Szymek200/Smart-ball/Documents/Smart-piłka_prez.pptx

## Smart-piłka

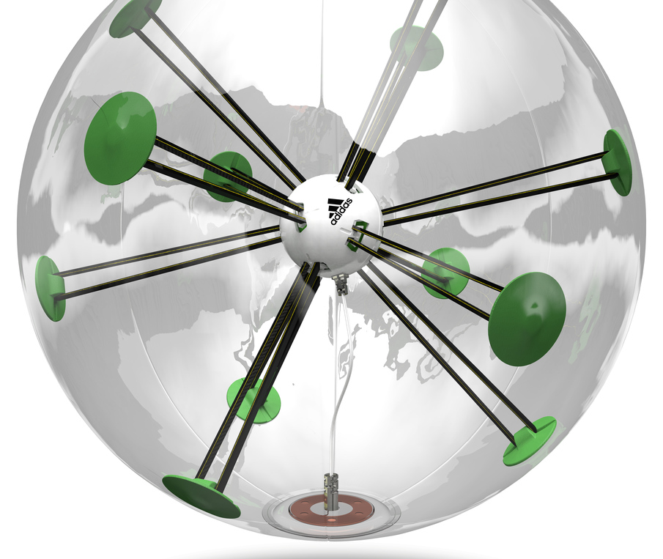
[picture p12: figure]
adidas smart ball Cheap Sale - OFF 55%

## Wymagania

- Wykrywanie:
  - Przyśpieszenia liniowego
  - przyśpieszenia kątowego
- Łączność bezprzewodowa do wymiany informacji z telefonem
  - Bluetooth

## Schemat blokowy systemu

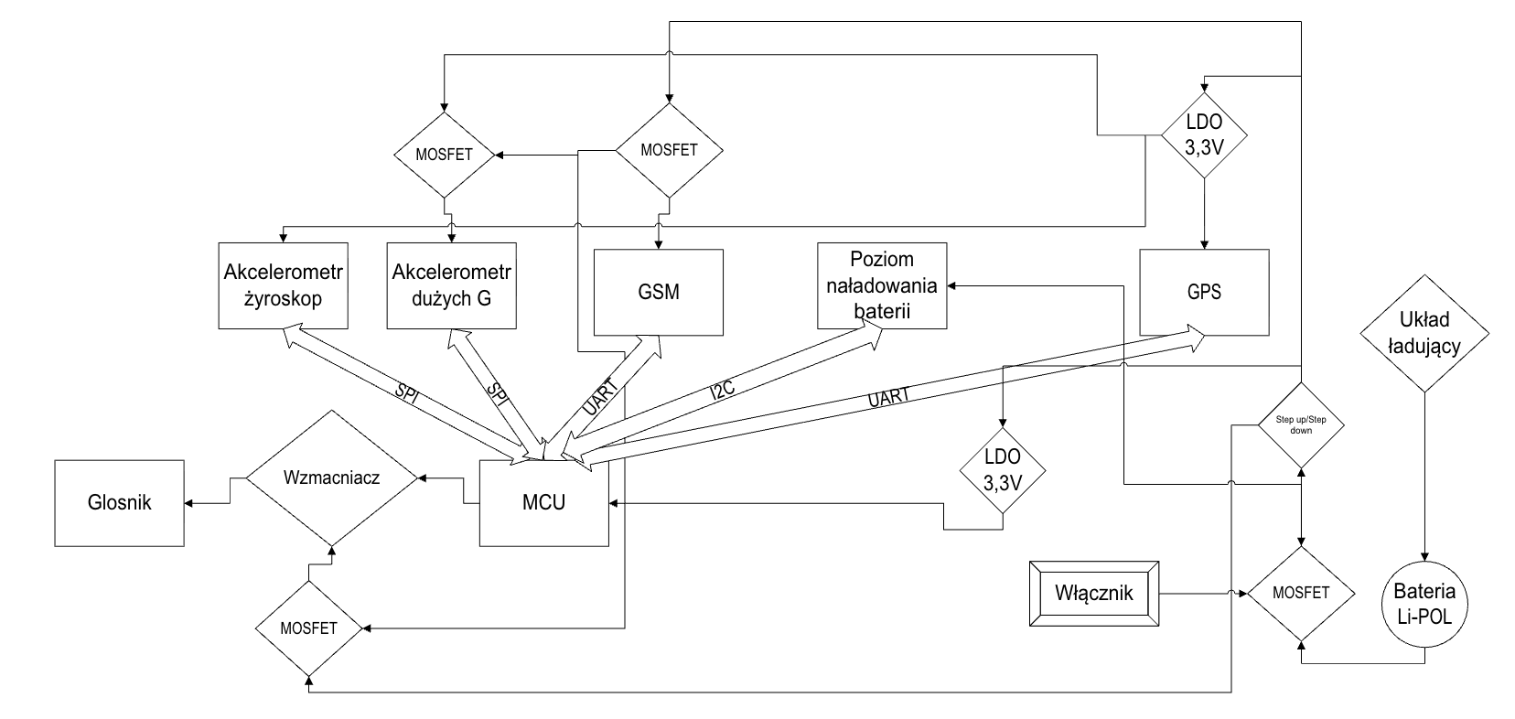
[picture p13: figure]

## Zasada działania

- Pomiary
- Gromadzenie i wyświetlanie informacji w aplikacji mobilnej
- Poszukiwanie zgubionej piłki za pomoca telefonu (GPS, głośnik, łączność z tel. poprzez GSM)

## Pomiary

- bezpośrednie
  - przyśpieszenie liniowe
  - prędkość kątowa
- pośrednie
  - podkręcenie piłki
  - efekt Magnusa – jak mocno piłka skręci
  - lokalizacja uderzenia piłki

## Funkcjonalności

- Wirtualny Asystent Techniki
- Generowanie trójwymiarowego modelu lotu piłki
- Heatmapa Boiska
- Ranking gracza – zestawienie online
- Dziennik postępów
- Analiza gry zespołowej – za pomocą tagów Bluetooth

## Statystyki

- prędkość wylotowa
- rotacja
- typ rotacji
- czas kontaktu
- dystans strzału
- czas lotu
- kąt wzniosu
- całkowity dystans ( czasie rozgrywki)
- liczba kontaktów
- intensywność gry
- liczba podbić - żonglerka

## Środowisko programistyczne

VS Code + ESP-IDF

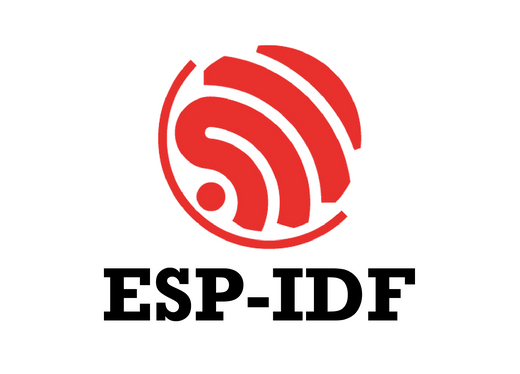
[picture p14: figure]
Getting Started With ESP-IDF | Set Up Espressif IDE – RoboticWorx
