Szymek200/Smart-ball/PCB/components_shopping.xlsx

Type | Product | Sposob montarzu | ilosc | price | Link
ladowarka indukcyjna | BQ51013BRHLR | smd |  | 13.00 PLN | https://www.mouser.pl/ProductDetail/Texas-Instruments/BQ51013BRHLR?qs=y1vSg4rOnUJlN8ZPg6D5Pw%3D%3D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
zabezpieczenie usb | USBLC6-2SC6Y |  |  | 1.66 PLN | https://www.mouser.pl/ProductDetail/STMicroelectronics/USBLC6-2SC6Y?qs=gNDSiZmRJS%2FOgDexvXkdow%3D%3D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
zlacze usb | UJ20-C-H-G-MSMT-P16-TR | Mid-Mount SMT |  | 2.30 PLN | https://www.mouser.pl/ProductDetail/Same-Sky/UJ20-C-H-G-MSMT-P16-TR?qs=IKkN%2F947nfDXyScpVo9Ppg%3D%3D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
battery charger | MCP73871-2CCI/ML | smd |  | 8.70 PLN | https://www.mouser.pl/ProductDetail/Microchip-Technology/MCP73871-2CCI-ML?qs=qXsUupcbpXyQfJ2clznZxw%3D%3D
battery measure | MAX17048G+T10 | smd |  | 15.00 PLN | https://www.mouser.pl/ProductDetail/Analog-Devices-Maxim-Integrated/MAX17048G%2BT10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
przelacznik bistabilny | SLW-1276864-4A-D |  |  | 2.70 PLN | https://www.mouser.pl/ProductDetail/Same-Sky/SLW-1276864-4A-D?qs=1Kr7Jg1SGW90vOt02EYiag%3D%3D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
zlacze ata | DS1013-40SSIB1-B-0 CONNFLY - Złącze IDC |  |  | 1.70 PLN | https://www.tme.eu/pl/details/zl231-40pg/zlacza-idc/connfly/ds1013-40ssib1-b-0/
akcelerometr | H3LIS331DLTR | smd |  | 42.50 PLN | https://www.mouser.pl/ProductDetail/STMicroelectronics/H3LIS331DLTR?qs=TAo1I7FhABsAZFqkqNUSRA%3D%3D
imu | LSM6DSV16BXTR | smd |  | 24.00 PLN | https://www.mouser.pl/ProductDetail/STMicroelectronics/LSM6DSV16BXTR?qs=vvQtp7zwQdMXKB4RqH7GHQ%3D%3D
5v | TPS61032PWPR | smd na zewnatrz |  | 16.00 PLN | https://www.mouser.pl/ProductDetail/Texas-Instruments/TPS61032PWPR?qs=Gse6rAGbi799IFpSGIkCOQ%3D%3D
3,3v | TPS63000IDRCRQ1 | smd |  | 11.00 PLN | https://www.mouser.pl/ProductDetail/Texas-Instruments/TPS63000IDRCRQ1?qs=i6VRxKQL%2FYw6zzUuY%2FiBvw%3D%3D
mcu | ESP32-S3-WROOM-1-N4R8 | smd |  | 22.00 PLN | https://www.mouser.pl/ProductDetail/Espressif-Systems/ESP32-S3-WROOM-1-N4R8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
push button | 1825910-6 |  | 2 | 0.50 PLN | https://www.mouser.pl/ProductDetail/TE-Connectivity/1825910-6?qs=A6cQTCBcXncisYDS1KbpGA%3D%3D
gps | NEO-F10N-00B | smd |  | 48.00 PLN | https://www.mouser.pl/ProductDetail/u-blox/NEO-F10N-00B?qs=Imq1NPwxi76uVH%2FItRhLgw%3D%3D
laczenie anten | 4259-63 | smd na zewnatrz |  | 2.80 PLN | https://www.mouser.pl/ProductDetail/pSemi/4259-63?qs=iw0hurA%2FaD37qvQcKdATTw%3D%3D
wzmacanicz glosnik | MAX98357AETE+T | smd |  | 13.06 PLN | https://www.mouser.pl/ProductDetail/Analog-Devices-Maxim-Integrated/MAX98357AETE%2BT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
gsm | SIM7000G | smd |  | 91.00 PLN | https://www.digikey.pl/pl/products/detail/simcom-wireless-solutions-limited/SIM7000G/15841469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
poziomy logiczne | TXB0104PWR | smd na zewnatrz |  | 3.70 PLN | https://www.mouser.pl/ProductDetail/Texas-Instruments/TXB0104PWR?qs=oFXvjAmG9EjSF69GpMWq5w%3D%3D
adapter sim | SIM8055-6-1-14-00-A |  |  | 4.75 PLN | https://www.mouser.pl/ProductDetail/GCT/SIM8055-6-1-14-00-A?qs=KUoIvG%2F9IlZoT561KmDa%252BQ%3D%3D
przelacznik 3 pozycje | SS14MDP2 |  |  | 10.30 PLN | https://www.mouser.pl/ProductDetail/NKK-Switches/SS14MDP2?qs=tJRqkAIQG4xAbyvlpPIZ4A%3D%3D
zasialnie 3.8v |  |  |  | 334.67 PLN
 | TPS62130RGTR |  |  | 12.00 PLN | https://www.mouser.pl/ProductDetail/Texas-Instruments/TPS62130RGTR?qs=gXEV9p%2FxLgcmDj5piyJ3pQ%3D%3D
alternatywy GSM
sim7080G
quectel BG95-M3
tranzystory |  |  | ilosc
 | SI2323DDS-T1-GE3 | smd na zewnatrz |  | 3.3 | https://www.mouser.pl/ProductDetail/Vishay-Semiconductors/SI2323DDS-T1-GE3?qs=vgn07B5hXavjZXK0uPQNiA%3D%3D
dioda prostownicza |  | smd | 2 |  | https://www.mouser.pl/ProductDetail/Vishay-Semiconductors/SS14-E3-61T?qs=x2jpVgRnAtMLNL7KZbtr8g%3D%3D
 | BSS138 | smd na zewnatrz |  | 1.5 | https://www.mouser.pl/ProductDetail/onsemi/BSS138?qs=HK%252BeIG1iaahCeqBvjB4arg%3D%3D
zlacze antenowe | U.FL-R-SMT(01) HIROSE - Złącze U.FL (IPX/AMC) |  |  | 5.2 | https://www.tme.eu/pl/details/u.fl-r-smt-01-/zlacza-mikro/hirose/u-fl-r-smt-01/?brutto=1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
zlacze glosnik na plytce | Connector_PinHeader_2.54mm:PinHeader_1x02_P2.54mm_Vertical
cewki do indukcji |  |  |  |  | https://botland.com.pl/moduly-zasilajace/5495-modul-bezprzewodowego-zasilania-5v-1a-6959420902941.html
przewod | JST-XH (2.54 mm):
dioda prostownicza | https://www.tme.eu/pl/details/ss14-dc/diody-schottky-smd/dc-components/ss14/
 | zwykle rezystory
 | Resistor_THT:R_Axial_DIN0207_L6.3mm_D2.5mm_P7.62mm_Horizontal
 | wartosc | ilosc
 | zwykle kondensatory - z drucikami
 | wartosc | ilosc
