Szymek200/Smart-ball/PCB/final_jlc_components/mcu_ai_bom.csv

Designator | Footprint | Quantity | Value | LCSC Part #
IC3 | ESP32S3WROOM1N4R8 | 1 | ESP32-S3-WROOM-1-N4R8
IC8 | QFN50P300X300X80-17N | 1 | MAX98357AETE+T
J6 | GCT_SIM8055-6-1-14-00-A | 1 | SIM8055-6-1-14-00-A
