Szymek200/Smart-ball/PCB/buying_componets.xlsx

Sheet: wszystkie
Designator | Footprint | Quantity | Value
C1, C26 | C_Disc_D5.0mm_W2.5mm_P2.50mm | 2 | 1μF
C12, C13 | C_Disc_D5.0mm_W2.5mm_P2.50mm | 2 | 0F
C2, C3 | C_Disc_D5.0mm_W2.5mm_P2.50mm | 2 | 100nF
C22 | C_Disc_D5.0mm_W2.5mm_P2.50mm | 1 | 1000nF
C23 | CP_Radial_Tantal_D5.0mm_P2.50mm | 1 | 1000µF
C24, C25 | CP_Radial_Tantal_D5.0mm_P2.50mm | 2 | 100µF
C4 | CP_Radial_Tantal_D5.0mm_P2.50mm | 1 | 1μF
C8 | C_Disc_D5.0mm_W2.5mm_P2.50mm | 1 | 100 nF
D1 | PMEG3005AESFYL | 1 | PESD5V0C1BSFYL
D4 | D_DO-41_SOD81_P7.62mm_Horizontal | 1 | LED
FB1 | 805 | 1 | 280Ω
IC1 | NEOF10N00B | 1 | NEO-F10N-00B
IC2 | SOP65P640X120-14N | 1 | TXB0104PWR
IC3 | ESP32S3WROOM1N4R8 | 1 | ESP32-S3-WROOM-1-N4R8
IC6 | SOT65P210X110-6N | 1 | 4259-63
IC8 | QFN50P300X300X80-17N | 1 | MAX98357AETE+T
J1 | DS101340SSIB1B0 | 1 | DS1013-40SSIB1-B-0
J4 | U.FL_Molex_MCRF_73412-0110_Vertical | 1 | FXP612 (u.FL) 2
J5, J7 | U.FL_Molex_MCRF_73412-0110_Vertical | 2 | FXP612 (u.FL) 1
J6 | GCT_SIM8055-6-1-14-00-A | 1 | SIM8055-6-1-14-00-A
Q3 | SOT95P237X112-3N | 1 | Si2323DDS-T1-GE3
Q5 | SOT95P240X120-3N | 1 | BSS138
R16, R26 | R_Axial_DIN0207_L6.3mm_D2.5mm_P7.62mm_Horizontal | 2 | 100kΩ
R17, R19, R28, R29, R30 | R_Axial_DIN0207_L6.3mm_D2.5mm_P7.62mm_Horizontal | 5 | 10kΩ
R18 | R_Axial_DIN0207_L6.3mm_D2.5mm_P7.62mm_Horizontal | 1 | 330Ω
R20, R21 | R_Axial_DIN0207_L6.3mm_D2.5mm_P7.62mm_Horizontal | 2 | 0Ω
S1, S4 | 18259106 | 2 | 1825910-6
TP1 | TestPoint_THTPad_D2.0mm_Drill1.0mm | 1 | USB_DP
TP2 | TestPoint_THTPad_D2.0mm_Drill1.0mm | 1 | BOOT_CFG
TP3 | TestPoint_THTPad_D2.0mm_Drill1.0mm | 1 | USB_DM
TP4 | TestPoint_THTPad_D2.0mm_Drill1.0mm | 1 | USB_VBUS
TP5 | TestPoint_THTPad_D2.0mm_Drill1.0mm | 1 | MDM_LOG_TX
TP6 | TestPoint_THTPad_D2.0mm_Drill1.0mm | 1 | TestPoint
U2 | SIM7000G | 1 | SIM7000G
power board
Designator | Footprint | Quantity | Value
AC1 | LIS3DHTR | 1 | H3LIS331DLTR
BT2 | SolderWire-0.75sqmm_1x02_P4.8mm_D1.25mm_OD2.3mm | 1 | Battery
C1, C3, C34, C37, C5, C6 | C_Disc_D5.0mm_W2.5mm_P2.50mm | 6 | 10μF
C19, C23, C25, C30, C31 | CP_Radial_Tantal_D5.0mm_P2.50mm | 5 | 10µF
C2 | C_Disc_D5.0mm_W2.5mm_P2.50mm | 1 | 0.1μF
C20 | CP_Radial_Tantal_D5.0mm_P2.50mm | 1 | C1
C21, C29 | CP_Radial_Tantal_D5.0mm_P2.50mm | 2 | 22µF
C22 | CP_Radial_Tantal_D5.0mm_P2.50mm | 1 | 1µF
C24, C27 | CP_Radial_Tantal_D5.0mm_P2.50mm | 2 | 0.47µF
C26 | CP_Radial_Tantal_D5.0mm_P2.50mm | 1 | C2
C28 | CP_Radial_Tantal_D5.0mm_P2.50mm | 1 | 20µF
C32 | CP_Radial_Tantal_D5.0mm_P2.50mm | 1 | 4.7µF
C33 | CP_Radial_Tantal_D5.0mm_P2.50mm | 1 | 0.1µF
C35 | C_Disc_D5.0mm_W2.5mm_P2.50mm | 1 | 2.2µF
C4 | C_Disc_D5.0mm_W2.5mm_P2.50mm | 1 | 220µF
D1, D6 | D_DO-41_SOD81_P7.62mm_Horizontal | 2 | LED
D5, D7 | DIOM5227X270N | 2 | SS14
D8 | SOT95P280X145-6N | 1 | USBLC6-2SC6Y
IC1 | QFN50P300X300X100-17N-D | 1 | TPS6213013AQRGTTQ1
IC10 | LSM6DSV16BXTR | 1 | LSM6DSV16BXTR
IC11 | SOP65P640X120-17N | 1 | TPS61032PWP
IC7 | BQ51050BRHLR | 1 | BQ51013BRHLR
IC8 | TPS63000IDRCRQ1 | 1 | TPS63000IDRCRQ1
IC9 | SON50P200X200X80-9N-D | 1 | MAX17048G+T10
J1 | PinHeader_1x02_P2.54mm_Vertical | 1 | Speaker_con
J2 | DS101340SSIB1B0 | 1 | DS1013-40SSIB1-B-0
J3 | GCT_USB4110GFA | 1 | USB4110GFA
L1, L3 | L_Axial_L7.0mm_D3.3mm_P10.16mm_Horizontal_Fastron_MICC | 2 | 2.2µH
L4 | L_Axial_L7.0mm_D3.3mm_P10.16mm_Horizontal_Fastron_MICC | 1 | 6.8µH
Q2 | SOT95P237X112-3N | 1 | Si2323DDS-T1-GE3
Q3 | SOT95P240X120-3N | 1 | BSS138
R17, R34 | R_Axial_DIN0207_L6.3mm_D2.5mm_P7.62mm_Horizontal | 2 | 1kΩ
R18 | R_Axial_DIN0207_L6.3mm_D2.5mm_P7.62mm_Horizontal | 1 | 1.5kΩ
R19, R31, R38, R42 | R_Axial_DIN0207_L6.3mm_D2.5mm_P7.62mm_Horizontal | 4 | 100kΩ
R20 | R_Axial_DIN0207_L6.3mm_D2.5mm_P7.62mm_Horizontal | 1 | 66Ω
R21, R22, R23 | R_Axial_DIN0207_L6.3mm_D2.5mm_P7.62mm_Horizontal | 3 | 10Ω
R24 | R_Axial_DIN0207_L6.3mm_D2.5mm_P7.62mm_Horizontal | 1 | 200Ω
R25 | R_Axial_DIN0207_L6.3mm_D2.5mm_P7.62mm_Horizontal | 1 | 20kΩ
R26 | R_Axial_DIN0207_L6.3mm_D2.5mm_P7.62mm_Horizontal | 1 | 1MΩ
R27, R32 | R_Axial_DIN0207_L6.3mm_D2.5mm_P7.62mm_Horizontal | 2 | 5.1kΩ
R28 | R_Axial_DIN0207_L6.3mm_D2.5mm_P7.62mm_Horizontal | 1 | 180kΩ
R29, R30 | R_Axial_DIN0207_L6.3mm_D2.5mm_P7.62mm_Horizontal | 2 | 4.7kΩ
R33, R37, R41, TH4 | R_Axial_DIN0207_L6.3mm_D2.5mm_P7.62mm_Horizontal | 4 | 10kΩ
R35 | R_Axial_DIN0207_L6.3mm_D2.5mm_P7.62mm_Horizontal | 1 | 330kΩ
R36 | R_Axial_DIN0207_L6.3mm_D2.5mm_P7.62mm_Horizontal | 1 | 110kΩ
R39 | R_Axial_DIN0207_L6.3mm_D2.5mm_P7.62mm_Horizontal | 1 | 200kΩ
R40 | R_Axial_DIN0207_L6.3mm_D2.5mm_P7.62mm_Horizontal | 1 | 750kΩ
S2 | SLW12768644AD | 1 | SLW-1276864-4A-D
U2 | QFN-20-1EP_4x4mm_P0.5mm_EP2.5x2.5mm | 1 | MCP73871-2CA

Sheet: R and C
Designator | Footprint | Quantity | Value
C1, C26 | C_Disc_D5.0mm_W2.5mm_P2.50mm | 2 | 1μF
C12, C13 | C_Disc_D5.0mm_W2.5mm_P2.50mm | 2 | 0F
C2, C3 | C_Disc_D5.0mm_W2.5mm_P2.50mm | 2 | 100nF
C22 | C_Disc_D5.0mm_W2.5mm_P2.50mm | 1 | 1000nF
C23 | CP_Radial_Tantal_D5.0mm_P2.50mm | 1 | 1000µF
C24, C25 | CP_Radial_Tantal_D5.0mm_P2.50mm | 2 | 100µF
C4 | CP_Radial_Tantal_D5.0mm_P2.50mm | 1 | 1μF
C8 | C_Disc_D5.0mm_W2.5mm_P2.50mm | 1 | 100 nF
C1, C3, C34, C37, C5, C6 | C_Disc_D5.0mm_W2.5mm_P2.50mm | 6 | 10μF
C19, C23, C25, C30, C31 | CP_Radial_Tantal_D5.0mm_P2.50mm | 5 | 10µF
C2 | C_Disc_D5.0mm_W2.5mm_P2.50mm | 1 | 0.1μF
C20 | CP_Radial_Tantal_D5.0mm_P2.50mm | 1 | C1
C21, C29 | CP_Radial_Tantal_D5.0mm_P2.50mm | 2 | 22µF
C22 | CP_Radial_Tantal_D5.0mm_P2.50mm | 1 | 1µF
C24, C27 | CP_Radial_Tantal_D5.0mm_P2.50mm | 2 | 0.47µF
C26 | CP_Radial_Tantal_D5.0mm_P2.50mm | 1 | C2
C28 | CP_Radial_Tantal_D5.0mm_P2.50mm | 1 | 20µF
C32 | CP_Radial_Tantal_D5.0mm_P2.50mm | 1 | 4.7µF
C33 | CP_Radial_Tantal_D5.0mm_P2.50mm | 1 | 0.1µF
C35 | C_Disc_D5.0mm_W2.5mm_P2.50mm | 1 | 2.2µF
C4 | C_Disc_D5.0mm_W2.5mm_P2.50mm | 1 | 220µF
R17, R34 | R_Axial_DIN0207_L6.3mm_D2.5mm_P7.62mm_Horizontal | 2 | 1kΩ
R18 | R_Axial_DIN0207_L6.3mm_D2.5mm_P7.62mm_Horizontal | 1 | 1.5kΩ
R19, R31, R38, R42 | R_Axial_DIN0207_L6.3mm_D2.5mm_P7.62mm_Horizontal | 4 | 100kΩ
R20 | R_Axial_DIN0207_L6.3mm_D2.5mm_P7.62mm_Horizontal | 1 | 66Ω
R21, R22, R23 | R_Axial_DIN0207_L6.3mm_D2.5mm_P7.62mm_Horizontal | 3 | 10Ω
R24 | R_Axial_DIN0207_L6.3mm_D2.5mm_P7.62mm_Horizontal | 1 | 200Ω
R25 | R_Axial_DIN0207_L6.3mm_D2.5mm_P7.62mm_Horizontal | 1 | 20kΩ
R26 | R_Axial_DIN0207_L6.3mm_D2.5mm_P7.62mm_Horizontal | 1 | 1MΩ
R27, R32 | R_Axial_DIN0207_L6.3mm_D2.5mm_P7.62mm_Horizontal | 2 | 5.1kΩ
R28 | R_Axial_DIN0207_L6.3mm_D2.5mm_P7.62mm_Horizontal | 1 | 180kΩ
R29, R30 | R_Axial_DIN0207_L6.3mm_D2.5mm_P7.62mm_Horizontal | 2 | 4.7kΩ
R33, R37, R41, TH4 | R_Axial_DIN0207_L6.3mm_D2.5mm_P7.62mm_Horizontal | 4 | 10kΩ
R35 | R_Axial_DIN0207_L6.3mm_D2.5mm_P7.62mm_Horizontal | 1 | 330kΩ
R36 | R_Axial_DIN0207_L6.3mm_D2.5mm_P7.62mm_Horizontal | 1 | 110kΩ
R39 | R_Axial_DIN0207_L6.3mm_D2.5mm_P7.62mm_Horizontal | 1 | 200kΩ
R40 | R_Axial_DIN0207_L6.3mm_D2.5mm_P7.62mm_Horizontal | 1 | 750kΩ

Sheet: Sheet3
Row Labels | Sum of Quantity
C_Disc_D5.0mm_W2.5mm_P2.50mm | 17
0.1μF | 1
0F | 2
100 nF | 1
1000nF | 1
100nF | 2
10μF | 6
1μF | 2
2.2µF | 1
220µF | 1
CP_Radial_Tantal_D5.0mm_P2.50mm | 19
0.1µF | 1
0.47µF | 2
1000µF | 1
100µF | 2
10µF | 5
1μF | 1
1µF | 1
20µF | 1
22µF | 2
4.7µF | 1
C1 | 1
C2 | 1
R_Axial_DIN0207_L6.3mm_D2.5mm_P7.62mm_Horizontal | 27
1.5kΩ | 1
100kΩ | 4
10kΩ | 4
10Ω | 3
110kΩ | 1
180kΩ | 1
1kΩ | 2
1MΩ | 1
200kΩ | 1
200Ω | 1
20kΩ | 1
330kΩ | 1
4.7kΩ | 2
5.1kΩ | 2
66Ω | 1
750kΩ | 1
Grand Total | 63

Sheet: R_C_grouped
Footprint | Quantity | Value
C_Disc_D5.0mm_W2.5mm_P2.50mm | 2 | 1μF
C_Disc_D5.0mm_W2.5mm_P2.50mm | 2 | 0F
C_Disc_D5.0mm_W2.5mm_P2.50mm | 2 | 100nF
C_Disc_D5.0mm_W2.5mm_P2.50mm | 1 | 1000nF
CP_Radial_Tantal_D5.0mm_P2.50mm | 1 | 1000µF
CP_Radial_Tantal_D5.0mm_P2.50mm | 2 | 100µF
CP_Radial_Tantal_D5.0mm_P2.50mm | 1 | 1μF
C_Disc_D5.0mm_W2.5mm_P2.50mm | 1 | 100 nF
C_Disc_D5.0mm_W2.5mm_P2.50mm | 6 | 10μF
CP_Radial_Tantal_D5.0mm_P2.50mm | 5 | 10µF
C_Disc_D5.0mm_W2.5mm_P2.50mm | 1 | 0.1μF
CP_Radial_Tantal_D5.0mm_P2.50mm | 1 | C1
CP_Radial_Tantal_D5.0mm_P2.50mm | 2 | 22µF
CP_Radial_Tantal_D5.0mm_P2.50mm | 1 | 1µF
CP_Radial_Tantal_D5.0mm_P2.50mm | 2 | 0.47µF
CP_Radial_Tantal_D5.0mm_P2.50mm | 1 | C2
CP_Radial_Tantal_D5.0mm_P2.50mm | 1 | 20µF
CP_Radial_Tantal_D5.0mm_P2.50mm | 1 | 4.7µF
CP_Radial_Tantal_D5.0mm_P2.50mm | 1 | 0.1µF
C_Disc_D5.0mm_W2.5mm_P2.50mm | 1 | 2.2µF
C_Disc_D5.0mm_W2.5mm_P2.50mm | 1 | 220µF
R_Axial_DIN0207_L6.3mm_D2.5mm_P7.62mm_Horizontal | 2 | 1kΩ
R_Axial_DIN0207_L6.3mm_D2.5mm_P7.62mm_Horizontal | 1 | 1.5kΩ
R_Axial_DIN0207_L6.3mm_D2.5mm_P7.62mm_Horizontal | 4 | 100kΩ
R_Axial_DIN0207_L6.3mm_D2.5mm_P7.62mm_Horizontal | 1 | 66Ω
R_Axial_DIN0207_L6.3mm_D2.5mm_P7.62mm_Horizontal | 3 | 10Ω
R_Axial_DIN0207_L6.3mm_D2.5mm_P7.62mm_Horizontal | 1 | 200Ω
R_Axial_DIN0207_L6.3mm_D2.5mm_P7.62mm_Horizontal | 1 | 20kΩ
R_Axial_DIN0207_L6.3mm_D2.5mm_P7.62mm_Horizontal | 1 | 1MΩ
R_Axial_DIN0207_L6.3mm_D2.5mm_P7.62mm_Horizontal | 2 | 5.1kΩ
R_Axial_DIN0207_L6.3mm_D2.5mm_P7.62mm_Horizontal | 1 | 180kΩ
R_Axial_DIN0207_L6.3mm_D2.5mm_P7.62mm_Horizontal | 2 | 4.7kΩ
R_Axial_DIN0207_L6.3mm_D2.5mm_P7.62mm_Horizontal | 4 | 10kΩ
R_Axial_DIN0207_L6.3mm_D2.5mm_P7.62mm_Horizontal | 1 | 330kΩ
R_Axial_DIN0207_L6.3mm_D2.5mm_P7.62mm_Horizontal | 1 | 110kΩ
R_Axial_DIN0207_L6.3mm_D2.5mm_P7.62mm_Horizontal | 1 | 200kΩ
R_Axial_DIN0207_L6.3mm_D2.5mm_P7.62mm_Horizontal | 1 | 750kΩ

Sheet: bez R
Designator | Footprint | Quantity | Value | LCSC Part #
D1 | PMEG3005AESFYL | 1 | PESD5V0C1BSFYL
FB1 | 805 | 1 | 280Ω
IC1 | NEOF10N00B | 1 | NEO-F10N-00B
IC2 | SOP65P640X120-14N | 1 | TXB0104PWR
IC3 | ESP32S3WROOM1N4R8 | 1 | ESP32-S3-WROOM-1-N4R8
IC6 | SOT65P210X110-6N | 1 | 4259-63
IC8 | QFN50P300X300X80-17N | 1 | MAX98357AETE+T
J1 | DS101340SSIB1B0 | 1 | DS1013-40SSIB1-B-0
J4 | U.FL_Molex_MCRF_73412-0110_Vertical | 1 | FXP612 (u.FL) 2
J5, J7 | U.FL_Molex_MCRF_73412-0110_Vertical | 2 | FXP612 (u.FL) 1
J6 | GCT_SIM8055-6-1-14-00-A | 1 | SIM8055-6-1-14-00-A
Q3 | SOT95P237X112-3N | 1 | Si2323DDS-T1-GE3
Q5 | SOT95P240X120-3N | 1 | BSS138
S1, S4 | 18259106 | 2 | 1825910-6
TP1 | TestPoint_THTPad_D2.0mm_Drill1.0mm | 1 | USB_DP
TP2 | TestPoint_THTPad_D2.0mm_Drill1.0mm | 1 | BOOT_CFG
TP3 | TestPoint_THTPad_D2.0mm_Drill1.0mm | 1 | USB_DM
TP4 | TestPoint_THTPad_D2.0mm_Drill1.0mm | 1 | USB_VBUS
TP5 | TestPoint_THTPad_D2.0mm_Drill1.0mm | 1 | MDM_LOG_TX
TP6 | TestPoint_THTPad_D2.0mm_Drill1.0mm | 1 | TestPoint
U2 | SIM7000G | 1 | SIM7000G
power board
Designator | Footprint | Quantity | Value | LCSC Part #
AC1 | LIS3DHTR | 1 | H3LIS331DLTR
BT2 | SolderWire-0.75sqmm_1x02_P4.8mm_D1.25mm_OD2.3mm | 1 | Battery
D5, D7 | DIOM5227X270N | 2 | SS14
D8 | SOT95P280X145-6N | 1 | USBLC6-2SC6Y
IC1 | QFN50P300X300X100-17N-D | 1 | TPS6213013AQRGTTQ1
IC10 | LSM6DSV16BXTR | 1 | LSM6DSV16BXTR
IC11 | SOP65P640X120-17N | 1 | TPS61032PWP
IC7 | BQ51050BRHLR | 1 | BQ51013BRHLR
IC8 | TPS63000IDRCRQ1 | 1 | TPS63000IDRCRQ1
IC9 | SON50P200X200X80-9N-D | 1 | MAX17048G+T10
J1 | PinHeader_1x02_P2.54mm_Vertical | 1 | Speaker_con
J2 | DS101340SSIB1B0 | 1 | DS1013-40SSIB1-B-0
J3 | GCT_USB4110GFA | 1 | USB4110GFA
L1, L3 | L_Axial_L7.0mm_D3.3mm_P10.16mm_Horizontal_Fastron_MICC | 2 | 2.2µH
L4 | L_Axial_L7.0mm_D3.3mm_P10.16mm_Horizontal_Fastron_MICC | 1 | 6.8µH
Q2 | SOT95P237X112-3N | 1 | Si2323DDS-T1-GE3
Q3 | SOT95P240X120-3N | 1 | BSS138
S2 | SLW12768644AD | 1 | SLW-1276864-4A-D
U2 | QFN-20-1EP_4x4mm_P0.5mm_EP2.5x2.5mm | 1 | MCP73871-2CA

Sheet: zakupy_final
Designator | Footprint | Quantity | Value | LCSC Part #
D1 | PMEG3005AESFYL | 1 | PESD5V0C1BSFYL
FB1 | 805 | 1 | 280Ω |  | ferrat bead
IC1 | NEOF10N00B | 1 | NEO-F10N-00B
IC2 | SOP65P640X120-14N | 1 | TXB0104PWR
IC3 | ESP32S3WROOM1N4R8 | 1 | ESP32-S3-WROOM-1-N4R8
IC6 | SOT65P210X110-6N | 1 | 4259-63
IC8 | QFN50P300X300X80-17N | 1 | MAX98357AETE+T
J1 | DS101340SSIB1B0 | 1 | DS1013-40SSIB1-B-0
J4 | U.FL_Molex_MCRF_73412-0110_Vertical | 3 | FXP612 (u.FL) 2
J6 | GCT_SIM8055-6-1-14-00-A | 1 | SIM8055-6-1-14-00-A
Q3 | SOT95P237X112-3N | 2 | Si2323DDS-T1-GE3
Q5 | SOT95P240X120-3N | 2 | BSS138
S1, S4 | 18259106 | 2 | 1825910-6
U2 | SIM7000G | 1 | SIM7000G
power board
Designator | Footprint | Quantity | Value | LCSC Part #
AC1 | LIS3DHTR | 1 | H3LIS331DLTR
BT2 | SolderWire-0.75sqmm_1x02_P4.8mm_D1.25mm_OD2.3mm | 1 | Battery
D5, D7 | DIOM5227X270N | 2 | SS14
D8 | SOT95P280X145-6N | 1 | USBLC6-2SC6Y
IC1 | QFN50P300X300X100-17N-D | 1 | TPS6213013AQRGTTQ1
IC10 | LSM6DSV16BXTR | 1 | LSM6DSV16BXTR
IC11 | SOP65P640X120-17N | 1 | TPS61032PWP
IC7 | BQ51050BRHLR | 1 | BQ51013BRHLR
IC8 | TPS63000IDRCRQ1 | 1 | TPS63000IDRCRQ1
IC9 | SON50P200X200X80-9N-D | 1 | MAX17048G+T10
J1 | PinHeader_1x02_P2.54mm_Vertical | 1 | Speaker_con
J2 | DS101340SSIB1B0 | 1 | DS1013-40SSIB1-B-0
J3 | GCT_USB4110GFA | 1 | USB4110GFA
U2 | QFN-20-1EP_4x4mm_P0.5mm_EP2.5x2.5mm | 1 | MCP73871-2CA
 | ladowarka bezprzewodowa |  | https://www.tme.eu/pl/details/u.fl-r-smt-01-/zlacza-mikro/hirose/u-fl-r-smt-01/?brutto=1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
 | glosnik 3W
 | antena gsm
 | anteny gps

Sheet: do zakupu
Designator | Footprint | Quantity | Value | LCSC Part # | tme | aliekspres
D1 | PMEG3005AESFYL | 1 | PESD5V0C1BSFYL
FB1 | 805 | 1 | 280Ω
IC1 | NEOF10N00B | 1 | NEO-F10N-00B
IC2 | SOP65P640X120-14N | 1 | TXB0104PWR
IC3 | ESP32S3WROOM1N4R8 | 1 | ESP32-S3-WROOM-1-N4R8
IC6 | SOT65P210X110-6N | 1 | 4259-63
J1 | DS101340SSIB1B0 | 2 | DS1013-40SSIB1-B-0
J5, J7 | U.FL_Molex_MCRF_73412-0110_Vertical | 3 | FXP612 (u.FL) 1
J6 | GCT_SIM8055-6-1-14-00-A | 1 | SIM8055-6-1-14-00-A
Q3 | SOT95P237X112-3N | 2 | Si2323DDS-T1-GE3
Q5 | SOT95P240X120-3N | 2 | BSS138
U2 | SIM7000G | 1 | SIM7000G |  |  | https://pl.aliexpress.com/item/1005008560522229.html?curPageLogUid=h21JYhJJcjez
S1, S4 | 18259106 | 2 | 1825910-6 | przyciski
BT2 | SolderWire-0.75sqmm_1x02_P4.8mm_D1.25mm_OD2.3mm | 1 | Battery
D5, D7 | DIOM5227X270N | 2 | SS14
D8 | SOT95P280X145-6N | 1 | USBLC6-2SC6Y
IC1 | QFN50P300X300X100-17N-D | 1 | TPS6213013AQRGTTQ1
IC11 | SOP65P640X120-17N | 1 | TPS61032PWP
J1 | PinHeader_1x02_P2.54mm_Vertical | 1 | Speaker_con
J2
J3 | GCT_USB4110GFA | 1 | USB4110GFA | powinno byc w jlc
S2 | SLW12768644AD | 1 | SLW-1276864-4A-D
U2
antena gps
antena gsm
