Szymek200/Smart-ball/PCB/COMPONENTS/invoice.pdf

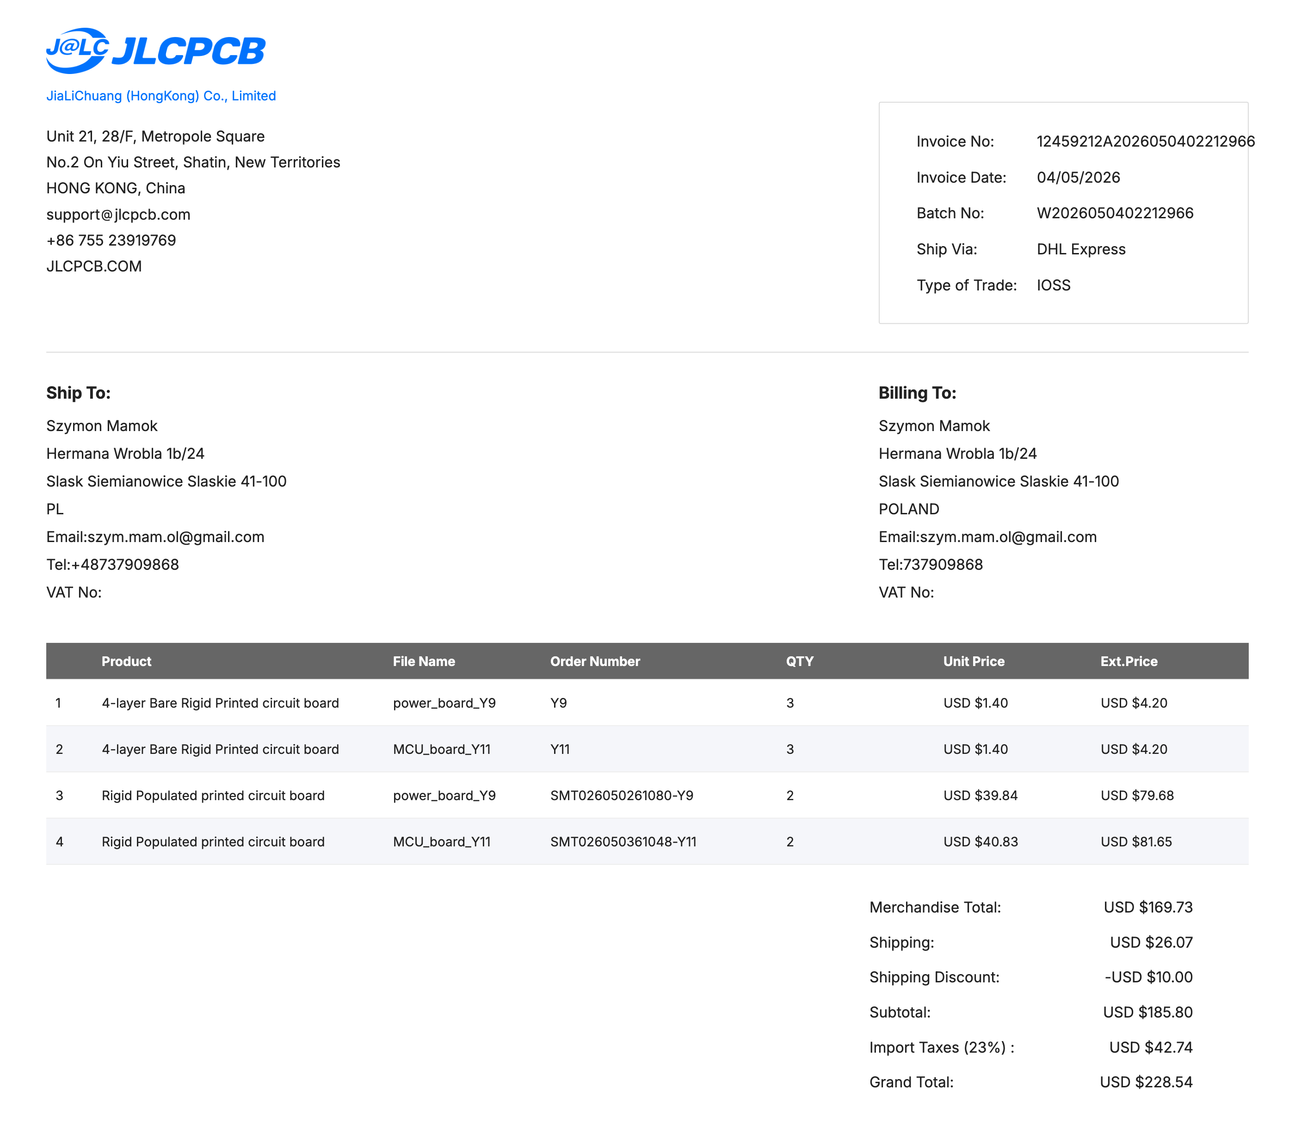
[picture p15: page 1]
