Szymek200/Smart-ball/PCB/COMPONENTS/salesContract.pdf

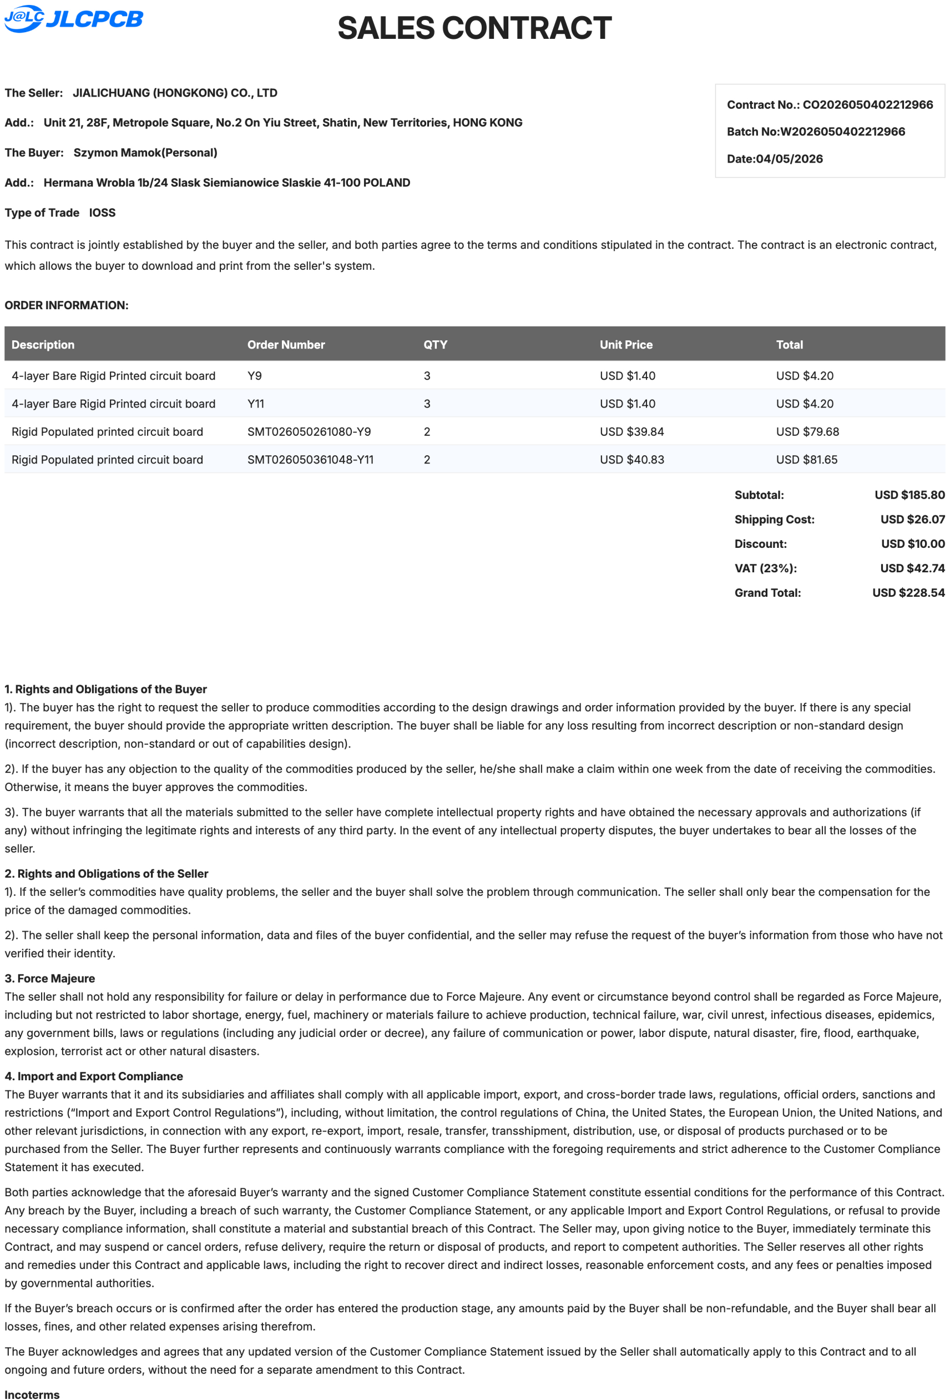
[picture p16: page 1]

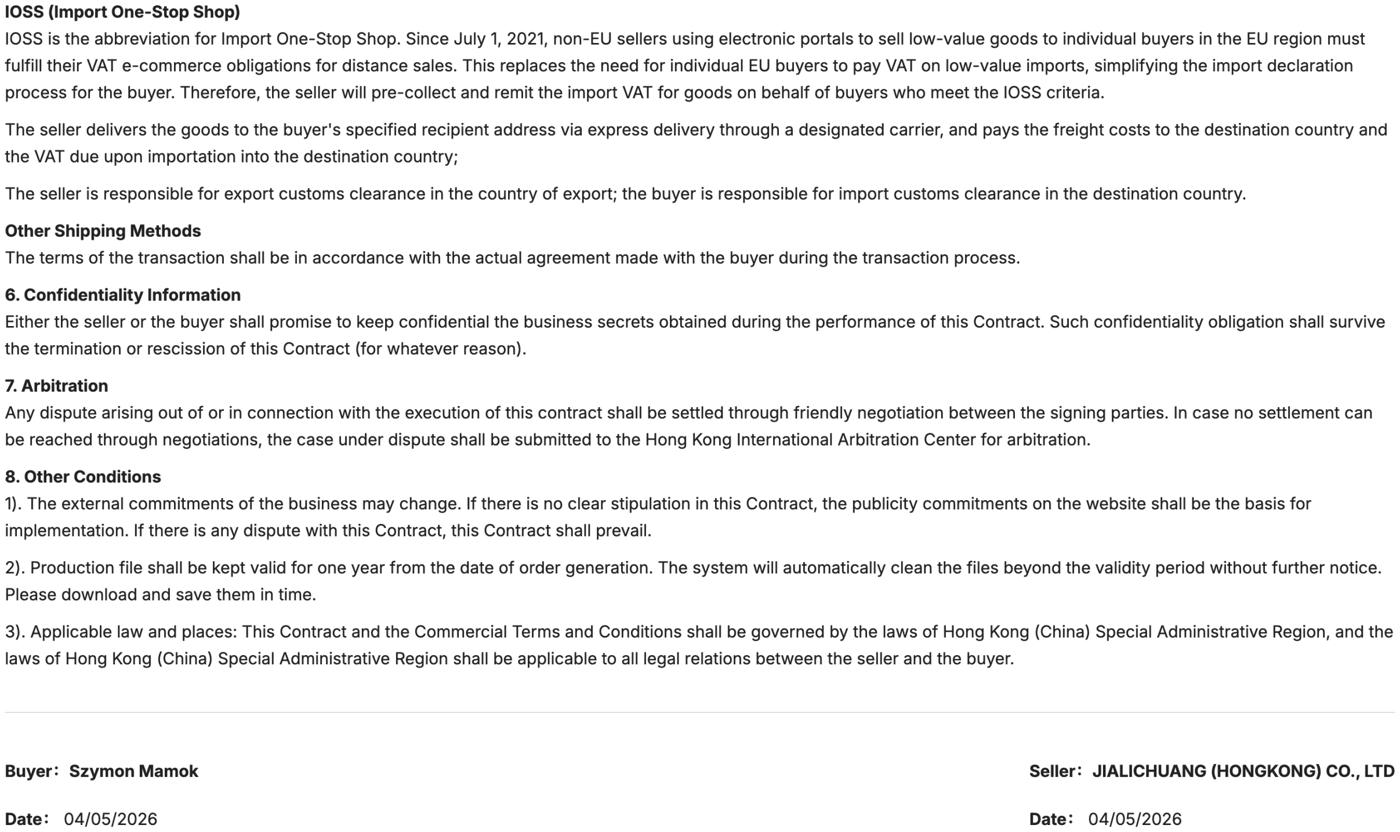
[picture p17: figure]
