Szymek200/Smart-ball/DataSheets/KicadElements/LIB_2N7002/2N7002/3D/2N7002.stp

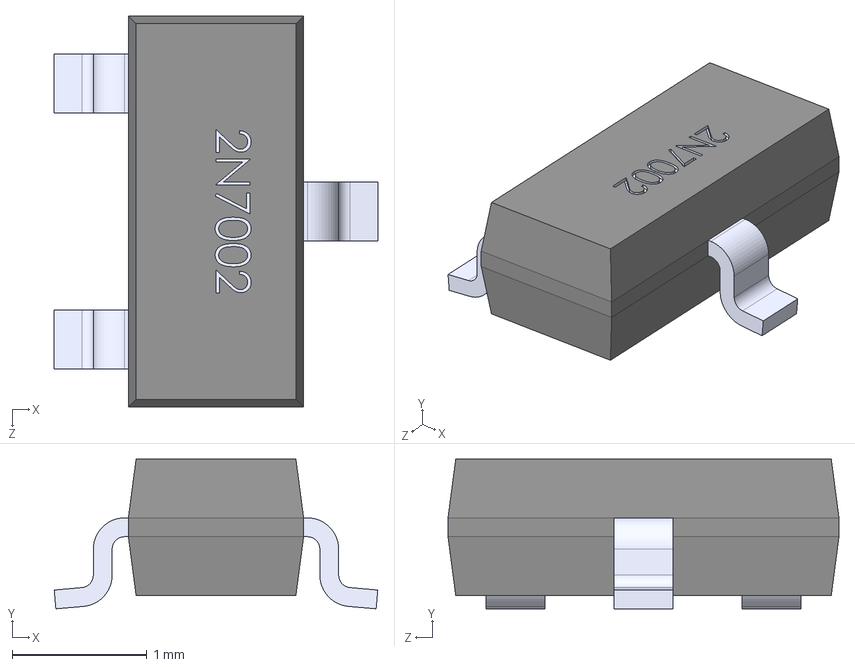
[picture p18: CAD file, 2026-04-19]
DataSheets/KicadElements/LIB_2N7002/2N7002/3D/2N7002.stp
2.40 x 1.11 x 2.90 mm
2N7002_2
2N7002_3
2N7002_4
2N7002
