Szymek200/Smart-ball/DataSheets/KicadElements/LIB_DS1013-20SSIB1-B-0/DS1013-20SSIB1-B-0/3D/DS1013-20SSIB1-B-0.stp

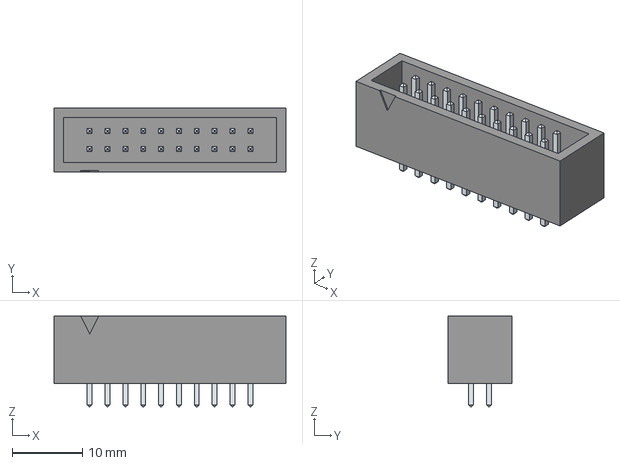
[picture p19: CAD file, 2026-04-16]
DataSheets/KicadElements/LIB_DS1013-20SSIB1-B-0/DS1013-20SSIB1-B-0/3D/DS1013-20SSIB1-B-0.stp
33.0 x 9.10 x 12.9 mm
LeadsArray
