Szymek200/Smart-ball/DataSheets/KicadElements/LIB_DS1013-40SSIB1-B-0/DS1013-40SSIB1-B-0/3D/DS1013-40SSIB1-B-0.stp

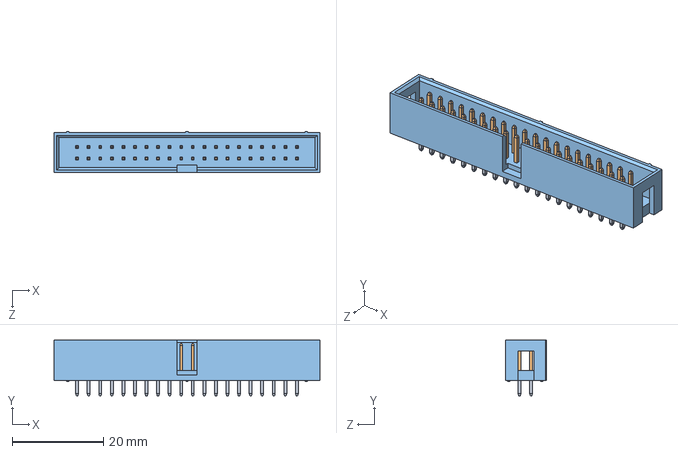
[picture p20: CAD file, 2026-04-16]
DataSheets/KicadElements/LIB_DS1013-40SSIB1-B-0/DS1013-40SSIB1-B-0/3D/DS1013-40SSIB1-B-0.stp
58.4 x 12.2 x 9.10 mm
