Szymek200/Smart-ball/DataSheets/KicadElements/LIB_PESD3V3L1BSLZ/PESD3V3L1BSLZ/3D/PESD3V3L1BSLZ.stp

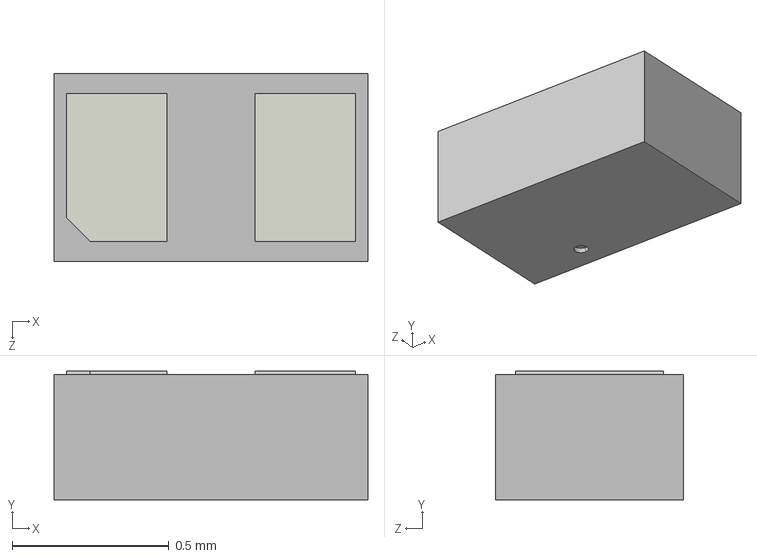
[picture p21: CAD file, 2026-04-08]
DataSheets/KicadElements/LIB_PESD3V3L1BSLZ/PESD3V3L1BSLZ/3D/PESD3V3L1BSLZ.stp
1.00 x 0.41 x 0.6 mm
