Szymek200/Smart-ball/DataSheets/KicadElements/LIB_PESD5V0C1BSFYL/PESD5V0C1BSFYL/3D/PESD5V0C1BSFYL.stp

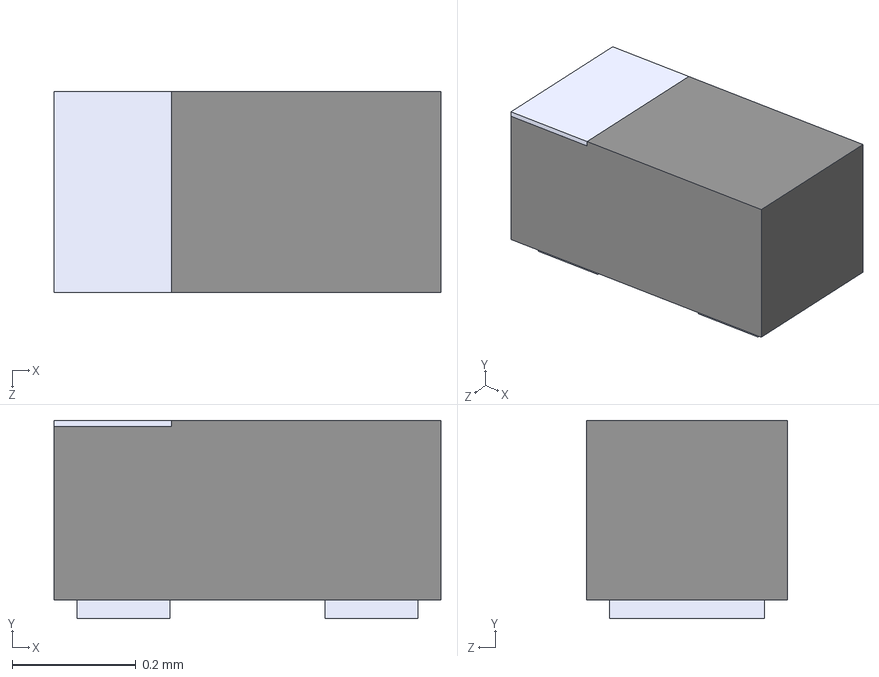
[picture p22: CAD file, 2026-04-19]
DataSheets/KicadElements/LIB_PESD5V0C1BSFYL/PESD5V0C1BSFYL/3D/PESD5V0C1BSFYL.stp
0.625 x 0.32 x 0.325 mm
