Szymek200/Smart-ball/DataSheets/KicadElements/LIB_SS14MDP2/SS14MDP2/3D/SS14MDP2.stp

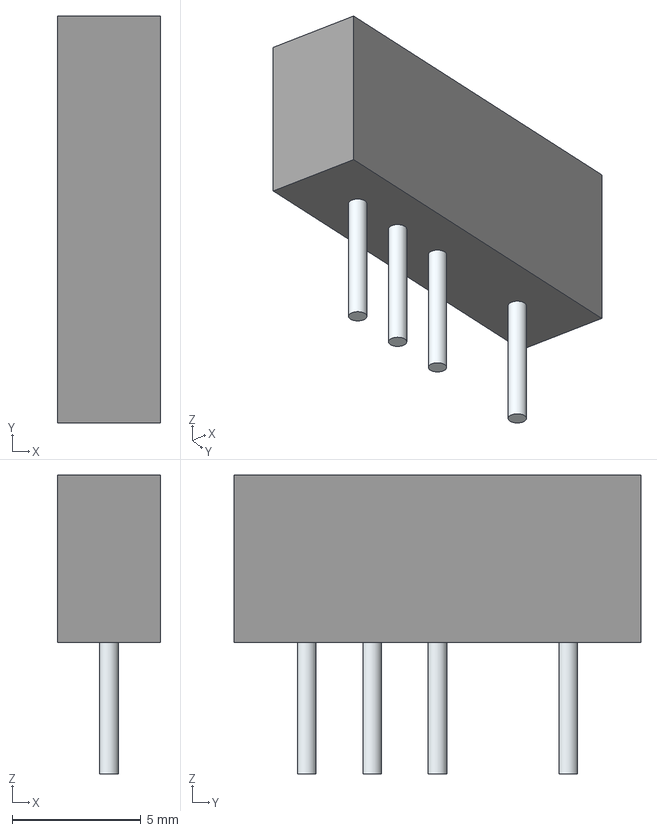
[picture p23: CAD file, 2026-04-16]
DataSheets/KicadElements/LIB_SS14MDP2/SS14MDP2/3D/SS14MDP2.stp
4.00 x 15.8 x 11.6 mm
Leads x 4
