Szymek200/Smart-ball/DataSheets/KicadElements/SIM8055-6-1-14-00-A/SIM8055-6-1-14-00-A.step

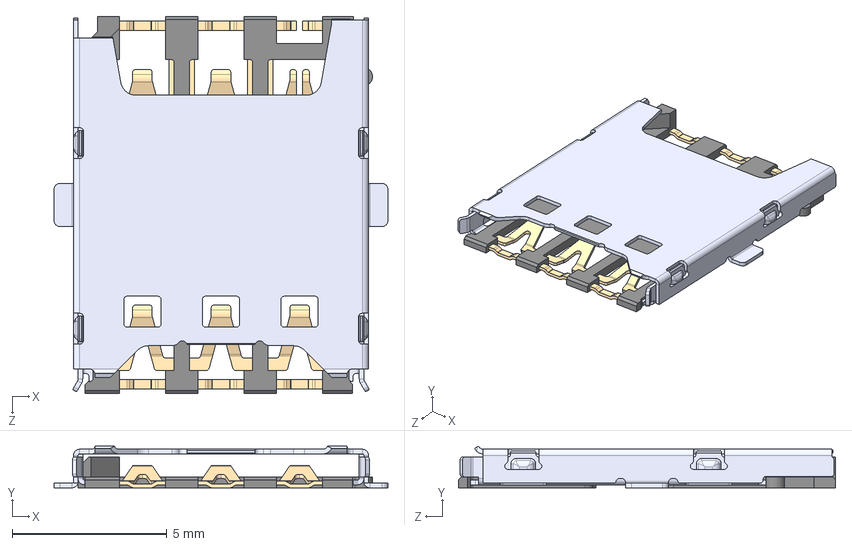
[picture p24: CAD file, 2026-04-05]
DataSheets/KicadElements/SIM8055-6-1-14-00-A/SIM8055-6-1-14-00-A.step
10.8 x 1.35 x 12.2 mm
