Szymek200/Smart-ball/DataSheets/KicadElements/USBLC6-2SC6Y/USBLC6-2SC6Y.step

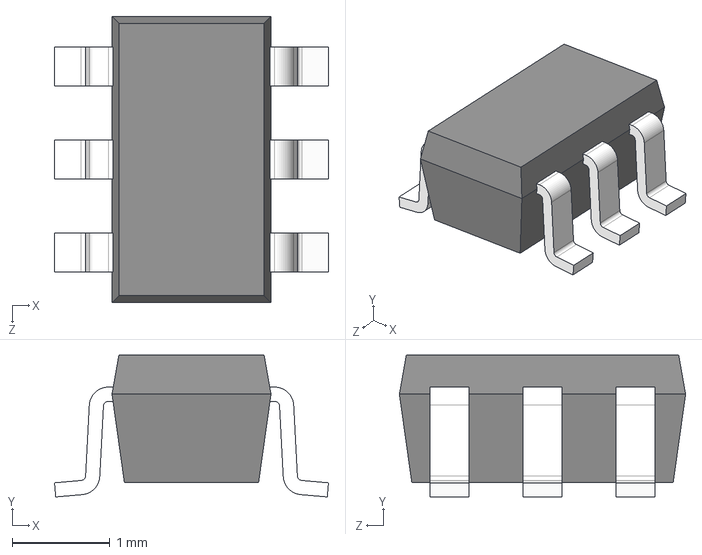
[picture p25: CAD file, 2026-04-05]
DataSheets/KicadElements/USBLC6-2SC6Y/USBLC6-2SC6Y.step
2.80 x 1.45 x 2.92 mm
