Szymek200/Smart-ball/DataSheets/LIB_NEO-F10N-00B/NEO-F10N-00B/3D/NEO-F10N-00B.stp

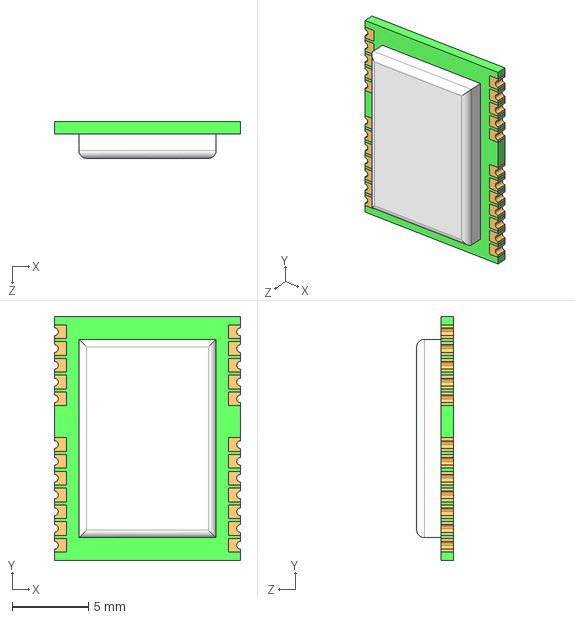
[picture p26: CAD file, 2026-04-05]
DataSheets/LIB_NEO-F10N-00B/NEO-F10N-00B/3D/NEO-F10N-00B.stp
12.2 x 16.0 x 2.40 mm
