Szymek200/Smart-ball/Housing/PokrywkaASCII.stl

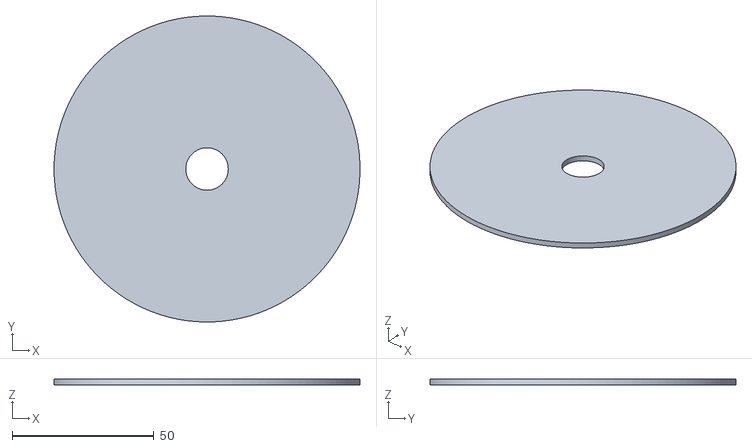
[picture p27: CAD file, 2026-08-22]
Housing/PokrywkaASCII.stl
108.0 x 108.0 x 2.00
