Szymek200/Smart-ball/Housing/BoxGoraBin.stl

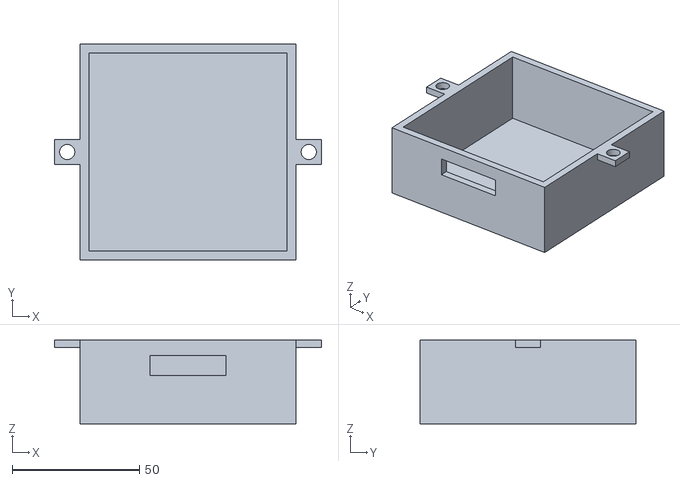
[picture p28: CAD file, 2026-08-22]
Housing/BoxGoraBin.stl
105.0 x 85.0 x 33.0
