Szymek200/Smart-ball/Housing/PodstawaASCII.stl

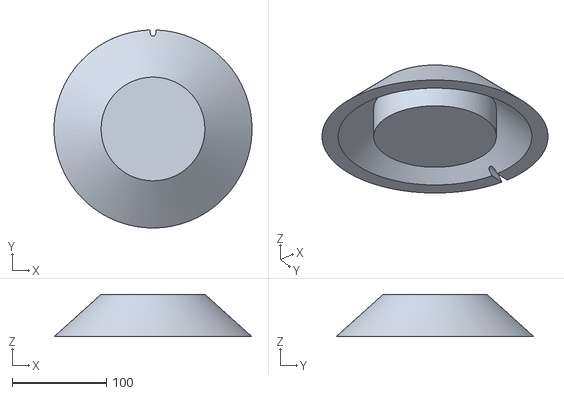
[picture p29: CAD file, 2026-08-22]
Housing/PodstawaASCII.stl
210.0 x 210.0 x 45.0
