Szymek200/Smart-ball/Housing/BoxDolASCII.stl

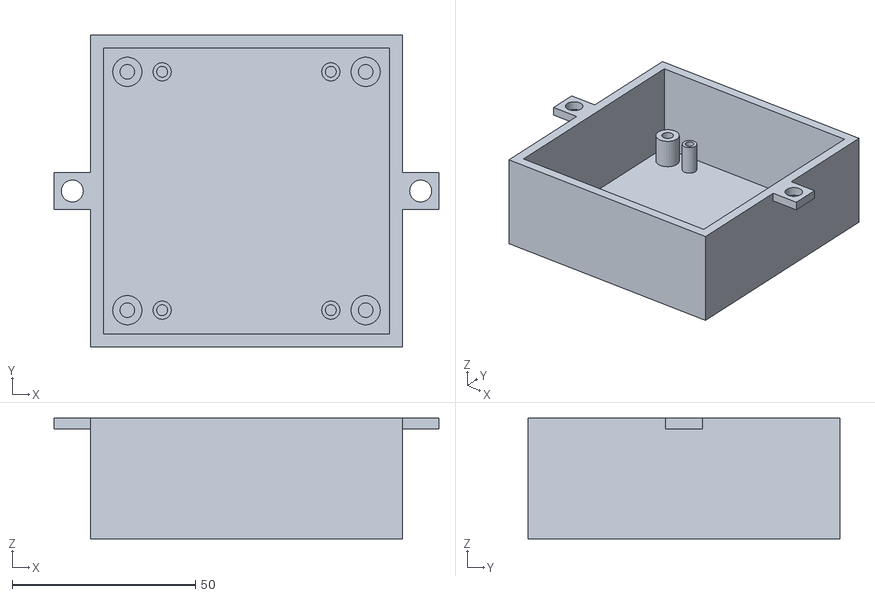
[picture p30: CAD file, 2026-08-22]
Housing/BoxDolASCII.stl
105.0 x 85.0 x 33.0
