Szymek200/Smart-ball/Housing/SferaBin.stl

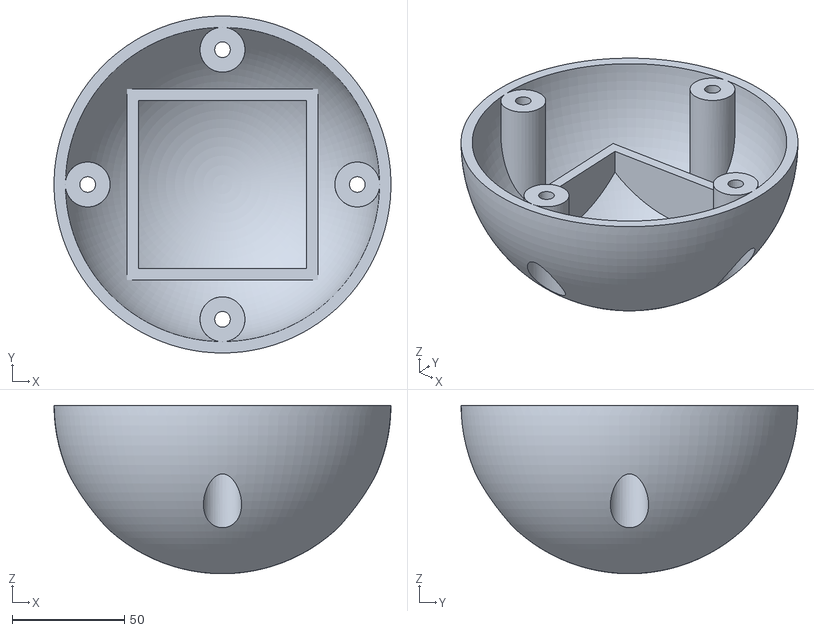
[picture p31: CAD file, 2026-08-22]
Housing/SferaBin.stl
149.9 x 150.0 x 75.0
