Szymek200/Smart-ball/(list of files, cad)

Other CAD files:
Housing/BoxGoraASCII.stl
Housing/PodstawaBin.stl
Housing/SferaASCII.stl
Housing/BoxDolBin.stl
Housing/PokrywkaBin.stl
DataSheets/KicadElements/LIB_1825910-6/1825910-6/3D/1825910-6.stp
DataSheets/KicadElements/LIB_MIC29302WU/MIC29302WU/3D/MIC29302WU.stp
DataSheets/KicadElements/LIB_TPS6213013AQRGTTQ1/TPS6213013AQRGTTQ1/3D/TPS6213013AQRGTTQ1.stp
DataSheets/LDO33/LIB_MIC29302WU/MIC29302WU/3D/MIC29302WU.stp
DataSheets/LDO33/LIB_TPS6213013AQRGTTQ1/TPS6213013AQRGTTQ1/3D/TPS6213013AQRGTTQ1.stp
DataSheets/tranzystory/LIB_1825910-6/1825910-6/3D/1825910-6.stp
