Szymek200/Smart-ball/PCB/MCU_board/MCU_schematic_pdf.pdf

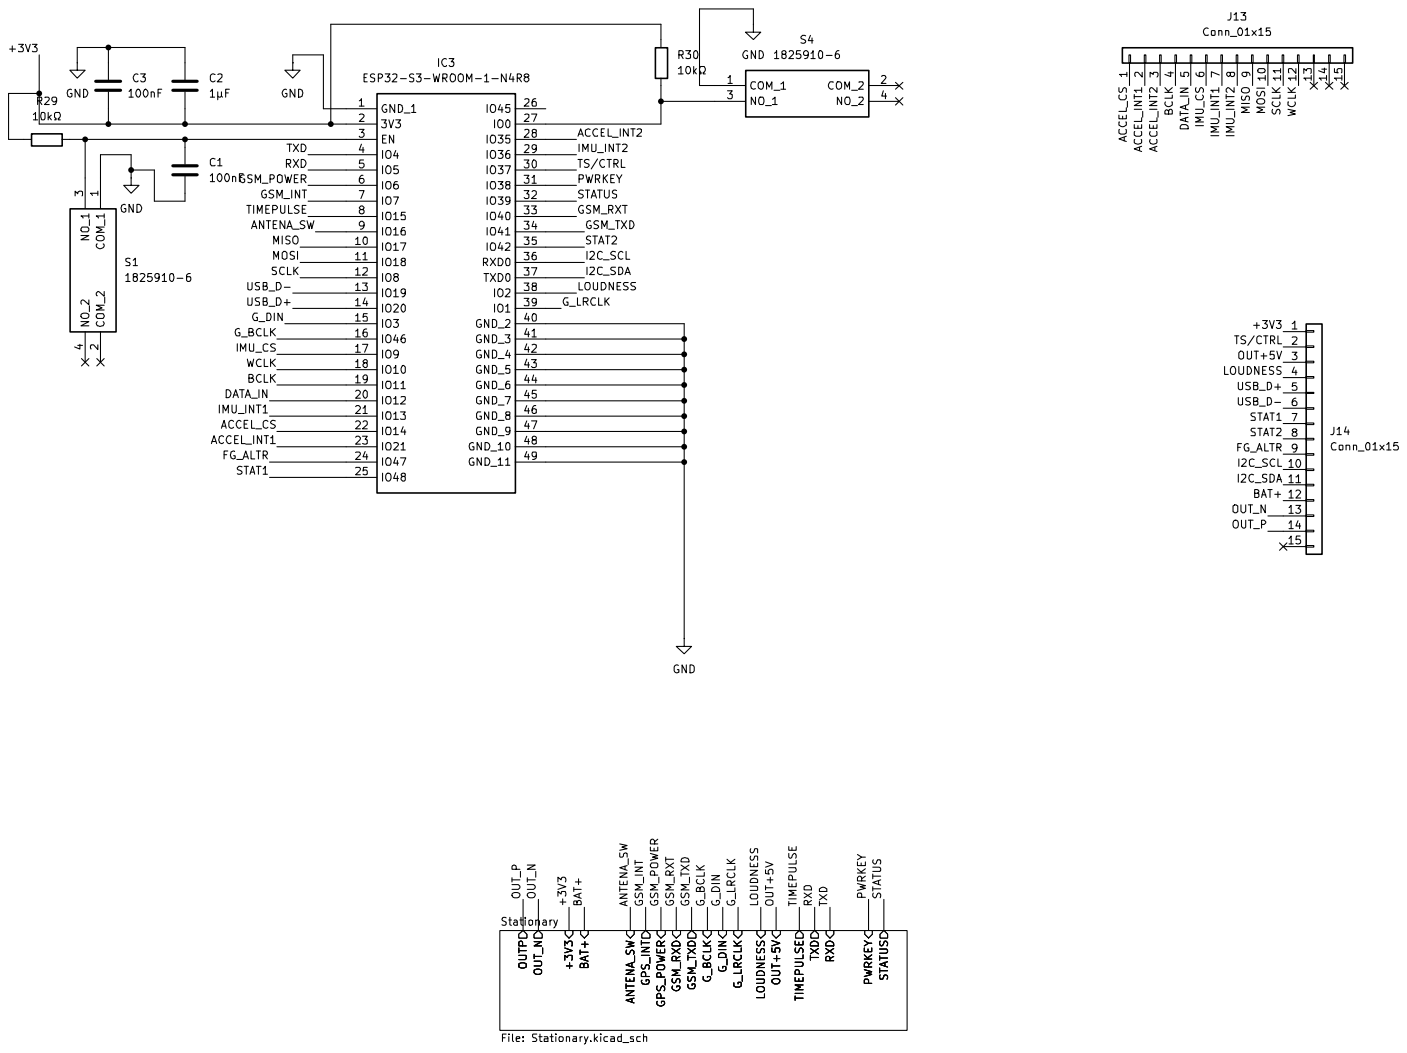
[picture p32: page 1]

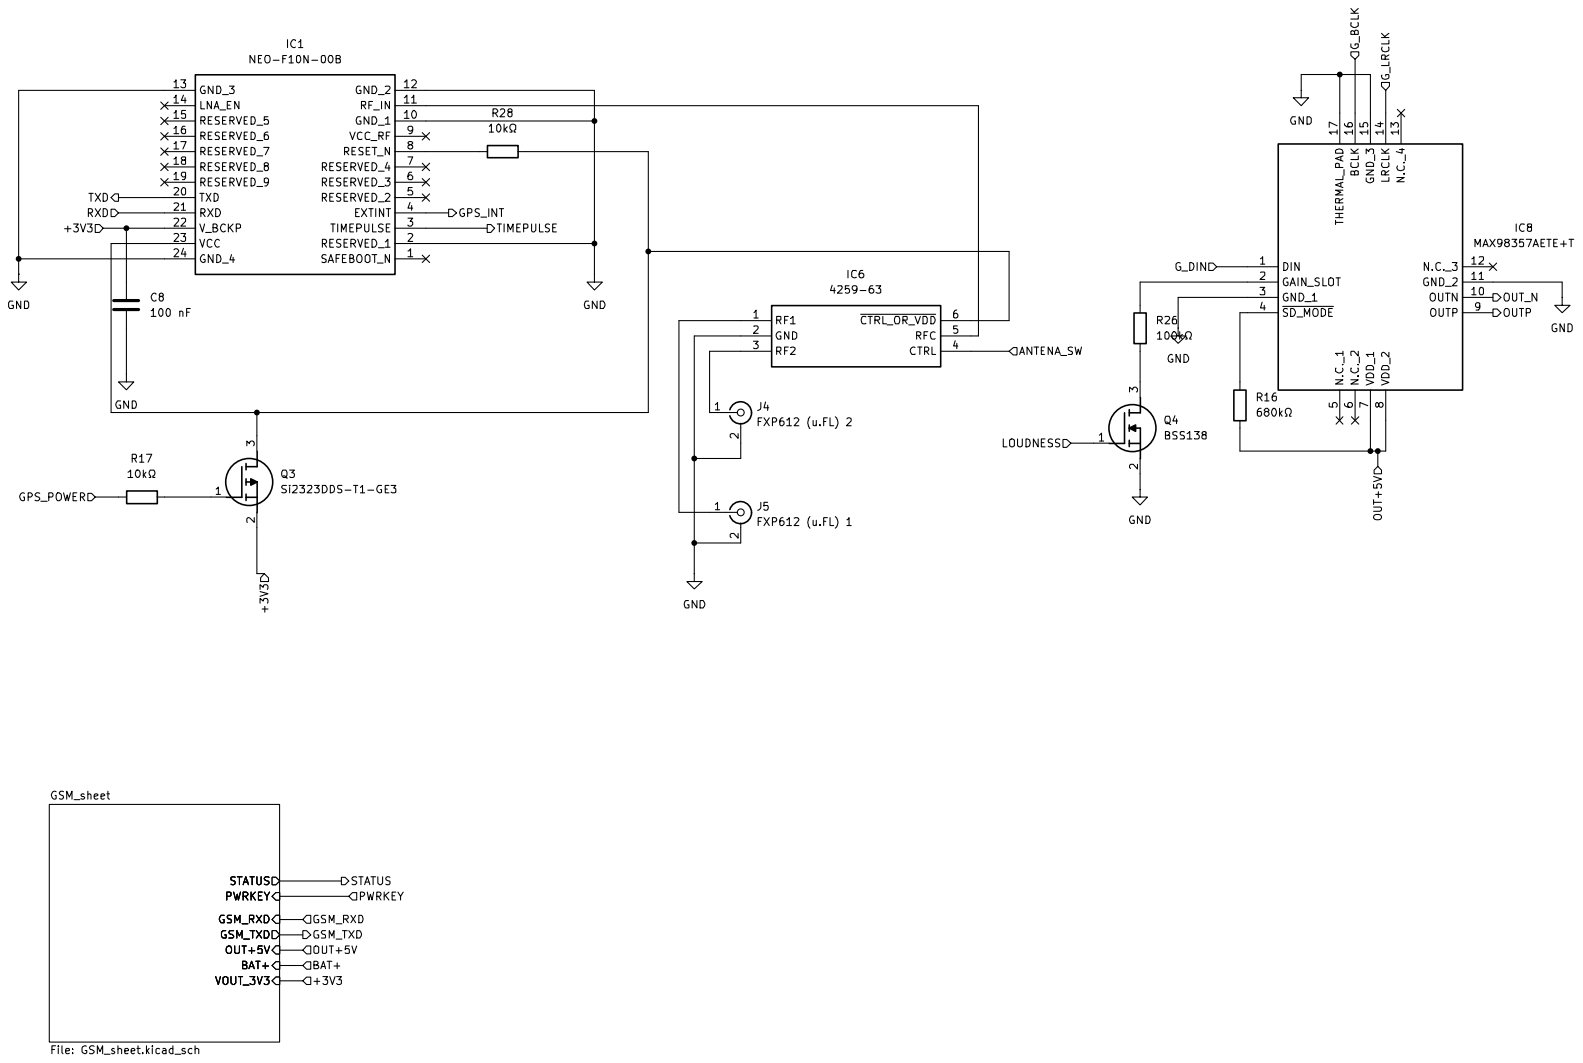
[picture p33: page 2]

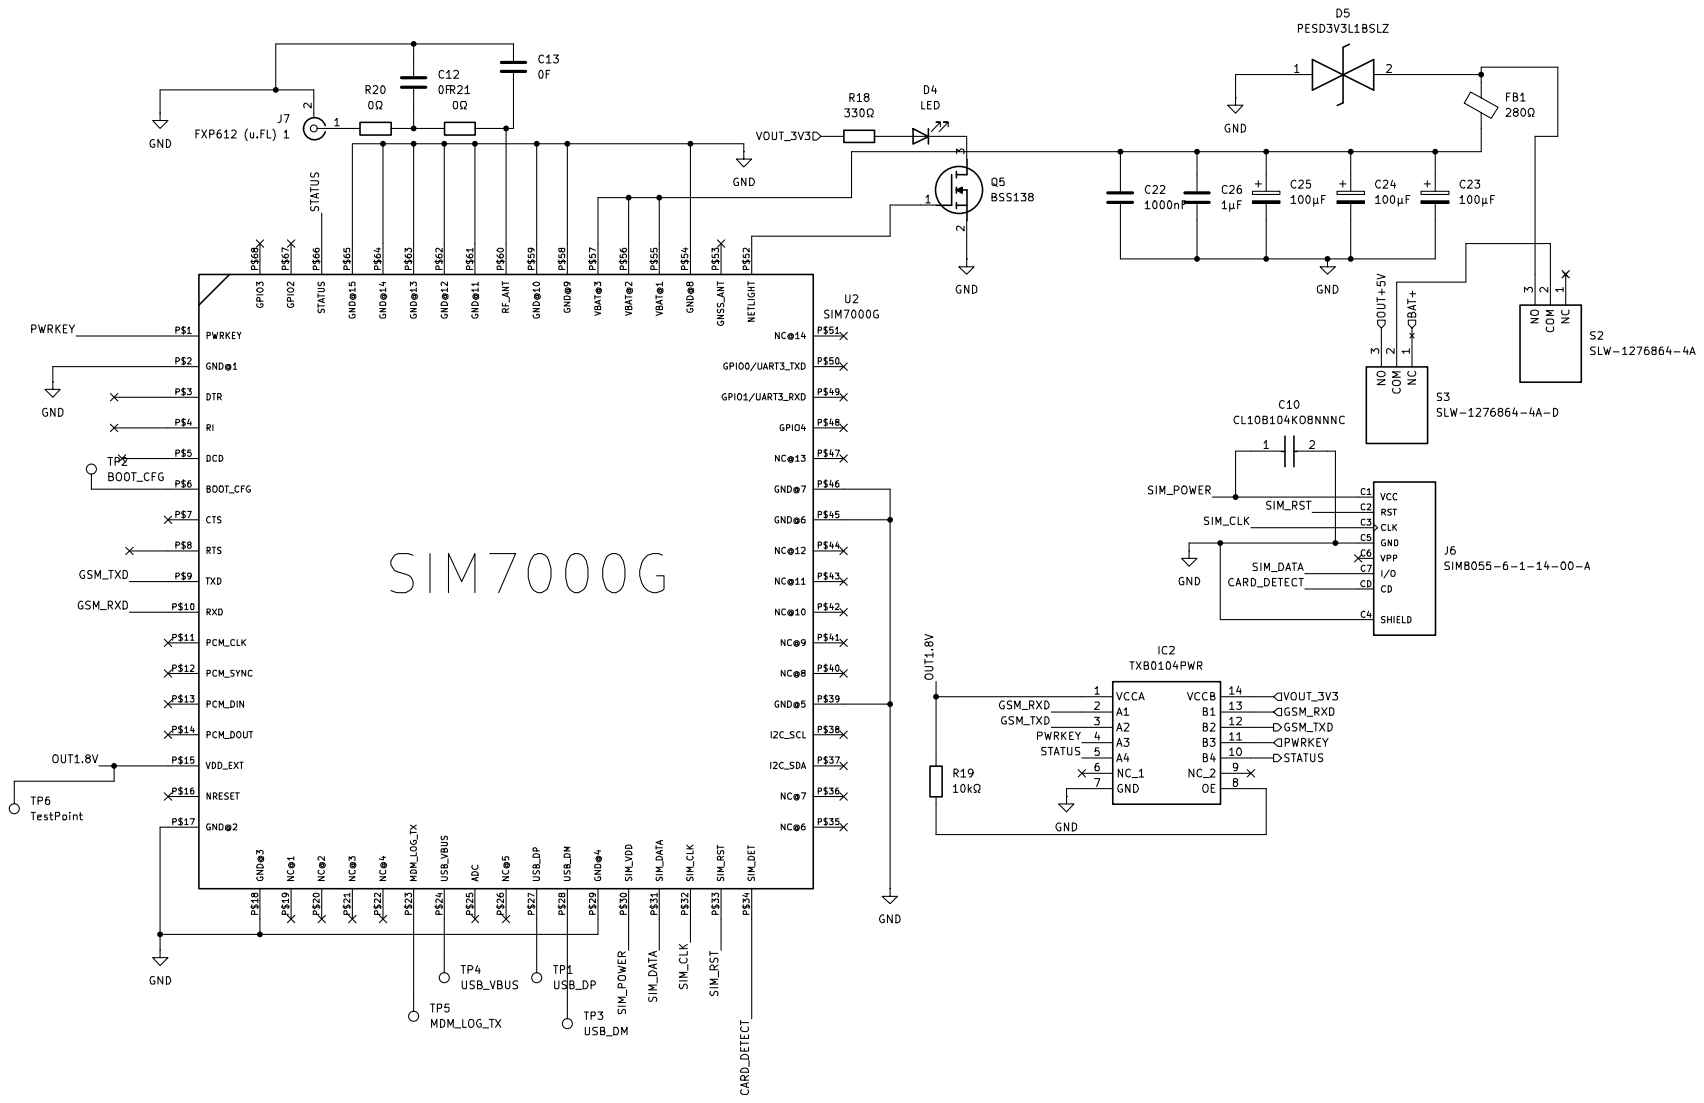
[picture p34: page 3]
