Szymek200/Smart-ball/PCB/MCU_board/smd_samemmu wzmacniacz.pdf

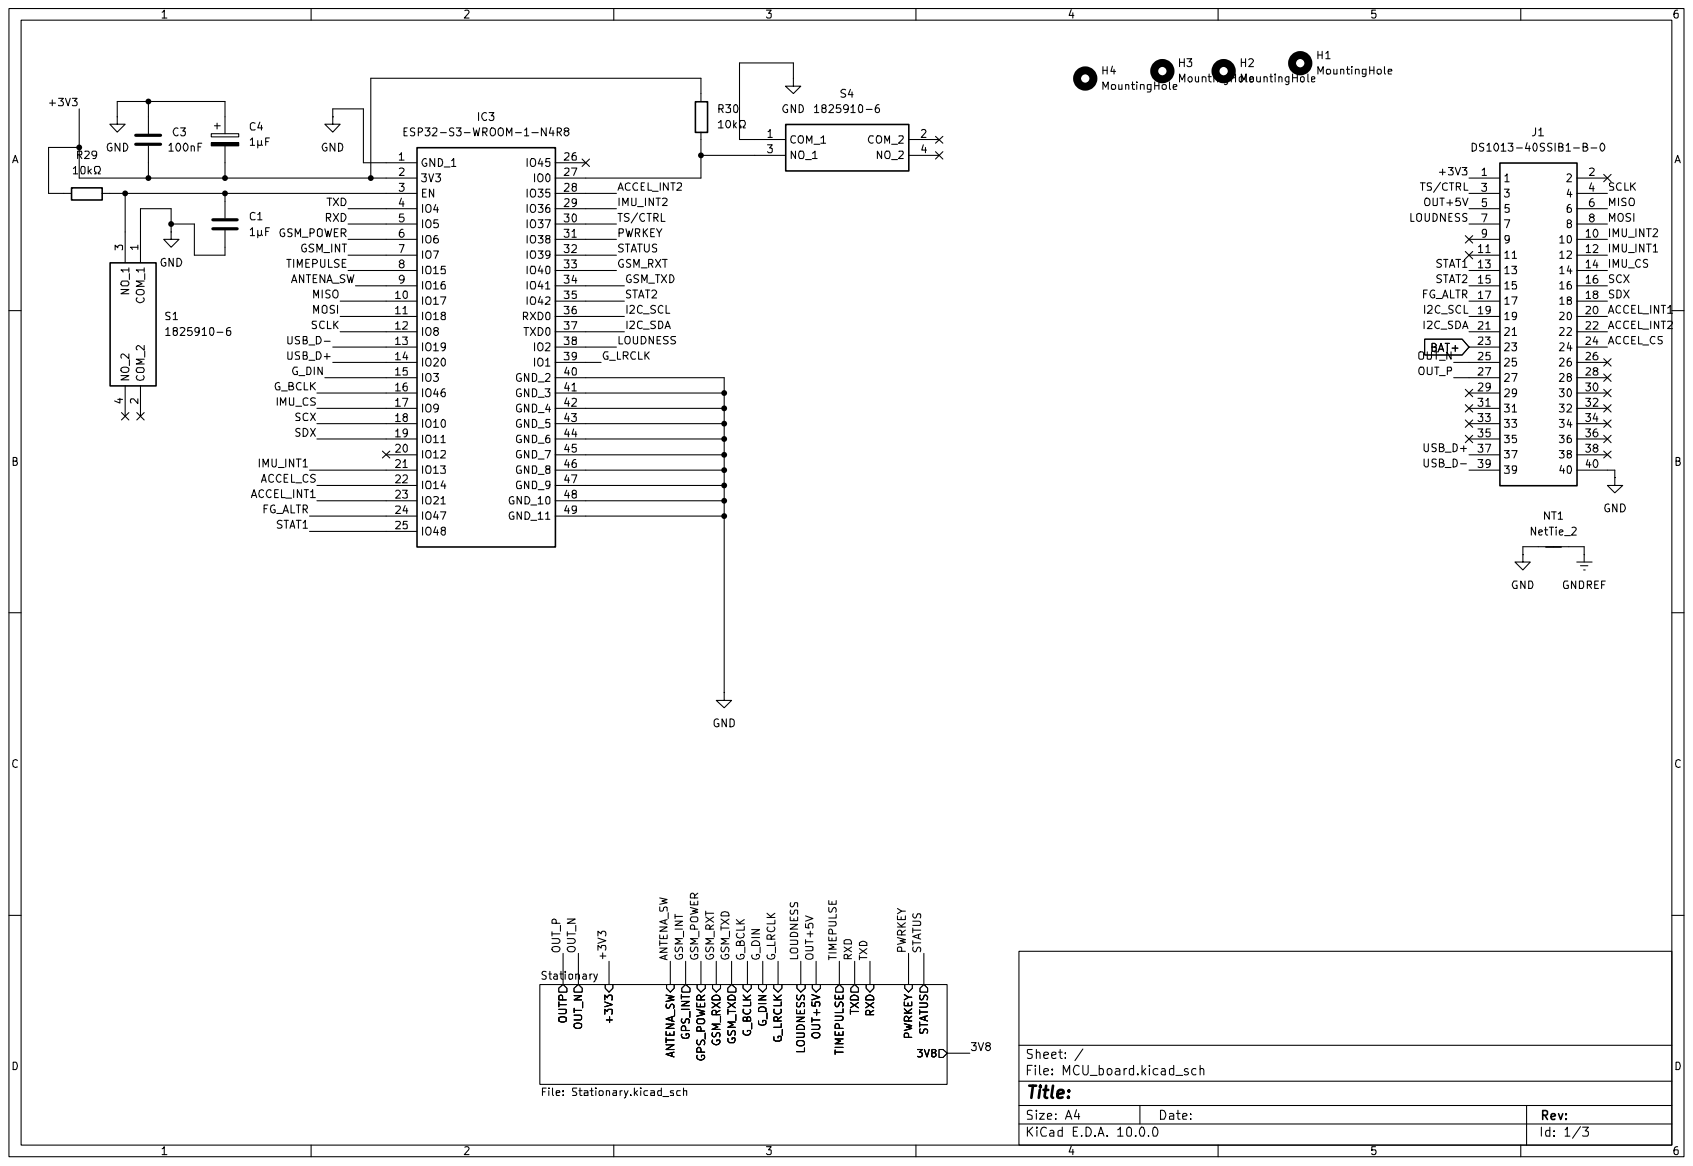
[picture p35: page 1]

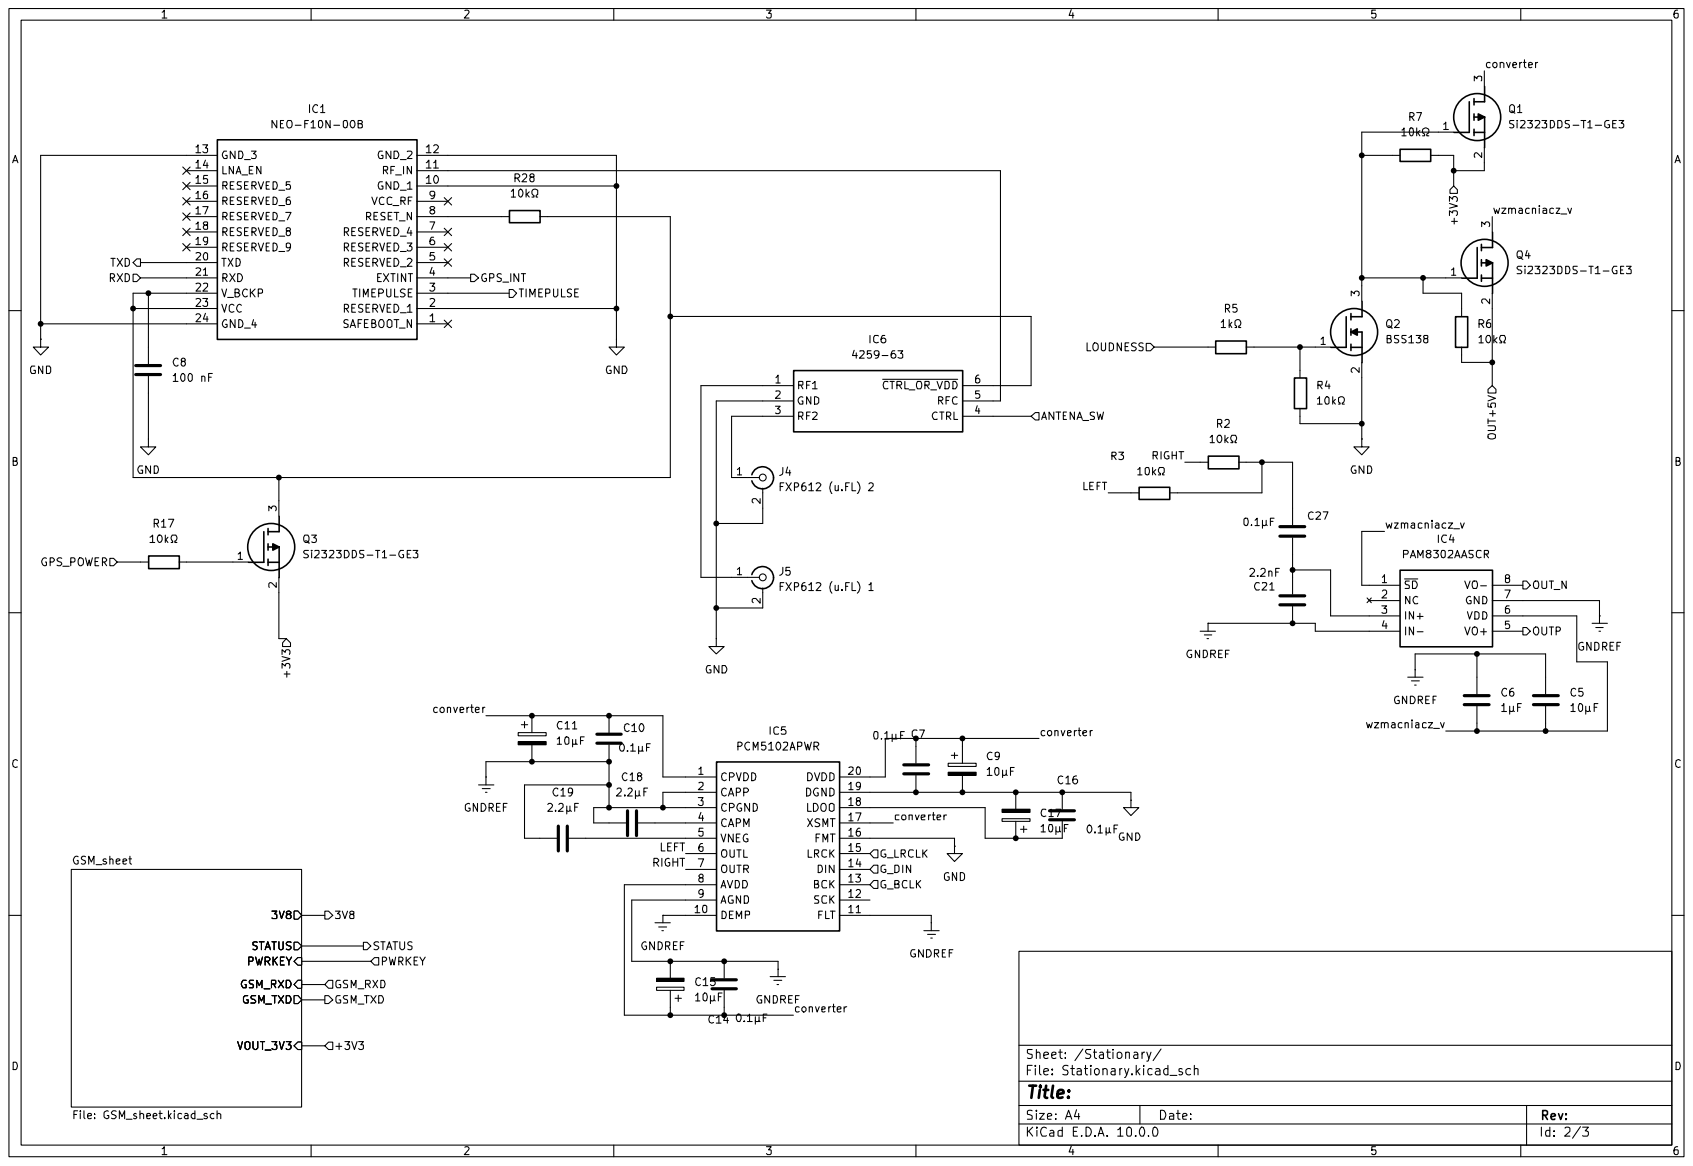
[picture p36: page 2]

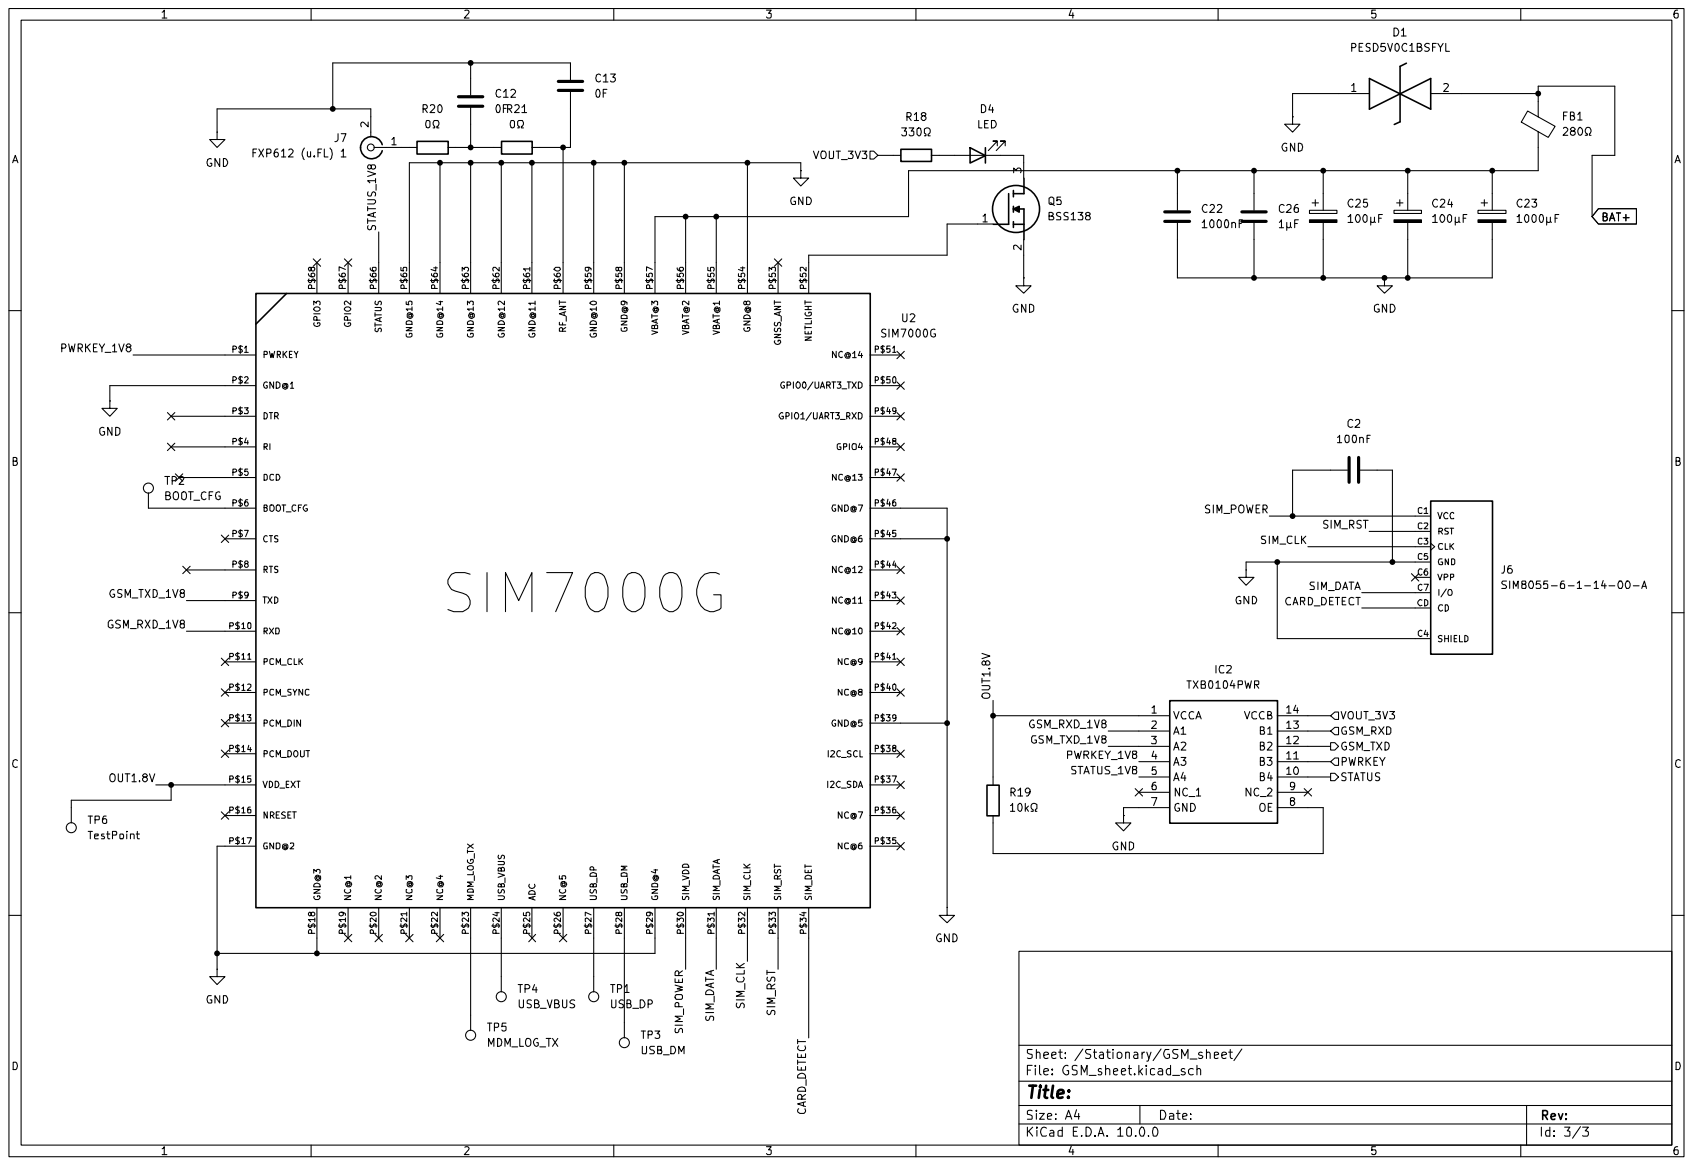
[picture p37: page 3]
