Szymek200/Smart-ball/PCB/power_board/power_board-2026-05-07_124658/power_board.kicad_pcb

## KiCad design PCB/power_board/power_board-2026-05-07_124658/power_board.kicad_pcb (2026-05-24)

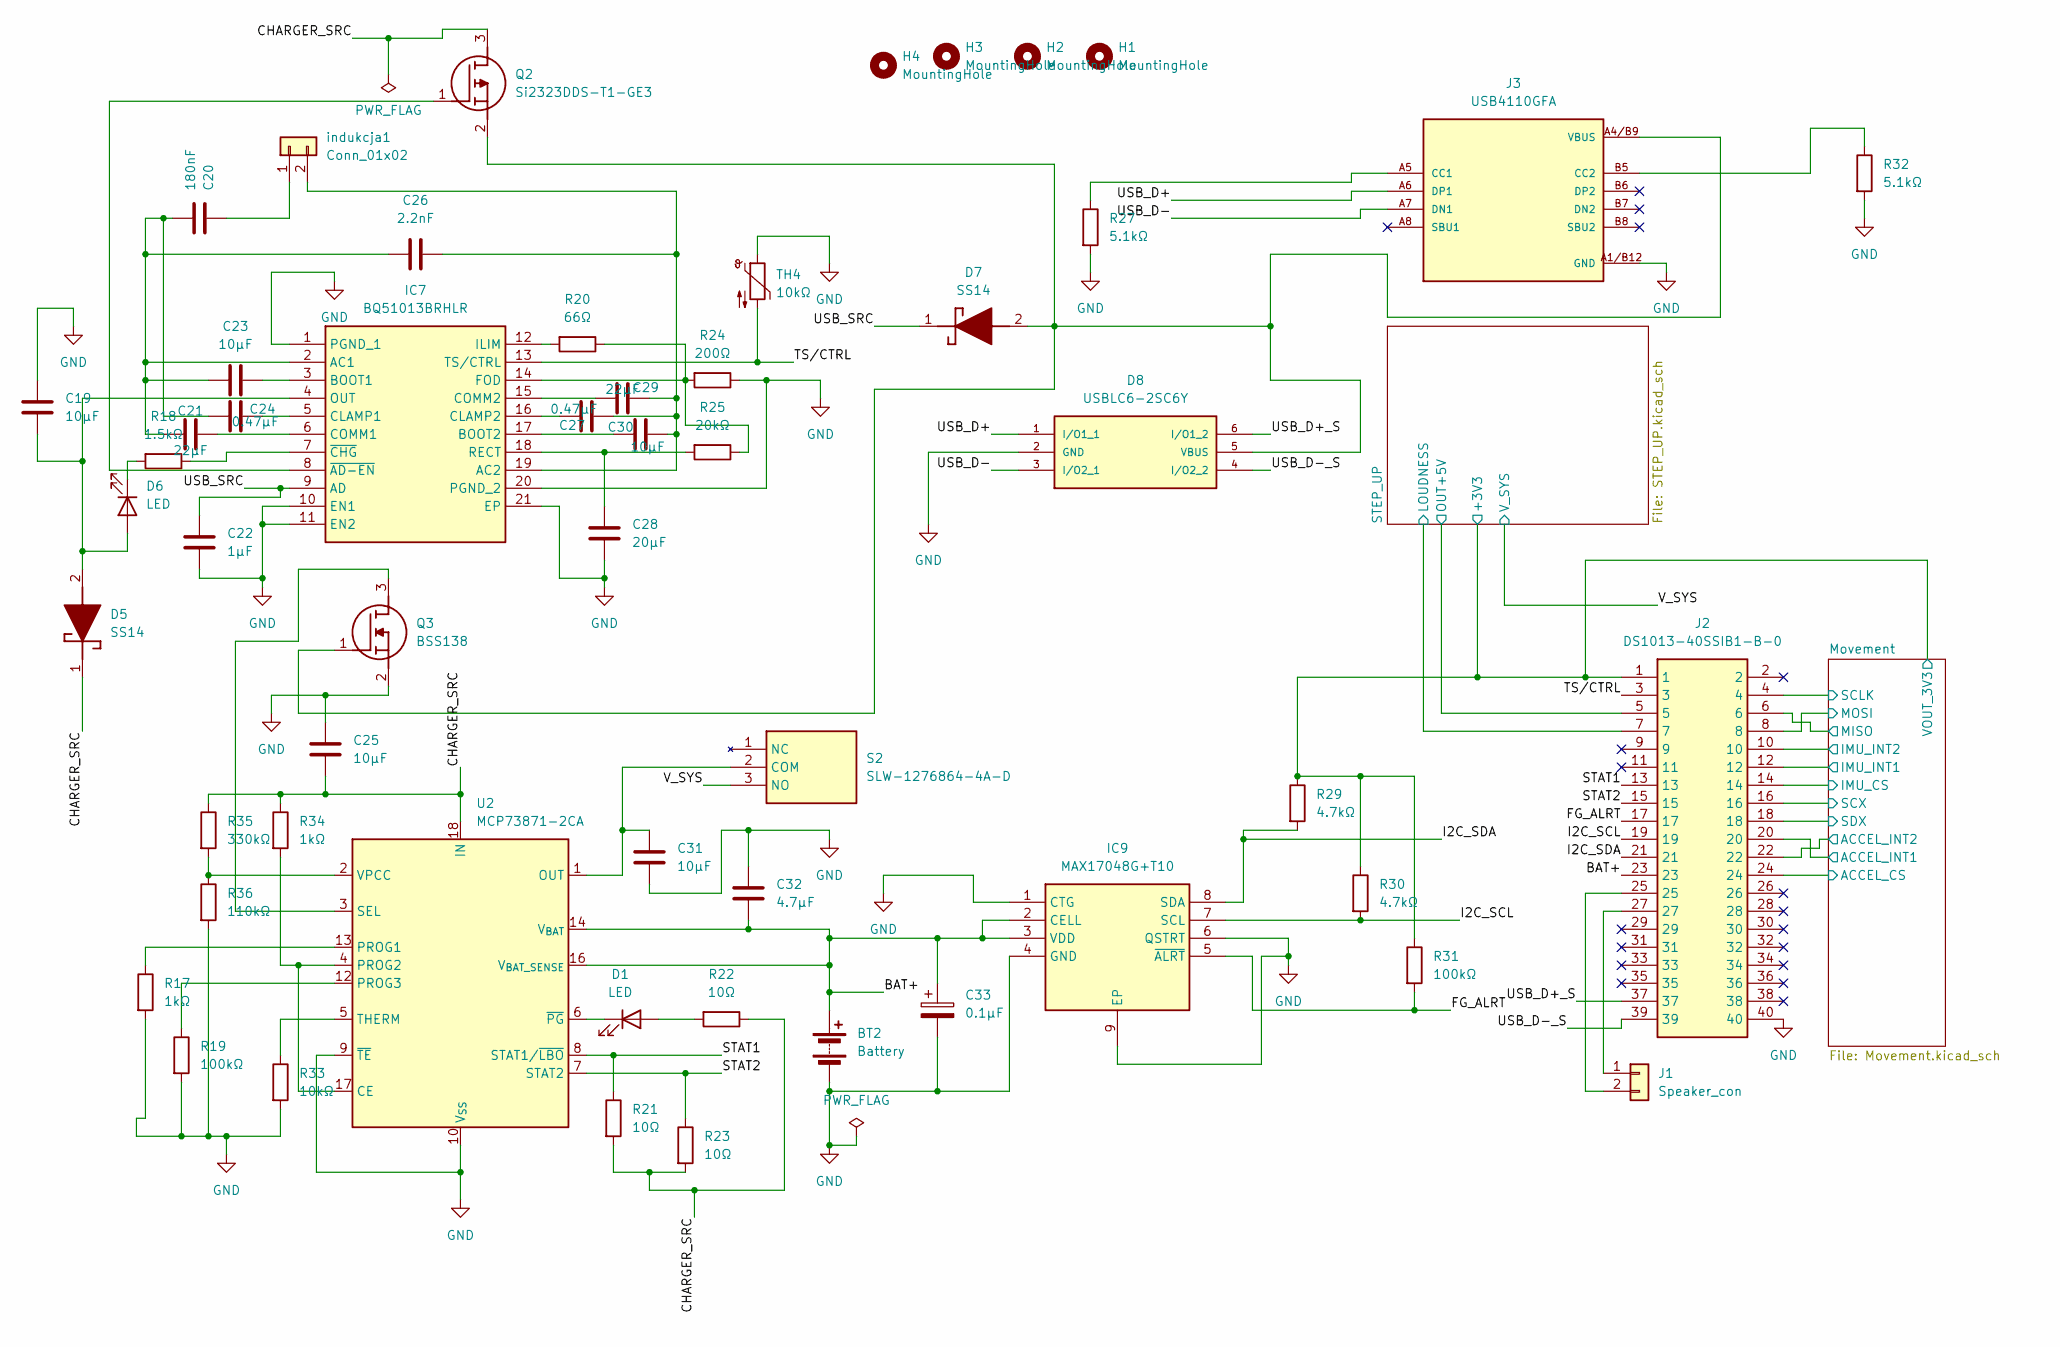
[picture p38: schematic power_board.kicad_sch]

Parts:
BT2: Battery; SolderWire-0.75sqmm_1x02_P4.8mm_D1.25mm_OD2.3mm
C19, C23, C25, C30, C31: 10µF; CP_EIA-3216-18_Kemet-A
C20: 180nF; CP_EIA-3216-18_Kemet-A
C21, C29: 22µF; CP_EIA-3216-18_Kemet-A
C22: 1µF; CP_EIA-3216-18_Kemet-A
C24, C27: 0.47µF; CP_EIA-3216-18_Kemet-A
C26: 2.2nF; CP_EIA-3216-18_Kemet-A
C28: 20µF; CP_EIA-3216-18_Kemet-A
C32: 4.7µF; CP_EIA-3216-18_Kemet-A
C33: 0.1µF; CP_EIA-3216-18_Kemet-A
D1, D6: LED; LED_0603_1608Metric
D5, D7: SS14; DIOM5227X270N; Mouser Part Number 512-SS14
D8: USBLC6-2SC6Y; SOT95P280X145-6N; MOUSER_PART_NUMBER 511-USBLC6-2SC6Y
H1, H2, H3, H4: MountingHole; MountingHole_3.2mm_M3_Pad_Via
IC7: BQ51013BRHLR; BQ51050BRHLR; Mouser Part Number 595-BQ51013BRHLR
IC9: MAX17048G+T10; SON50P200X200X80-9N-D; Mouser Part Number 700-MAX17048G+T10
J1: Speaker_con; PinHeader_1x02_P2.54mm_Vertical
J2: DS1013-40SSIB1-B-0; DS101340SSIB1B0; Manufacturer_Part_Number DS1013-40SSIB1-B-0
J3: USB4110GFA; GCT_USB4110GFA
Q2: Si2323DDS-T1-GE3; SOT95P237X112-3N; Mouser Part Number 78-SI2323DDS-T1-GE3
Q3: BSS138; SOT95P240X120-3N; Mouser Part Number 512-BSS138
R17, R34: 1kΩ; R_0603_1608Metric
R18: 1.5kΩ; R_0603_1608Metric
R19, R31: 100kΩ; R_0603_1608Metric
R20: 66Ω; R_0603_1608Metric
R21, R22, R23: 10Ω; R_0603_1608Metric
R24: 200Ω; R_0603_1608Metric
R25: 20kΩ; R_0603_1608Metric
R27, R32: 5.1kΩ; R_0603_1608Metric
R29, R30: 4.7kΩ; R_0603_1608Metric
R33: 10kΩ; R_0603_1608Metric
R35: 330kΩ; R_0603_1608Metric
R36: 110kΩ; R_0603_1608Metric
S2: SLW-1276864-4A-D; SLW12768644AD; Mouser Part Number 179-SLW-1276864-4A-D
TH4: 10kΩ; R_0603_1608Metric
U2: MCP73871-2CA; QFN-20-1EP_4x4mm_P0.5mm_EP2.5x2.5mm
indukcja1: Conn_01x02; PinHeader_1x02_P2.54mm_Vertical

Connections:
/BAT+: BT2.1 (+), C32.2, C33.1, IC9.2 (CELL), IC9.3 (VDD), J2.23, U2.14 (V_{BAT}), U2.15 (V_{BAT}), U2.16 (V_{BAT_SENSE})
/CHARGER_SRC: C25.2, D5.1 (K), Q2.3 (D), R21.2, R22.1, R23.2, R34.1, R35.1, U2.18 (IN), U2.19 (IN)
/FG_ALRT: IC9.5 (~ALRT), J2.17, R31.2
/I2C_SCL: IC9.7 (SCL), J2.19, R30.2
/I2C_SDA: IC9.8 (SDA), J2.21, R29.2
/Movement/ACCEL_CS: J2.24; also elsewhere on the board
/Movement/ACCEL_INT1: J2.20; also elsewhere on the board
/Movement/ACCEL_INT2: J2.22; also elsewhere on the board
/Movement/IMU_CS: J2.14; also elsewhere on the board
/Movement/IMU_INT1: J2.12; also elsewhere on the board
/Movement/IMU_INT2: J2.10; also elsewhere on the board
/Movement/MISO: J2.6; also elsewhere on the board
/Movement/MOSI: J2.8; also elsewhere on the board
/Movement/SCLK: J2.4; also elsewhere on the board
/Movement/SCX: J2.16; also elsewhere on the board
/Movement/SDX: J2.18; also elsewhere on the board
/Movement/VOUT_3V3: J2.1, R29.1, R30.1, R31.1; also elsewhere on the board
/STAT1: J2.13, R21.1, U2.8 (STAT1/~LBO)
/STAT2: J2.15, R23.1, U2.7 (STAT2)
/STEP_UP/LOUDNESS: J2.7; also elsewhere on the board
/STEP_UP/OUT+5V: J2.5; also elsewhere on the board
/TS/CTRL: IC7.13 (TS/CTRL), J2.3, TH4.2
/USB_D+: D8.1 (I/O1_1), J3.A6 (DP1)
/USB_D+_S: D8.6 (I/O1_2), J2.37
/USB_D-: D8.3 (I/O2_1), J3.A7 (DN1)
/USB_D-_S: D8.4 (I/O2_2), J2.39
/USB_SRC: C22.1, D7.1 (K), IC7.9 (AD)
/V_SYS: S2.3 (NO); also elsewhere on the board
GND: BT2.2 (-), C19.2, C22.2, C25.1, C28.2, C31.2, C32.1, C33.2, D8.2 (GND), IC7.1 (PGND_1), IC7.10 (EN1), IC7.11 (EN2), IC7.20 (PGND_2), IC7.21 (EP), IC9.1 (CTG), IC9.4 (GND), IC9.6 (QSTRT), IC9.9 (EP), J2.40, J3.A1/B12 (GND), J3.B1/A12 (GND), J3.S1 (GND), J3.S2 (GND), J3.S3 (GND), J3.S4 (GND), Q3.2 (S), R17.2, R19.2, R24.1, R27.2, R32.2, R33.2, R36.2, TH4.1, U2.9 (~TE), U2.10 (V_{SS}), U2.11 (V_{SS}), U2.21 (V_{SS}); also elsewhere on the board
unnamed: D1.2 (A), R22.2
unnamed: D1.1 (K), U2.6 (~PG)
unnamed: C19.1, D5.2 (A), D6.2 (A), IC7.4 (OUT)
unnamed: D6.1 (K), R18.2
unnamed: C20.2, C21.2, C23.2, C24.2, C26.2, IC7.2 (AC1)
unnamed: C26.1, C27.1, C29.1, C30.1, IC7.19 (AC2), indukcja1.2
unnamed: C23.1, IC7.3 (BOOT1)
unnamed: C30.2, IC7.17 (BOOT2)
unnamed: C24.1, IC7.5 (CLAMP1)
unnamed: C27.2, IC7.16 (CLAMP2)
unnamed: C21.1, IC7.6 (COMM1)
unnamed: C29.2, IC7.15 (COMM2)
unnamed: IC7.14 (FOD), R20.1, R24.2, R25.1
unnamed: IC7.12 (ILIM), R20.2
unnamed: C28.1, IC7.18 (RECT), R25.2
unnamed: IC7.8 (~AD-EN), Q2.1 (G)
unnamed: IC7.7 (~CHG), R18.1
unnamed: J1.1, J2.27
unnamed: J1.2, J2.25
unnamed: J3.A5 (CC1), R27.1
unnamed: J3.B5 (CC2), R32.1
unnamed: Q3.3 (D), U2.3 (SEL)
unnamed: C31.1, S2.2 (COM), U2.1 (OUT), U2.20 (OUT)
unnamed: R34.2, U2.4 (PROG2), U2.17 (CE)
unnamed: R17.1, U2.13 (PROG1)
unnamed: R19.1, U2.12 (PROG3)
unnamed: R33.1, U2.5 (THERM)
unnamed: R35.2, R36.1, U2.2 (VPCC)
unnamed: C20.1, indukcja1.1
VBUS: D7.2 (A), D8.5 (VBUS), J3.A4/B9 (VBUS), J3.B4/A9 (VBUS), Q2.2 (S), Q3.1 (G)

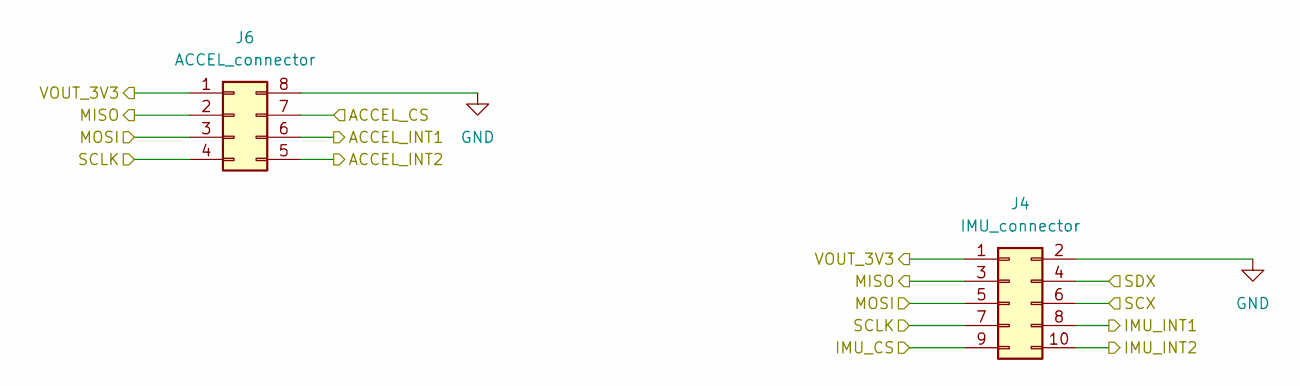
[picture p39: schematic Movement.kicad_sch]

Parts:
J4: IMU_connector; PinHeader_2x05_P2.54mm_Vertical
J6: ACCEL_connector; PinHeader_2x04_P2.54mm_Vertical

Connections:
/Movement/ACCEL_CS: J6.7; also elsewhere on the board
/Movement/ACCEL_INT1: J6.6; also elsewhere on the board
/Movement/ACCEL_INT2: J6.5; also elsewhere on the board
/Movement/IMU_CS: J4.9; also elsewhere on the board
/Movement/IMU_INT1: J4.8; also elsewhere on the board
/Movement/IMU_INT2: J4.10; also elsewhere on the board
/Movement/MISO: J4.3, J6.2; also elsewhere on the board
/Movement/MOSI: J4.5, J6.3; also elsewhere on the board
/Movement/SCLK: J4.7, J6.4; also elsewhere on the board
/Movement/SCX: J4.6; also elsewhere on the board
/Movement/SDX: J4.4; also elsewhere on the board
/Movement/VOUT_3V3: J4.1, J6.1; also elsewhere on the board
GND: J4.2, J6.8; also elsewhere on the board

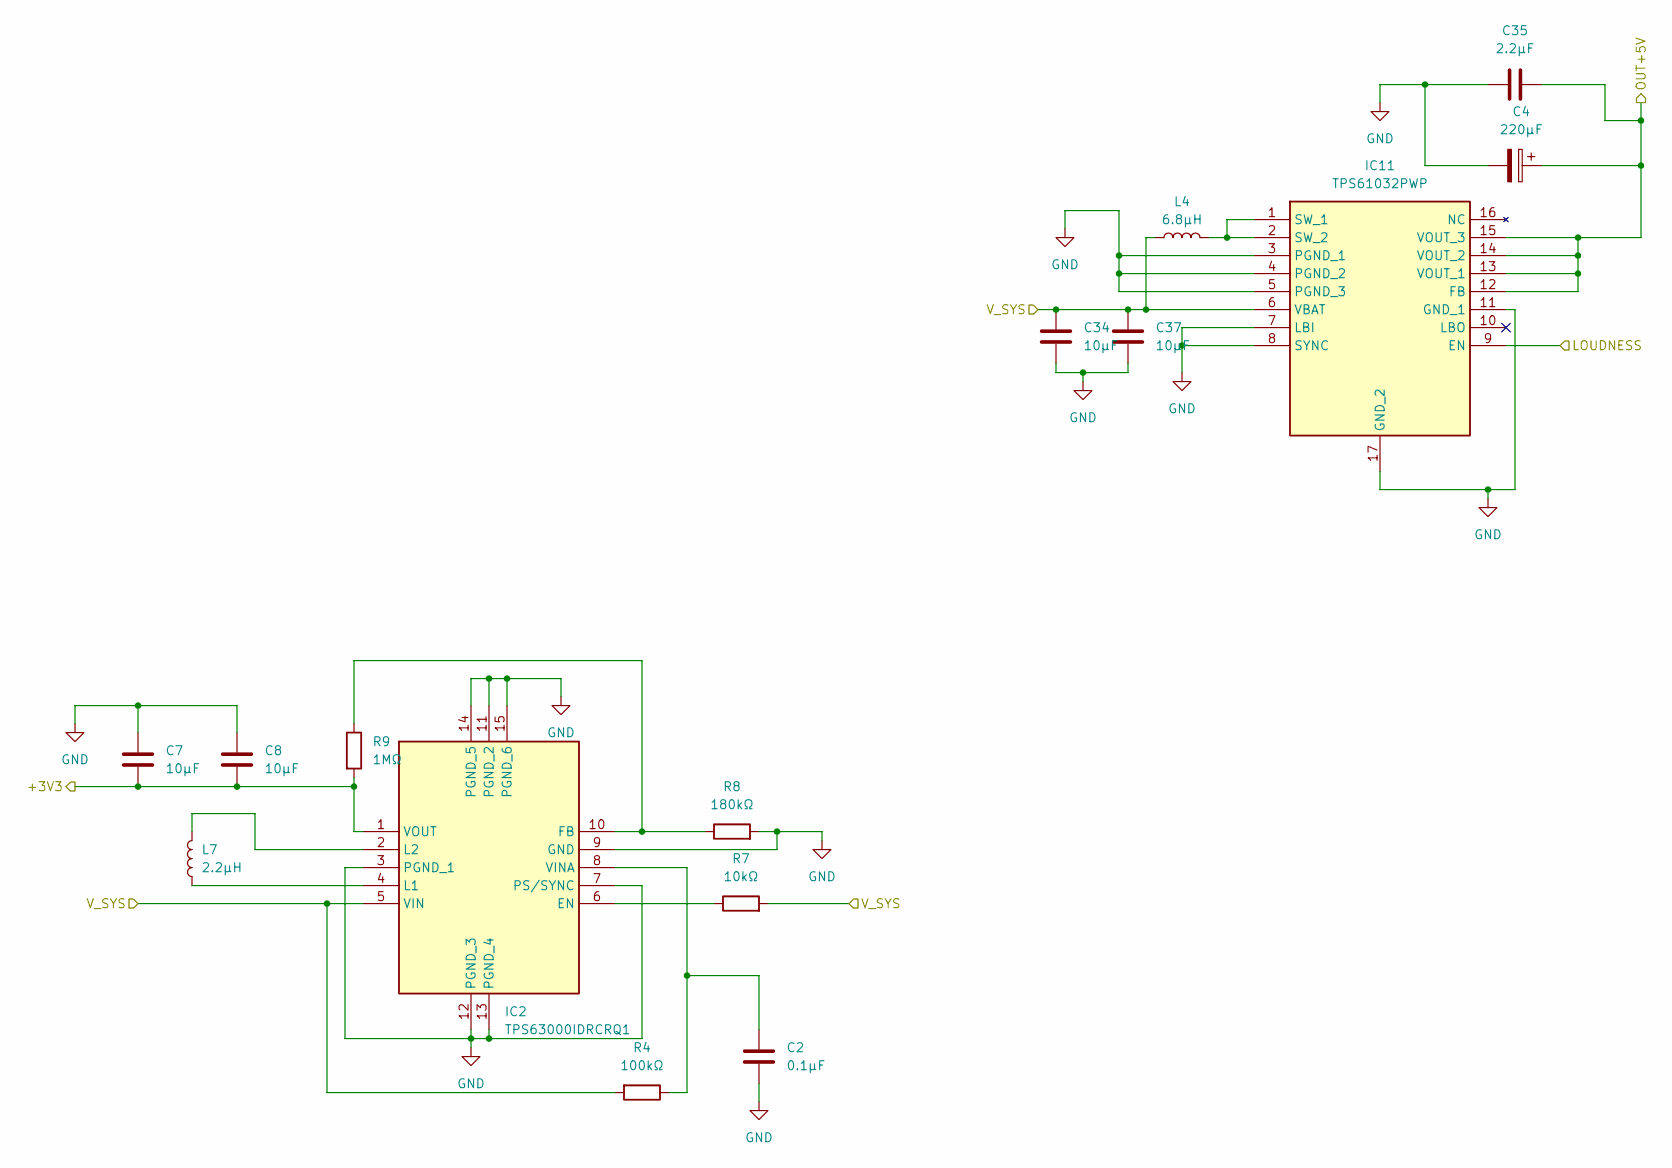
[picture p40: schematic STEP_UP.kicad_sch]

Parts:
C2: 0.1μF; CP_Elec_6.3x5.4
C4: 220µF; CP_Elec_6.3x5.4
C7, C8: 10μF; CP_Elec_6.3x5.4
C34, C37: 10µF; CP_Elec_6.3x5.4
C35: 2.2µF; CP_Elec_6.3x5.4
IC2: TPS63000IDRCRQ1; Mouser Part Number 595-TPS63000IDRCRQ1
IC11: TPS61032PWP; SOP65P640X120-17N; Mouser Part Number 595-TPS61032PWP
L4: 6.8µH; L_6.3x6.3_H3
L7: 2.2µH; L_6.3x6.3_H3
R4: 100kΩ; R_0603_1608Metric
R7: 10kΩ; R_0603_1608Metric
R8: 180kΩ; R_0603_1608Metric
R9: 1MΩ; R_0603_1608Metric

Connections:
/Movement/VOUT_3V3: C7.2, C8.2, IC2.1 (VOUT), R9.2; also elsewhere on the board
/STEP_UP/LOUDNESS: IC11.9 (EN); also elsewhere on the board
/STEP_UP/OUT+5V: C4.1, C35.2, IC11.12 (FB), IC11.13 (VOUT_1), IC11.14 (VOUT_2), IC11.15 (VOUT_3); also elsewhere on the board
/V_SYS: C34.1, C37.1, IC2.5 (VIN), IC11.6 (VBAT), L4.1, R4.2, R7.2; also elsewhere on the board
GND: C2.2, C4.2, C7.1, C8.1, C34.2, C35.1, C37.2, IC2.3 (PGND_1), IC2.7 (PS/SYNC), IC2.9 (GND), IC2.11 (PGND_2), IC2.12 (PGND_3), IC2.13 (PGND_4), IC2.14 (PGND_5), IC2.15 (PGND_6), IC11.3 (PGND_1), IC11.4 (PGND_2), IC11.5 (PGND_3), IC11.7 (LBI), IC11.8 (SYNC), IC11.11 (GND_1), IC11.17 (GND_2), R8.2; also elsewhere on the board
unnamed: IC2.6 (EN), R7.1
unnamed: IC2.10 (FB), R8.1, R9.1
unnamed: IC2.4 (L1), L7.1
unnamed: IC2.2 (L2), L7.2
unnamed: C2.1, IC2.8 (VINA), R4.1
unnamed: IC11.1 (SW_1), IC11.2 (SW_2), L4.2

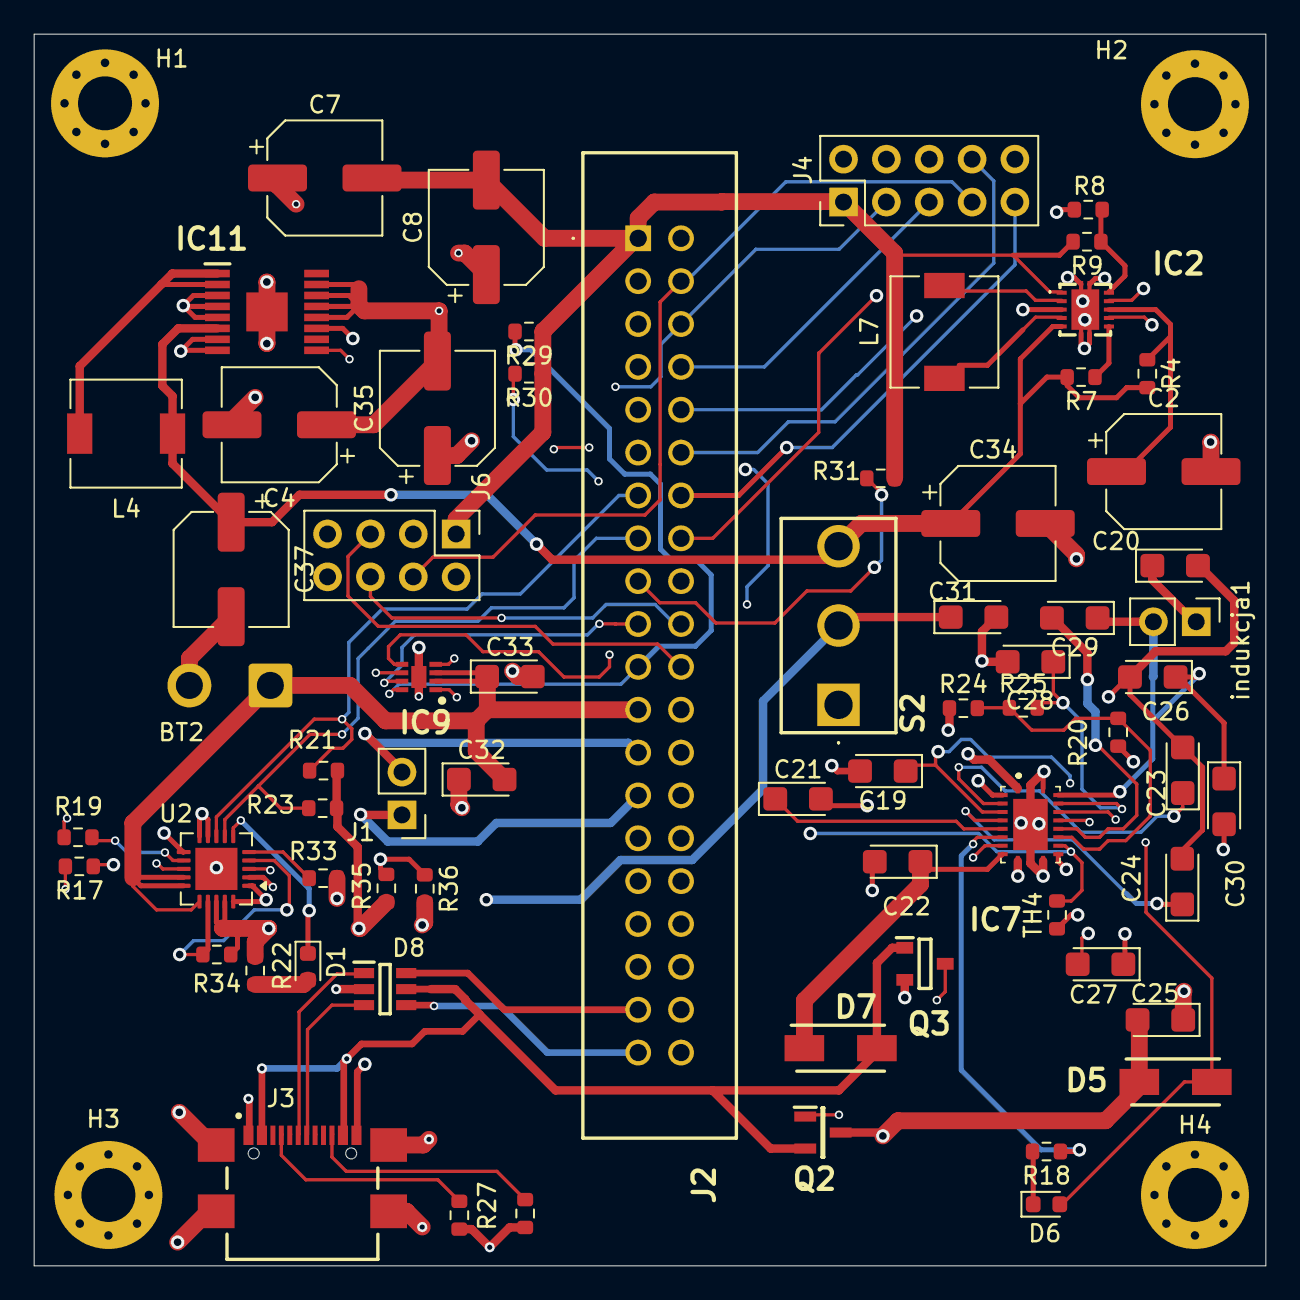
[picture p41: board power_board.kicad_pcb from above]

Board: 4 copper layers, 73.0 x 73.0 mm, 71 parts (0 on the bottom side), 65 nets.
