Szymek200/Smart-ball/PCB/MCU_board/MCU_board.kicad_pcb

## KiCad design PCB/MCU_board/MCU_board.kicad_pcb (2026-05-03)

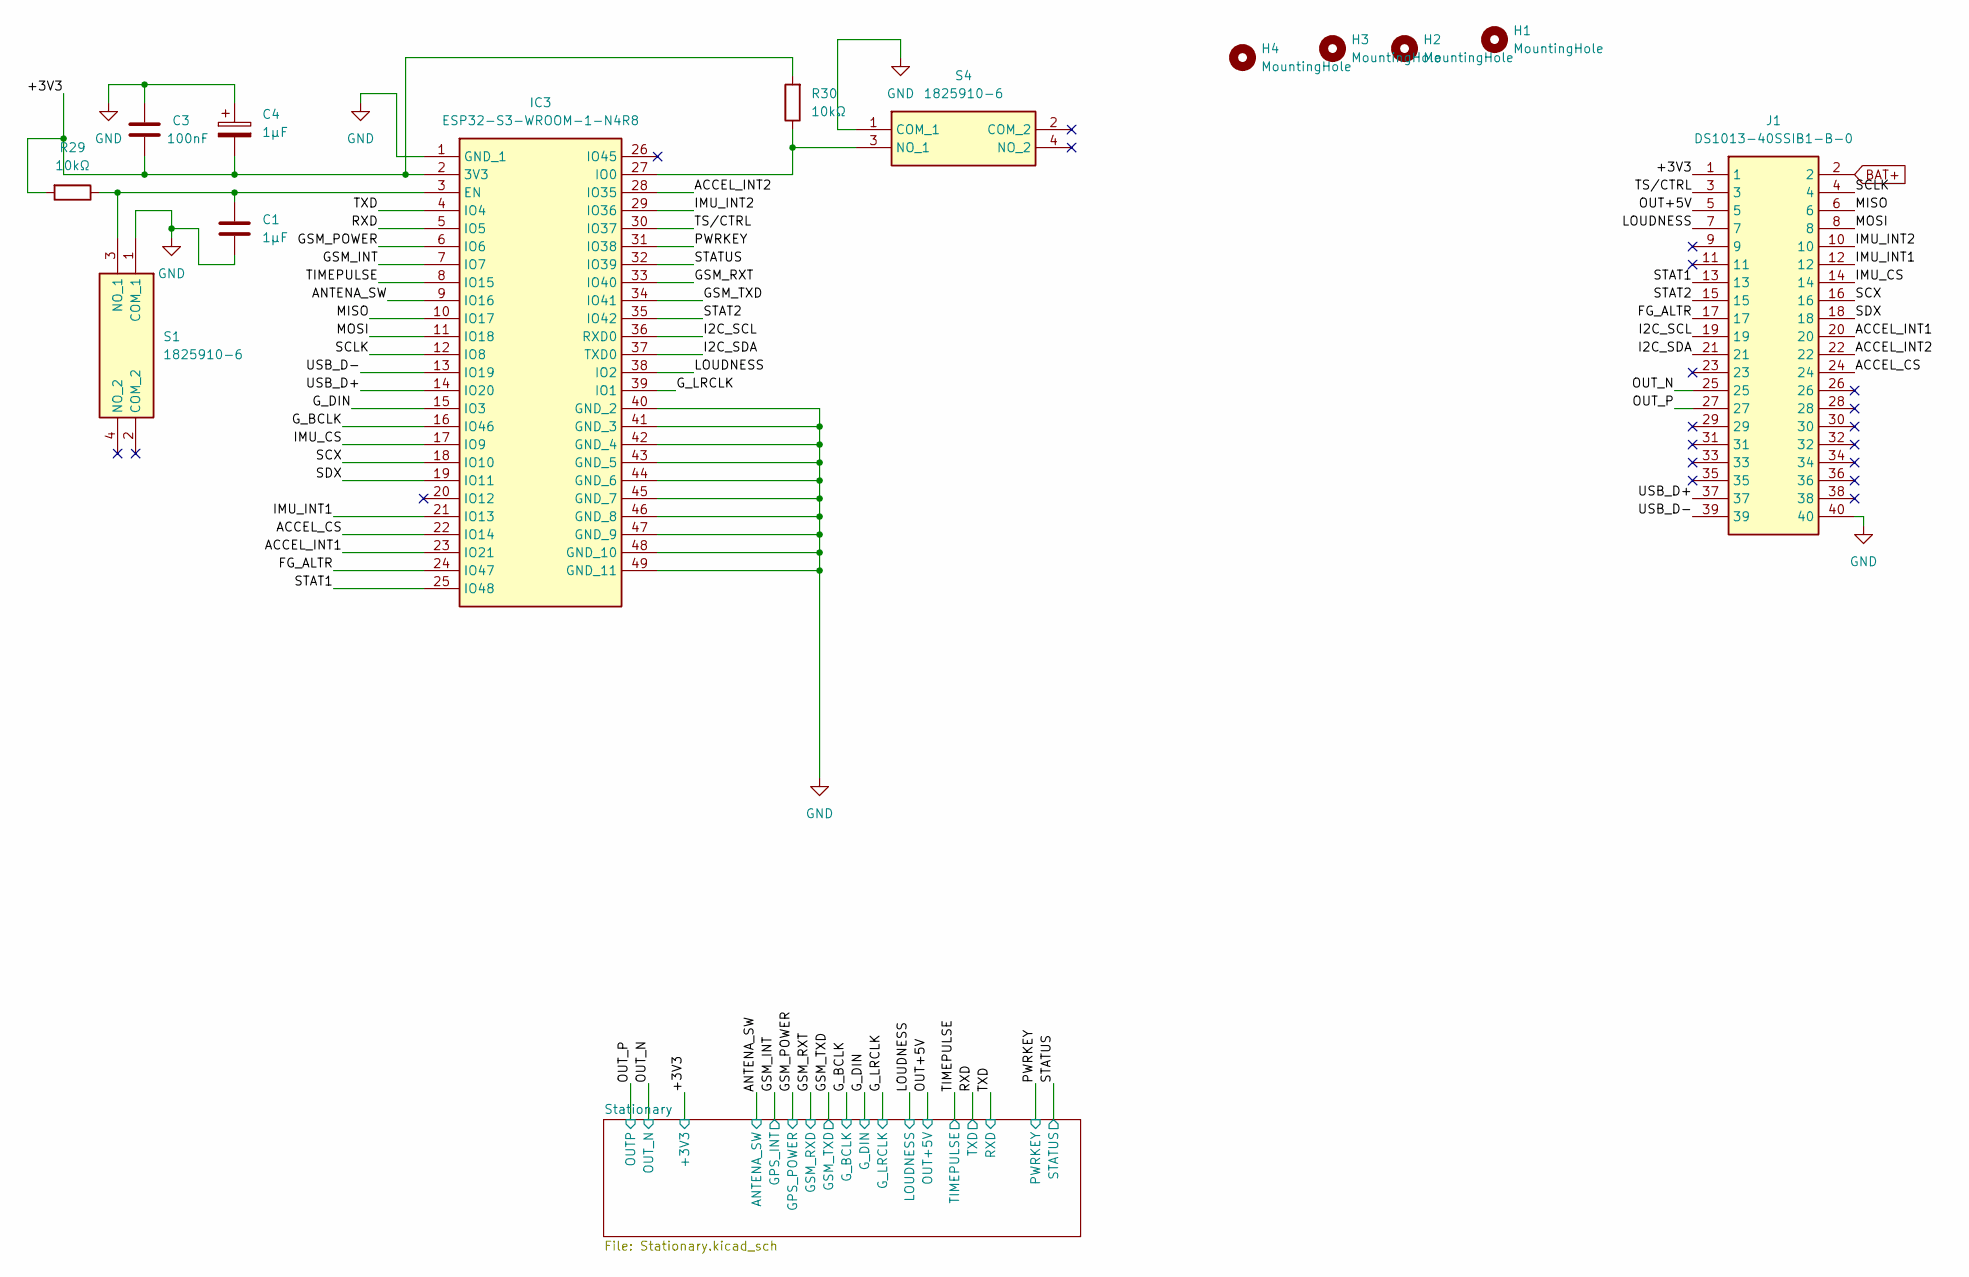
[picture p42: schematic MCU_board.kicad_sch]

Parts:
C1: 1μF; CP_Elec_6.3x5.4
C3: 100nF; CP_Elec_6.3x5.4
C4: 1μF; CP_EIA-3216-18_Kemet-A
H1, H2, H3, H4: MountingHole; MountingHole_3.2mm_M3_Pad_Via
IC3: ESP32-S3-WROOM-1-N4R8; ESP32S3WROOM1N4R8; Mouser Part Number 356-ESP32S3WROM1N4R8
J1: DS1013-40SSIB1-B-0; DS101340SSIB1B0; Manufacturer_Part_Number DS1013-40SSIB1-B-0
R29, R30: 10kΩ; R_0603_1608Metric
S1, S4: 1825910-6; 18259106; Manufacturer_Part_Number 1825910-6

Connections:
/+3V3: C3.2, C4.2, IC3.2 (3V3), J1.1, R29.2, R30.2; also elsewhere on the board
/ACCEL_CS: IC3.22 (IO14), J1.24
/ACCEL_INT1: IC3.23 (IO21), J1.20
/ACCEL_INT2: IC3.28 (IO35), J1.22
/ANTENA_SW: IC3.9 (IO16); also elsewhere on the board
/FG_ALTR: IC3.24 (IO47), J1.17
/GSM_INT: IC3.7 (IO7); also elsewhere on the board
/GSM_POWER: IC3.6 (IO6); also elsewhere on the board
/GSM_RXT: IC3.33 (IO40); also elsewhere on the board
/GSM_TXD: IC3.34 (IO41); also elsewhere on the board
/G_BCLK: IC3.16 (IO46); also elsewhere on the board
/G_DIN: IC3.15 (IO3); also elsewhere on the board
/G_LRCLK: IC3.39 (IO1); also elsewhere on the board
/I2C_SCL: IC3.36 (RXD0), J1.19
/I2C_SDA: IC3.37 (TXD0), J1.21
/IMU_CS: IC3.17 (IO9), J1.14
/IMU_INT1: IC3.21 (IO13), J1.12
/IMU_INT2: IC3.29 (IO36), J1.10
/LOUDNESS: IC3.38 (IO2), J1.7; also elsewhere on the board
/MISO: IC3.10 (IO17), J1.6
/MOSI: IC3.11 (IO18), J1.8
/OUT+5V: J1.5; also elsewhere on the board
/OUT_N: J1.25; also elsewhere on the board
/OUT_P: J1.27; also elsewhere on the board
/PWRKEY: IC3.31 (IO38); also elsewhere on the board
/RXD: IC3.5 (IO5); also elsewhere on the board
/SCLK: IC3.12 (IO8), J1.4
/SCX: IC3.18 (IO10), J1.16
/SDX: IC3.19 (IO11), J1.18
/STAT1: IC3.25 (IO48), J1.13
/STAT2: IC3.35 (IO42), J1.15
/STATUS: IC3.32 (IO39); also elsewhere on the board
/TIMEPULSE: IC3.8 (IO15); also elsewhere on the board
/TS/CTRL: IC3.30 (IO37), J1.3
/TXD: IC3.4 (IO4); also elsewhere on the board
/USB_D+: IC3.14 (IO20), J1.37
/USB_D-: IC3.13 (IO19), J1.39
BAT+: J1.2; also elsewhere on the board
GND: C1.2, C3.1, C4.1, IC3.1 (GND_1), IC3.40 (GND_2), IC3.41 (GND_3), IC3.42 (GND_4), IC3.43 (GND_5), IC3.44 (GND_6), IC3.45 (GND_7), IC3.46 (GND_8), IC3.47 (GND_9), IC3.48 (GND_10), IC3.49 (GND_11), J1.40, S1.1 (COM_1), S4.1 (COM_1); also elsewhere on the board
unnamed: C1.1, IC3.3 (EN), R29.1, S1.3 (NO_1)
unnamed: IC3.27 (IO0), R30.1, S4.3 (NO_1)

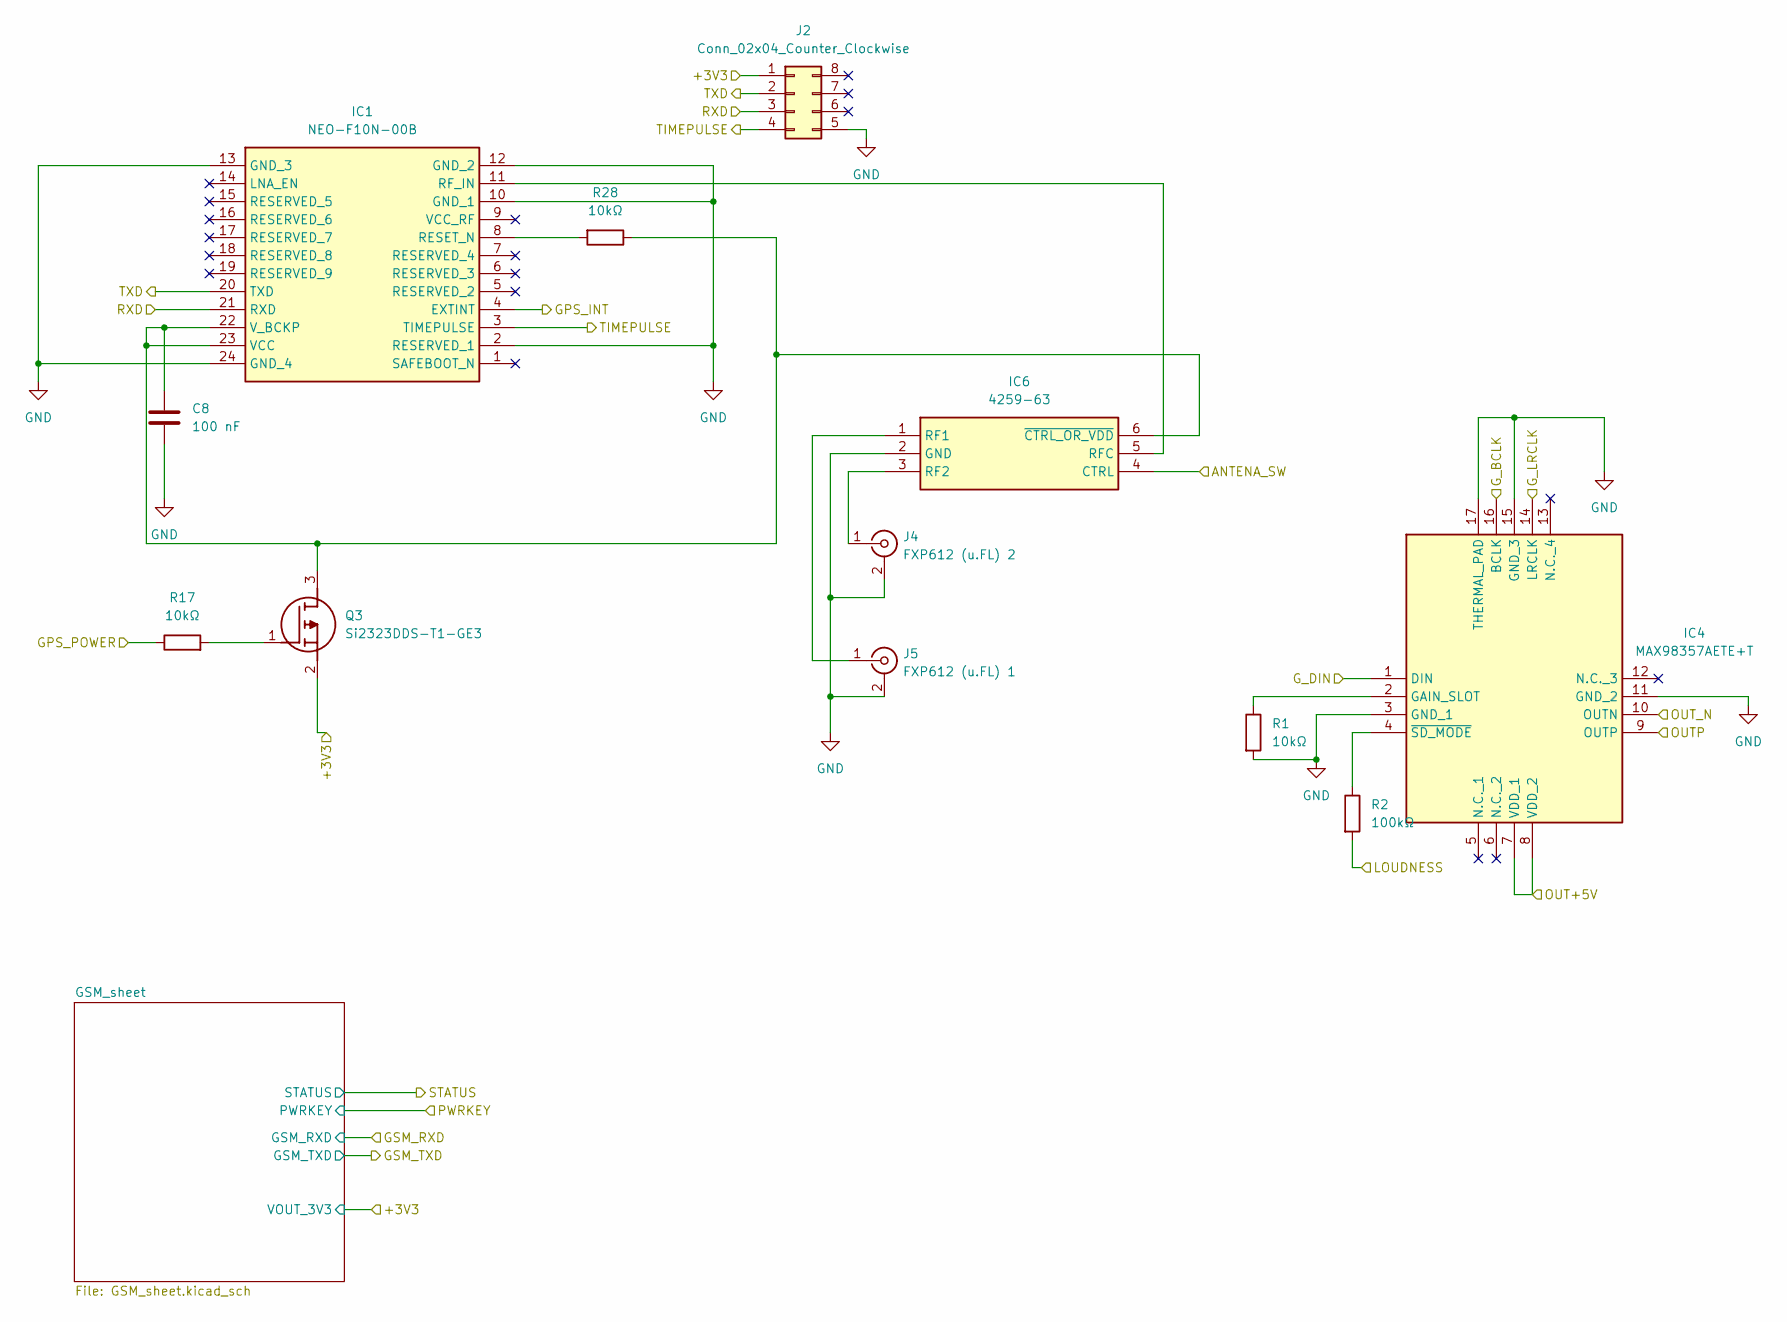
[picture p43: schematic Stationary.kicad_sch]

Parts:
C8: 100 nF; CP_Elec_6.3x5.4
IC1: NEO-F10N-00B; NEOF10N00B; Mouser Part Number 377-NEO-F10N-00B
IC4: MAX98357AETE+T; QFN50P300X300X80-17N; Mouser Part Number 700-MAX98357AETE+T
IC6: 4259-63; SOT65P210X110-6N; Mouser Part Number 81-4259-63
J2: Conn_02x04_Counter_Clockwise; PinHeader_2x04_P2.54mm_Vertical
J4: FXP612 (u.FL) 2; U.FL_Molex_MCRF_73412-0110_Vertical
J5: FXP612 (u.FL) 1; U.FL_Molex_MCRF_73412-0110_Vertical
Q3: Si2323DDS-T1-GE3; SOT-23; Mouser Part Number 78-SI2323DDS-T1-GE3
R1, R17, R28: 10kΩ; R_0603_1608Metric
R2: 100kΩ; R_0603_1608Metric

Connections:
/+3V3: J2.1, Q3.2 (S); also elsewhere on the board
/ANTENA_SW: IC6.4 (CTRL); also elsewhere on the board
/GSM_INT: IC1.4 (EXTINT); also elsewhere on the board
/GSM_POWER: R17.1; also elsewhere on the board
/G_BCLK: IC4.16 (BCLK); also elsewhere on the board
/G_DIN: IC4.1 (DIN); also elsewhere on the board
/G_LRCLK: IC4.14 (LRCLK); also elsewhere on the board
/LOUDNESS: R2.2; also elsewhere on the board
/OUT+5V: IC4.7 (VDD_1), IC4.8 (VDD_2); also elsewhere on the board
/OUT_N: IC4.10 (OUTN); also elsewhere on the board
/OUT_P: IC4.9 (OUTP); also elsewhere on the board
/RXD: IC1.20 (TXD), J2.2; also elsewhere on the board
/TIMEPULSE: IC1.3 (TIMEPULSE), J2.4; also elsewhere on the board
/TXD: IC1.21 (RXD), J2.3; also elsewhere on the board
GND: C8.2, IC1.2 (RESERVED_1), IC1.10 (GND_1), IC1.12 (GND_2), IC1.13 (GND_3), IC1.24 (GND_4), IC4.3 (GND_1), IC4.11 (GND_2), IC4.15 (GND_3), IC4.17 (THERMAL_PAD), IC6.2 (GND), J2.5, J4.2 (Ext), J5.2 (Ext), R1.2; also elsewhere on the board
unnamed: IC1.8 (RESET_N), R28.2
unnamed: IC1.11 (RF_IN), IC6.5 (RFC)
unnamed: C8.1, IC1.22 (V_BCKP), IC1.23 (VCC), IC6.6 (~CTRL_OR_VDD), Q3.3 (D), R28.1
unnamed: IC4.2 (GAIN_SLOT), R1.1
unnamed: IC4.4 (~SD_MODE), R2.1
unnamed: IC6.1 (RF1), J5.1 (In)
unnamed: IC6.3 (RF2), J4.1 (In)
unnamed: Q3.1 (G), R17.2

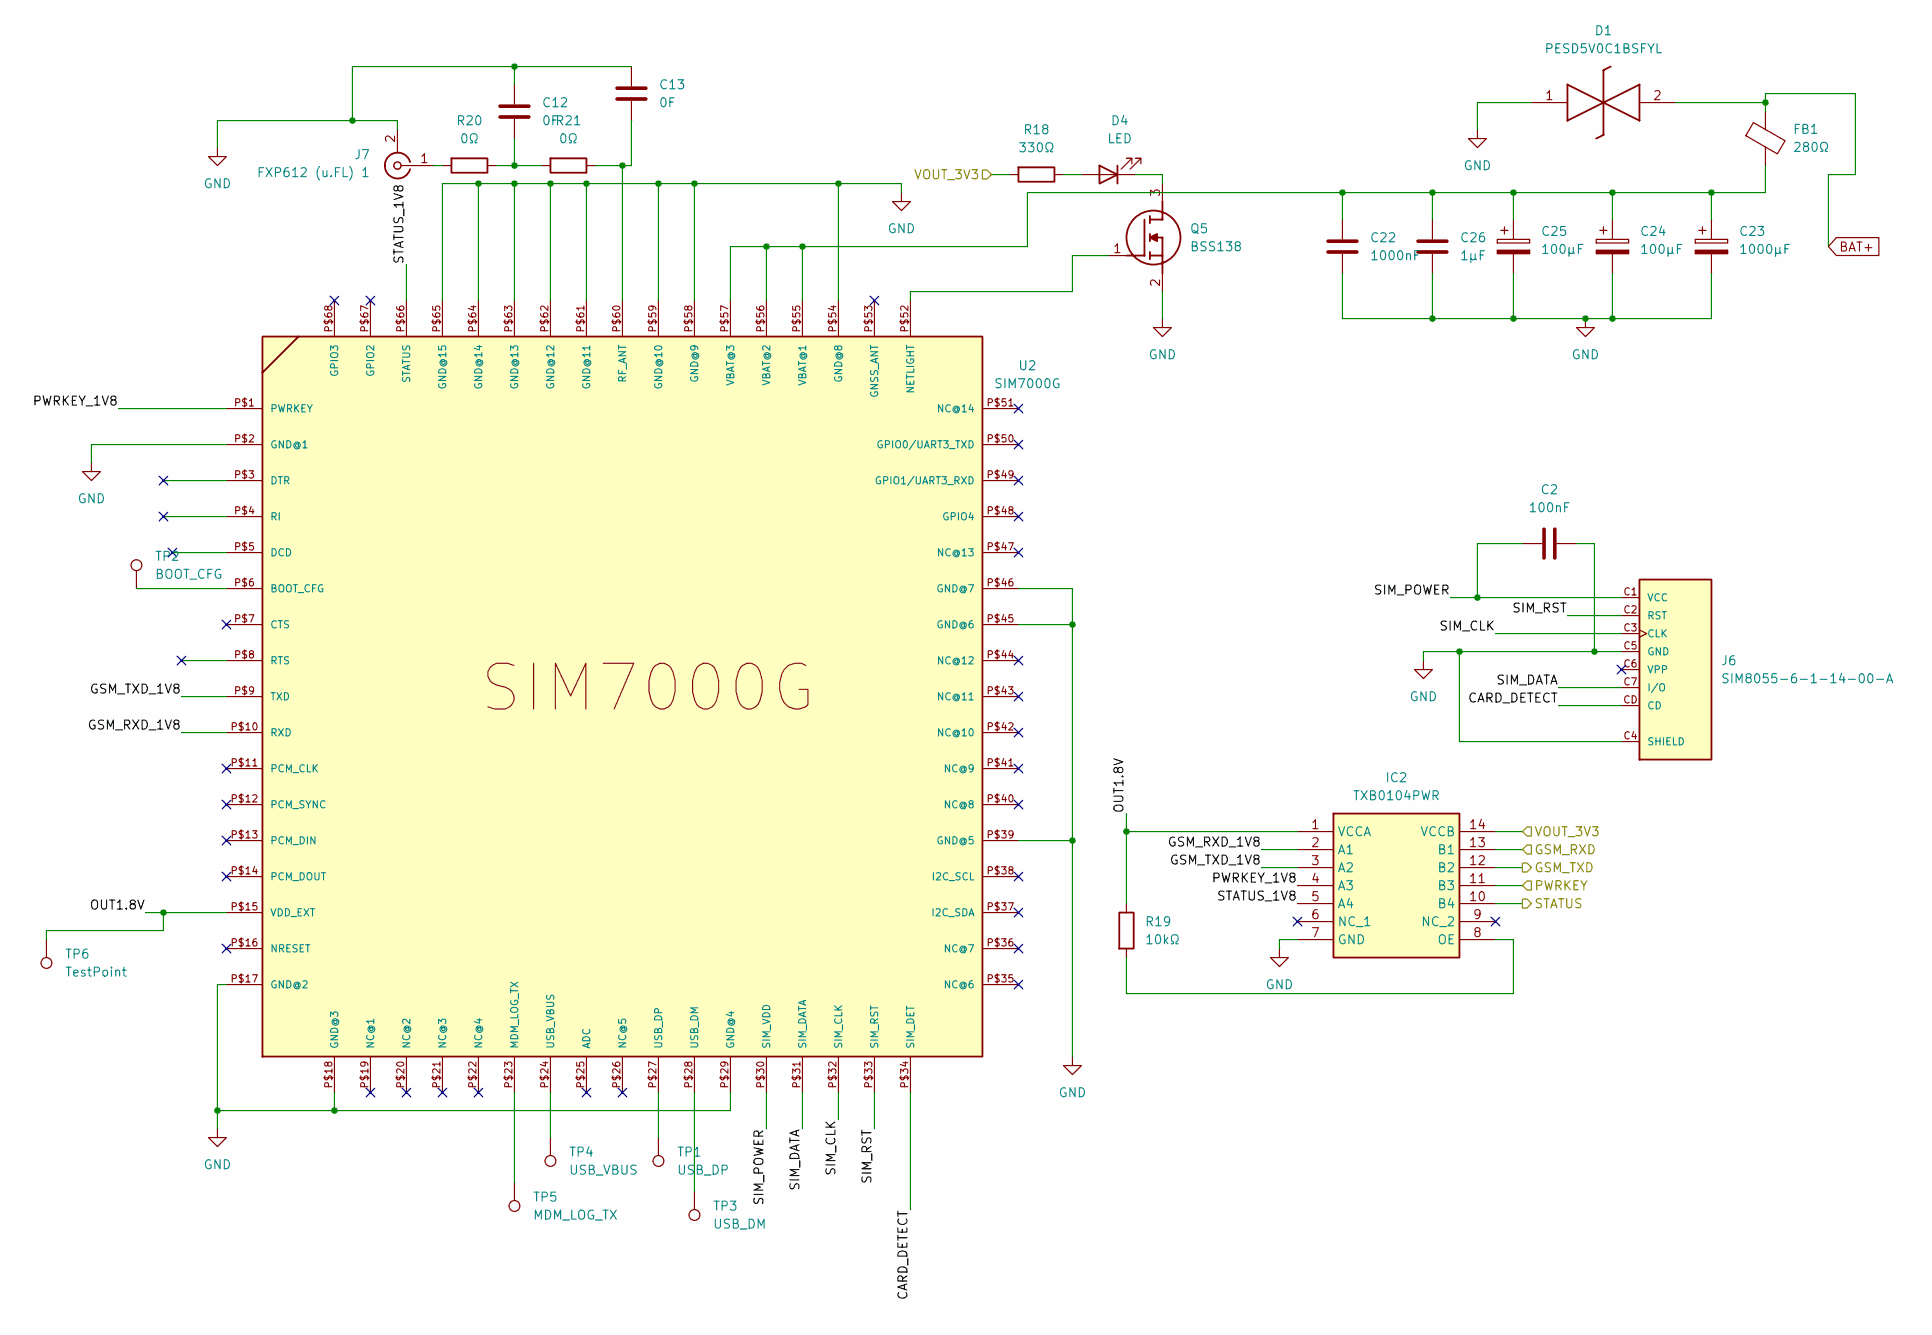
[picture p44: schematic GSM_sheet.kicad_sch]

Parts:
C2: 100nF; CP_Elec_6.3x5.4
C12, C13: 0F; CP_Elec_6.3x5.4
C22: 1000nF; CP_Elec_6.3x5.4
C23: 1000µF; CP_EIA-3216-18_Kemet-A
C24, C25: 100µF; CP_EIA-3216-18_Kemet-A
C26: 1µF; CP_Elec_6.3x5.4
D1: PESD5V0C1BSFYL; PMEG3005AESFYL; Mouser Part Number 771-PESD5V0C1BSFYL
D4: LED; LED_0603_1608Metric
FB1: 280Ω; L_0805_2012Metric_Pad1.05x1.20mm_HandSolder
IC2: TXB0104PWR; SOP65P640X120-14N; Mouser Part Number 595-TXB0104PWR
J6: SIM8055-6-1-14-00-A; GCT_SIM8055-6-1-14-00-A; PARTREV A1
J7: FXP612 (u.FL) 1; U.FL_Molex_MCRF_73412-0110_Vertical
Q5: BSS138; SOT95P240X120-3N; Mouser Part Number 512-BSS138
R18: 330Ω; R_0603_1608Metric
R19: 10kΩ; R_0603_1608Metric
R20, R21: 0Ω; R_0603_1608Metric
TP1: USB_DP; TestPoint_THTPad_D2.0mm_Drill1.0mm
TP2: BOOT_CFG; TestPoint_THTPad_D2.0mm_Drill1.0mm
TP3: USB_DM; TestPoint_THTPad_D2.0mm_Drill1.0mm
TP4: USB_VBUS; TestPoint_THTPad_D2.0mm_Drill1.0mm
TP5: MDM_LOG_TX; TestPoint_THTPad_D2.0mm_Drill1.0mm
TP6: TestPoint; TestPoint_THTPad_D2.0mm_Drill1.0mm
U2: SIM7000G

Connections:
/+3V3: IC2.14 (VCCB), R18.2; also elsewhere on the board
/GSM_RXT: IC2.13 (B1); also elsewhere on the board
/GSM_TXD: IC2.12 (B2); also elsewhere on the board
/PWRKEY: IC2.11 (B3); also elsewhere on the board
/STATUS: IC2.10 (B4); also elsewhere on the board
/Stationary/GSM_sheet/CARD_DETECT: J6.CD, U2.P$34 (SIM_DET)
/Stationary/GSM_sheet/GSM_RXD_1V8: IC2.2 (A1), U2.P$10 (RXD)
/Stationary/GSM_sheet/GSM_TXD_1V8: IC2.3 (A2), U2.P$9 (TXD)
/Stationary/GSM_sheet/OUT1.8V: IC2.1 (VCCA), R19.1, TP6.1 (1_1), U2.P$15 (VDD_EXT)
/Stationary/GSM_sheet/PWRKEY_1V8: IC2.4 (A3), U2.P$1 (PWRKEY)
/Stationary/GSM_sheet/SIM_CLK: J6.C3 (CLK), U2.P$32 (SIM_CLK)
/Stationary/GSM_sheet/SIM_DATA: J6.C7 (I/O), U2.P$31 (SIM_DATA)
/Stationary/GSM_sheet/SIM_POWER: C2.2, J6.C1 (VCC), U2.P$30 (SIM_VDD)
/Stationary/GSM_sheet/SIM_RST: J6.C2 (RST), U2.P$33 (SIM_RST)
/Stationary/GSM_sheet/STATUS_1V8: IC2.5 (A4), U2.P$66 (STATUS)
BAT+: D1.2 (K2), FB1.1; also elsewhere on the board
GND: C2.1, C12.1, C13.1, C22.2, C23.2, C24.2, C25.2, C26.2, D1.1 (K1), IC2.7 (GND), J6.C4 (SHIELD), J6.C5 (GND), J6.C8 (SHIELD), J7.2 (Ext), Q5.2 (S), U2.P$2 (GND@1), U2.P$17 (GND@2), U2.P$18 (GND@3), U2.P$29 (GND@4), U2.P$39 (GND@5), U2.P$45 (GND@6), U2.P$46 (GND@7), U2.P$54 (GND@8), U2.P$58 (GND@9), U2.P$59 (GND@10), U2.P$61 (GND@11), U2.P$62 (GND@12), U2.P$63 (GND@13), U2.P$64 (GND@14), U2.P$65 (GND@15); also elsewhere on the board
unnamed: C12.2, R20.1, R21.2
unnamed: D4.2 (A), R18.1
unnamed: D4.1 (K), Q5.3 (D)
unnamed: IC2.8 (OE), R19.2
unnamed: J7.1 (In), R20.2
unnamed: Q5.1 (G), U2.P$52 (NETLIGHT)
unnamed: TP2.1 (1_1), U2.P$6 (BOOT_CFG)
unnamed: TP5.1 (1_1), U2.P$23 (MDM_LOG_TX)
unnamed: C13.2, R21.1, U2.P$60 (RF_ANT)
unnamed: TP3.1 (1_1), U2.P$28 (USB_DM)
unnamed: TP1.1 (1_1), U2.P$27 (USB_DP)
unnamed: TP4.1 (1_1), U2.P$24 (USB_VBUS)
unnamed: C22.1, C23.1, C24.1, C25.1, C26.1, FB1.2, U2.P$55 (VBAT@1), U2.P$56 (VBAT@2), U2.P$57 (VBAT@3)
