Szymek200/Smart-ball/PCB/MCU_board/MCU_board.kicad_pcb

## KiCad design PCB/MCU_board/MCU_board.kicad_pcb (continued)

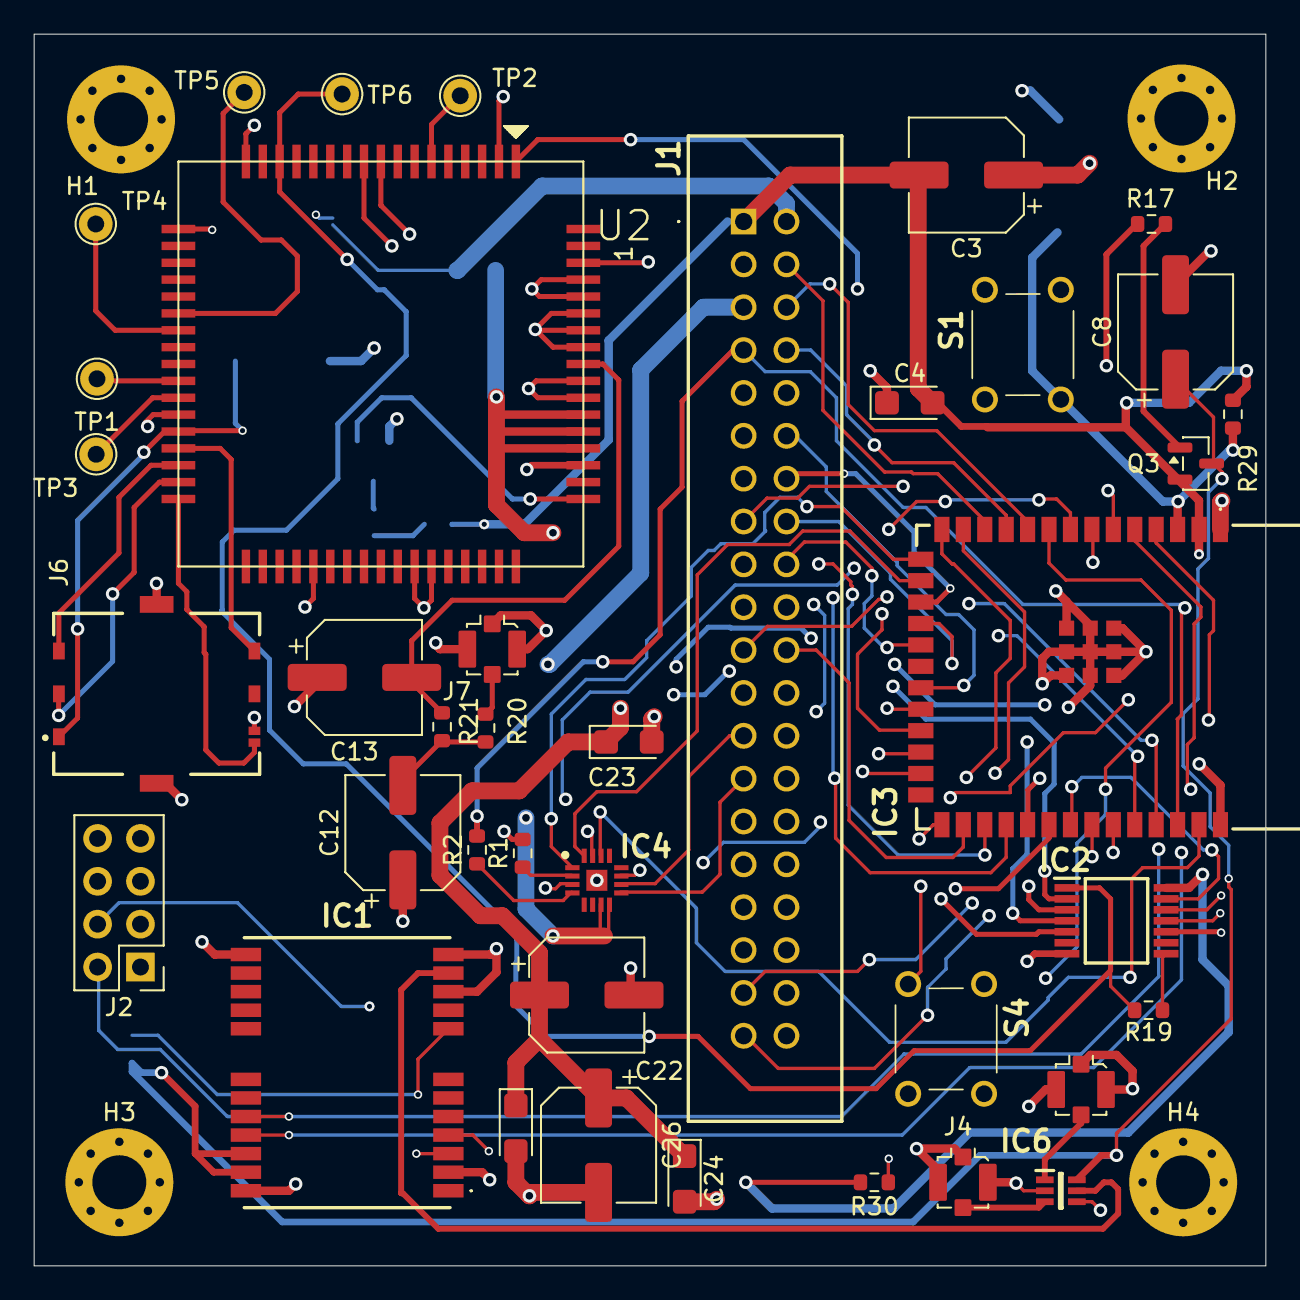
[picture p45: board MCU_board.kicad_pcb from above]

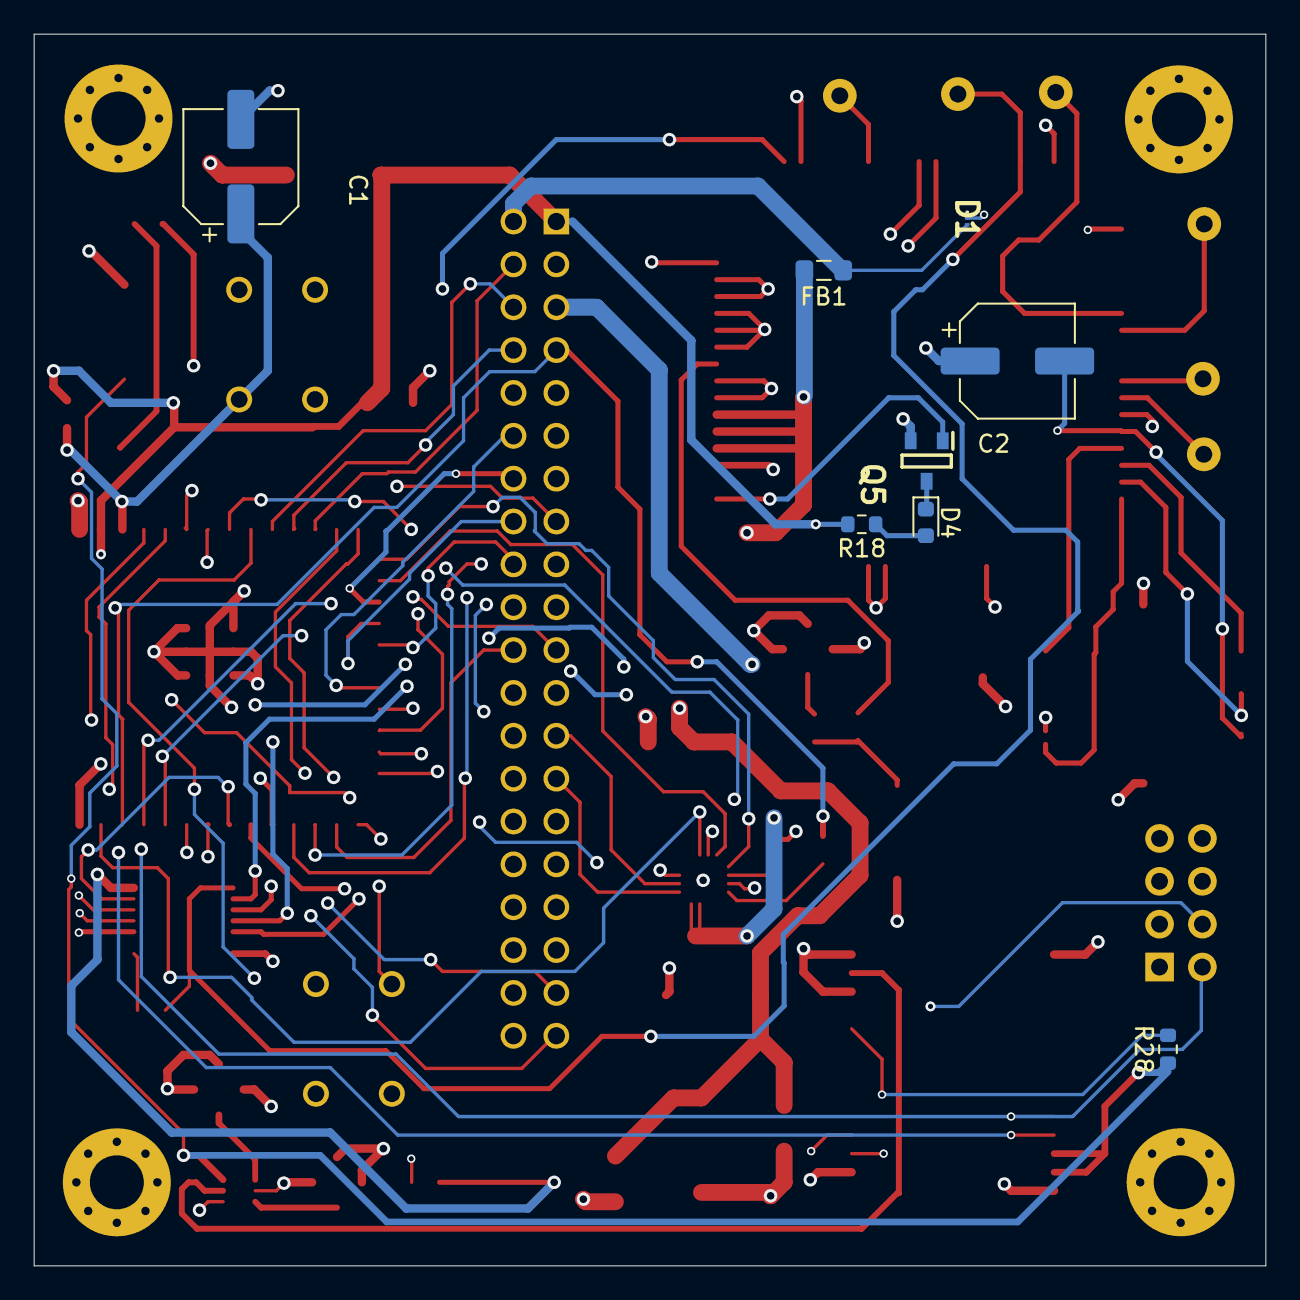
[picture p46: board MCU_board.kicad_pcb from below]

Board: 4 copper layers, 73.0 x 73.0 mm, 51 parts (8 on the bottom side), 72 nets.
