Szymek200/Smart-ball/PCB/smartBall/smartBall.kicad_pcb

## KiCad design PCB/smartBall/smartBall.kicad_pcb (2026-04-16)

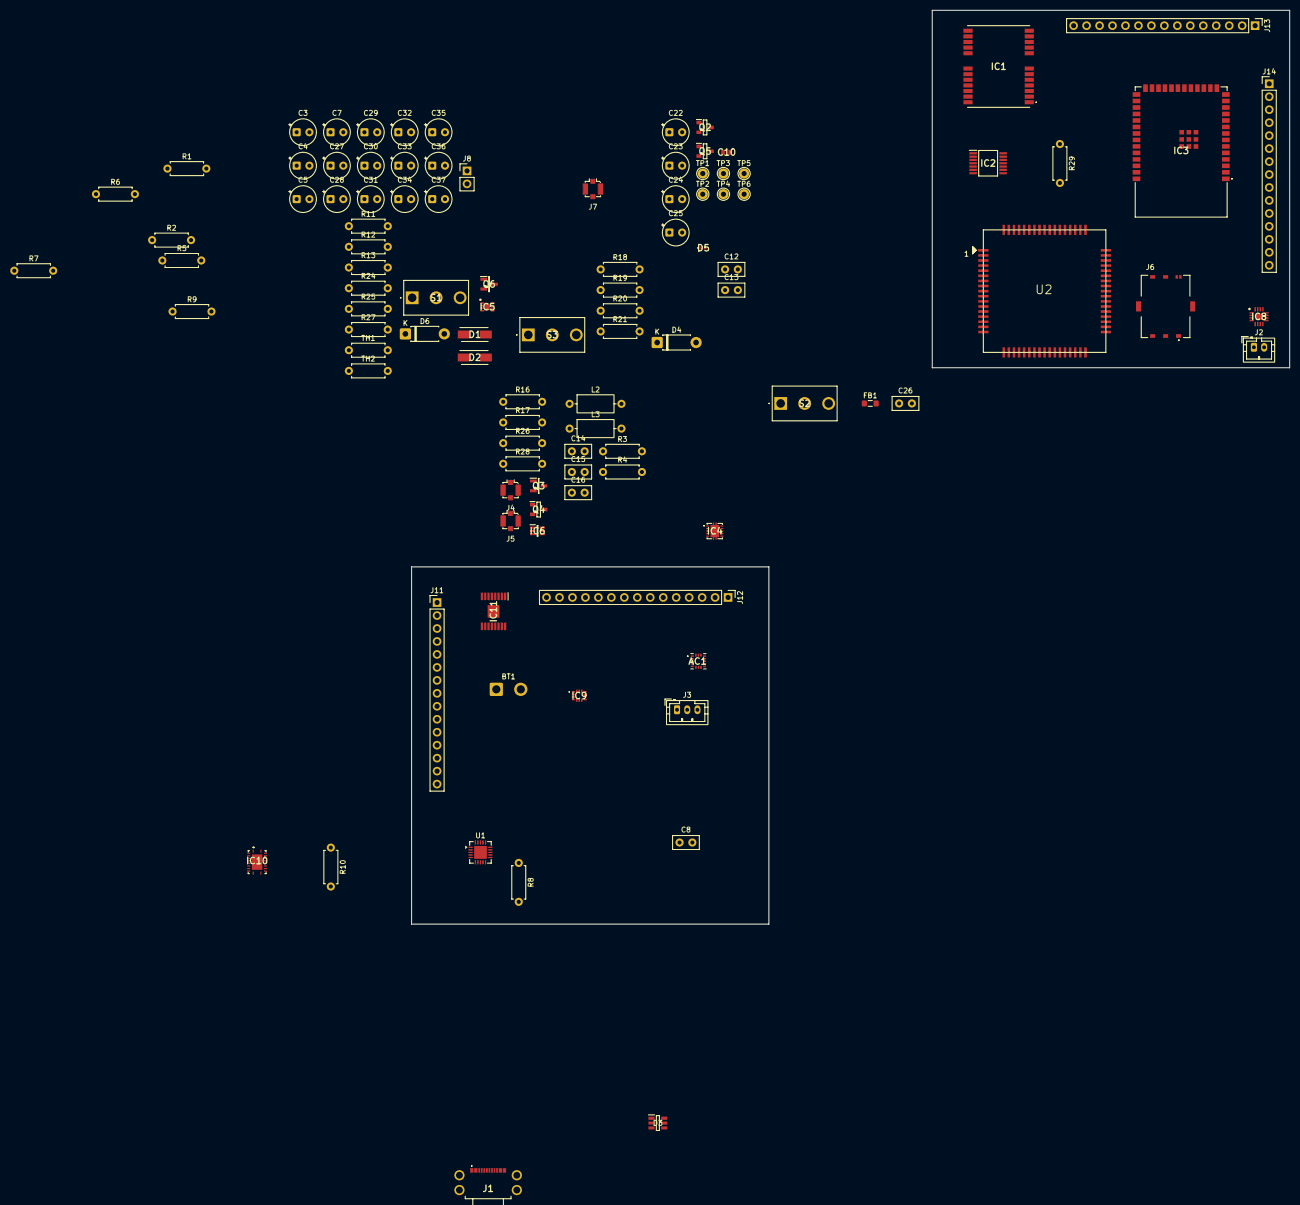
[picture p47: board smartBall.kicad_pcb from above]

Board: 2 copper layers, 103 parts (0 on the bottom side), 126 nets, no tracks yet.

Parts:
AC1: H3LIS331DLTR; LIS3DHTR
BT1: Battery; SolderWire-0.75sqmm_1x02_P4.8mm_D1.25mm_OD2.3mm
C3, C34: 0.47µF; CP_Radial_Tantal_D5.0mm_P2.50mm
C4, C37: C; CP_Radial_Tantal_D5.0mm_P2.50mm
C5, C28, C30, C31, C32, C33: 10µF; CP_Radial_Tantal_D5.0mm_P2.50mm
C7, C27: 4.7µF; CP_Radial_Tantal_D5.0mm_P2.50mm
C8: 100 nF; C_Disc_D5.0mm_W2.5mm_P2.50mm
C10: CL10B104KO8NNNC; CAPC1608X90N
C12, C13: 0F; C_Disc_D5.0mm_W2.5mm_P2.50mm
C14: 10µF; C_Disc_D5.0mm_W2.5mm_P2.50mm
C15: 220µF; C_Disc_D5.0mm_W2.5mm_P2.50mm
C16: 2.2µF; C_Disc_D5.0mm_W2.5mm_P2.50mm
C22: 100nF; CP_Radial_Tantal_D5.0mm_P2.50mm
C23, C24, C25: 100µF; CP_Radial_Tantal_D5.0mm_P2.50mm
C26: 1µF; C_Disc_D5.0mm_W2.5mm_P2.50mm
C29: 0.1µF; CP_Radial_Tantal_D5.0mm_P2.50mm
C35: 20µF; CP_Radial_Tantal_D5.0mm_P2.50mm
C36: 1µF; CP_Radial_Tantal_D5.0mm_P2.50mm
D1, D2: SS14; DIOM5227X270N
D3: USBLC6-2SC6Y; SOT95P280X145-6N
D4, D6: LED; D_DO-41_SOD81_P7.62mm_Horizontal
D5: PESD3V3L1BSLZ
FB1: 280Ω; L_0805_2012Metric_Pad1.05x1.20mm_HandSolder
IC1: NEO-F10N-00B; NEOF10N00B
IC2: TXB0104PWR; SOP65P640X120-14N
IC3: ESP32-S3-WROOM-1-N4R8; ESP32S3WROOM1N4R8
IC4: TPS63000IDRCRQ1
IC5: MAX17048G+T10; SON50P200X200X80-9N-D
IC6: 4259-63; SOT65P210X110-6N
IC8: MAX98357AETE+T; QFN50P300X300X80-17N
IC9: LSM6DSV16BXTR
IC10: BQ51013BRHLR; BQ51050BRHLR
IC11: TPS61032PWP; SOP65P640X120-17N
J1: UJ20-C-H-G-MSMT-R-4C-P16-TR; UJ20CHGMSMTR4CP16TR
J2: Speaker; JST_PH_B2B-PH-K_1x02_P2.00mm_Vertical
J3: QVAR; JST_PH_B3B-PH-K_1x03_P2.00mm_Vertical
J4: FXP612 (u.FL) 2; U.FL_Molex_MCRF_73412-0110_Vertical
J5, J7: FXP612 (u.FL) 1; U.FL_Molex_MCRF_73412-0110_Vertical
J6: SIM8055-6-1-14-00-A; GCT_SIM8055-6-1-14-00-A
J8: Conn_01x02; PinHeader_1x02_P2.54mm_Vertical
J11, J12, J13, J14: Conn_01x15; PinHeader_1x15_P2.54mm_Vertical
L2: 6.8µH; L_Axial_L7.0mm_D3.3mm_P10.16mm_Horizontal_Fastron_MICC
L3: 2.2µH; L_Axial_L7.0mm_D3.3mm_P10.16mm_Horizontal_Fastron_MICC
Q2, Q4, Q5: BSS138; SOT95P240X120-3N
Q3, Q6: Si2323DDS-T1-GE3; SOT95P237X112-3N
R1: 1.5kΩ; R_Axial_DIN0207_L6.3mm_D2.5mm_P7.62mm_Horizontal
R2, R8, R17, R19, R28, R29: 10kΩ; R_Axial_DIN0207_L6.3mm_D2.5mm_P7.62mm_Horizontal
R3: 1MΩ; R_Axial_DIN0207_L6.3mm_D2.5mm_P7.62mm_Horizontal
R4: 178kΩ; R_Axial_DIN0207_L6.3mm_D2.5mm_P7.62mm_Horizontal
R5, R6: 4.7kΩ; R_Axial_DIN0207_L6.3mm_D2.5mm_P7.62mm_Horizontal
R7, R26: 100kΩ; R_Axial_DIN0207_L6.3mm_D2.5mm_P7.62mm_Horizontal
R9: 66Ω; R_Axial_DIN0207_L6.3mm_D2.5mm_P7.62mm_Horizontal
R10: 200Ω; R_Axial_DIN0207_L6.3mm_D2.5mm_P7.62mm_Horizontal
R11, R12: 5.1kΩ; R_Axial_DIN0207_L6.3mm_D2.5mm_P7.62mm_Horizontal
R13: 20kΩ; R_Axial_DIN0207_L6.3mm_D2.5mm_P7.62mm_Horizontal
R16: 680kΩ; R_Axial_DIN0207_L6.3mm_D2.5mm_P7.62mm_Horizontal
R18: 330Ω; R_Axial_DIN0207_L6.3mm_D2.5mm_P7.62mm_Horizontal
R20, R21: 0Ω; R_Axial_DIN0207_L6.3mm_D2.5mm_P7.62mm_Horizontal
R24, R25, R27: 470Ω; R_Axial_DIN0207_L6.3mm_D2.5mm_P7.62mm_Horizontal
S1, S2, S3: SLW-1276864-4A-D; SLW12768644AD
TH1, TH2: 10kΩ; R_Axial_DIN0207_L6.3mm_D2.5mm_P7.62mm_Horizontal
TP1, TP2, TP3, TP4, TP5, TP6: TestPoint; TestPoint_THTPad_D2.0mm_Drill1.0mm
U1: MCP73871-2CA; QFN-20-1EP_4x4mm_P0.5mm_EP2.5x2.5mm
U2: SIM7000G

Connections:
/+3V3: C8.1, IC1.22 (V_BCKP), IC2.14 (VCCB), IC3.2 (3V3), J14.1, Q3.2 (S), R18.2, R29.2
/ACCEL_CS: IC3.22 (IO14), J13.1
/ACCEL_INT1: IC3.23 (IO21), J13.2
/ACCEL_INT2: IC3.28 (IO35), J13.3
/ANTENA_SW: IC3.9 (IO16), IC6.4 (CTRL)
/BCLK: IC3.19 (IO11), J13.4
/DATA_IN: IC3.20 (IO12), J13.5
/FG_ALTR: IC3.24 (IO47), J14.9
/GSM_INT: IC1.4 (EXTINT), IC3.7 (IO7)
/GSM_POWER: IC3.6 (IO6), R17.1
/GSM_RXT: IC2.2 (A1), IC2.13 (B1), IC3.26 (IO45), U2.P$10 (RXD)
/GSM_TXD: IC2.3 (A2), IC2.12 (B2), IC3.27 (IO0), U2.P$9 (TXD)
/G_BCLK: IC3.16 (IO46), IC8.16 (BCLK)
/G_DIN: IC3.15 (IO3), IC8.1 (DIN)
/G_LRCLK: IC3.14 (IO20), IC8.14 (LRCLK)
/I2C_SCL: IC3.36 (RXD0), J14.10
/I2C_SDA: IC3.37 (TXD0), J14.11
/IMU_CS: IC3.17 (IO9), J13.6
/IMU_INT1: IC3.21 (IO13), J13.7
/IMU_INT2: IC3.29 (IO36), J13.8
/LOUDNESS: IC3.13 (IO19), J14.4, Q4.1 (G)
/MISO: IC3.10 (IO17), J13.9
/MOSI: IC3.11 (IO18), J13.10
/OUT+5V: IC8.7 (VDD_1), IC8.8 (VDD_2), J14.3, R16.2, S3.3 (NO)
/PWRKEY: IC2.4 (A3), IC2.11 (B3), IC3.31 (IO38), U2.P$1 (PWRKEY)
/Power/BAT+: BT1.1 (+), C27.2, C29.1, IC5.2 (CELL), IC5.3 (VDD), J11.12, U1.14 (V_{BAT}), U1.15 (V_{BAT}), U1.16 (V_{BAT_SENSE})
/Power/CHARGER_SRC: C28.2, D1.1 (K), Q6.3 (D), R24.2, R25.2, R27.1, U1.2 (VPCC), U1.3 (SEL), U1.4 (PROG2), U1.17 (CE), U1.18 (IN), U1.19 (IN)
/Power/FG_ALRT: IC5.5 (~ALRT), J11.9, R7.2
/Power/I2C_SCL: IC5.7 (SCL), J11.10, R6.2
/Power/I2C_SDA: IC5.8 (SDA), J11.11, R5.2
/Power/Movement/ACCEL_CS: AC1.8 (CS), J12.1
/Power/Movement/ACCEL_INT1: AC1.11 (INT1), J12.2
/Power/Movement/ACCEL_INT2: AC1.9 (INT2), J12.3
/Power/Movement/BCLK: IC9.3 (BCLK), J12.4
/Power/Movement/DATA_IN: IC9.2 (TDMOUT), J12.5
/Power/Movement/IMU_CS: IC9.12 (CS), J12.6
/Power/Movement/IMU_INT1: IC9.4 (INT1), J12.7
/Power/Movement/IMU_INT2: IC9.10 (INT2), J12.8
/Power/Movement/MISO: AC1.7 (SDO_SA0), IC9.1 (SDO/SA0), J12.9
/Power/Movement/MOSI: AC1.6 (SDA_SDI_SDO), IC9.14 (SDA), J12.10
/Power/Movement/SCLK: AC1.4 (SCL_SPC), IC9.13 (SCL), J12.11
/Power/Movement/VOUT_3V3: AC1.1 (VDD_IO), AC1.14 (VDD), IC4.1 (VOUT), IC9.5 (VDD_IO), IC9.8 (VDD), J11.1, R3.2, R5.1, R6.1, R7.1
/Power/Movement/WCLK: IC9.11 (WCLK), J12.12
/Power/STAT1: J11.7, R24.1, U1.8 (STAT1/~LBO)
/Power/STAT2: J11.8, R25.1, U1.7 (STAT2)
/Power/STEP_UP/LOUDNESS: IC11.9 (EN), J11.4
/Power/STEP_UP/OUT+5V: C15.1, C16.2, IC11.12 (FB), IC11.13 (VOUT_1), IC11.14 (VOUT_2), IC11.15 (VOUT_3), J11.3
/Power/TS/CTRL: IC10.13 (TS/CTRL), J11.2, TH2.2
/Power/USB_D+: D3.1 (I/O1_1), D3.6 (I/O1_2), J1.A6 (DP1), J1.B6 (DP2), J11.5
/Power/USB_D-: D3.3 (I/O2_1), D3.4 (I/O2_2), J1.A7 (DN1), J1.B7 (DN2), J11.6
/Power/USB_SRC: C36.1, D2.1 (K), IC10.9 (AD)
/Power/V_SYS: C14.1, IC4.5 (VIN), IC4.6 (EN), IC4.8 (VINA), IC11.6 (VBAT), L2.1, S1.3 (NO)
/RXD: IC1.20 (TXD), IC3.5 (IO5)
/SCLK: IC3.12 (IO8), J13.11
/STAT1: IC3.25 (IO48), J14.7
/STAT2: IC3.34 (IO41), J14.8
/STATUS: IC2.5 (A4), IC2.10 (B4), IC3.32 (IO39), U2.P$66 (STATUS)
/Stationary/GSM_sheet/CARD_DETECT: J6.CD, U2.P$34 (SIM_DET)
/Stationary/GSM_sheet/OUT1.8V: IC2.1 (VCCA), R19.1, TP6.1 (1_1), U2.P$15 (VDD_EXT)
/Stationary/GSM_sheet/SIM_CLK: J6.C3 (CLK), U2.P$32 (SIM_CLK)
/Stationary/GSM_sheet/SIM_DATA: J6.C7 (I/O), U2.P$31 (SIM_DATA)
/Stationary/GSM_sheet/SIM_POWER: C10.1, J6.C1 (VCC), U2.P$30 (SIM_VDD)
/Stationary/GSM_sheet/SIM_RST: J6.C2 (RST), U2.P$33 (SIM_RST)
/TIMEPULSE: IC1.3 (TIMEPULSE), IC3.8 (IO15)
/TS/CTRL: IC3.30 (IO37), J14.2
/TXD: IC1.21 (RXD), IC3.4 (IO4)
/USB_D+: IC3.39 (IO1), J14.5
/USB_D-: IC3.38 (IO2), J14.6
/WCLK: IC3.18 (IO10), J13.12
GND: AC1.5 (GND_1), AC1.10 (RESERVED_1), AC1.12 (GND_2), AC1.13 (GND_3), AC1.15 (RESERVED_2), AC1.16 (GND_4), BT1.2 (-), C7.2, C8.2, C10.2, C12.1, C13.1, C14.2, C15.2, C16.1, C22.2, C23.2, C24.2, C25.2, C26.2, C27.1, C28.1, C29.2, C35.2, C36.2, D3.2 (GND), D5.1 (K1), IC1.2 (RESERVED_1), IC1.5 (RESERVED_2), IC1.6 (RESERVED_3), IC1.7 (RESERVED_4), IC1.10 (GND_1), IC1.12 (GND_2), IC1.13 (GND_3), IC1.15 (RESERVED_5), IC1.16 (RESERVED_6), IC1.17 (RESERVED_7), IC1.18 (RESERVED_8), IC1.19 (RESERVED_9), IC1.24 (GND_4), IC2.7 (GND), IC3.1 (GND_1), IC3.40 (GND_2), IC3.41 (GND_3), IC3.42 (GND_4), IC3.43 (GND_5), IC3.44 (GND_6), IC3.45 (GND_7), IC3.46 (GND_8), IC3.47 (GND_9), IC3.48 (GND_10), IC3.49 (GND_11), IC4.3 (PGND_1), IC4.7 (PS/SYNC), IC4.9 (GND), IC4.11 (PGND_2), IC4.12 (PGND_3), IC4.13 (PGND_4), IC4.14 (PGND_5), IC4.15 (PGND_6), IC5.1 (CTG), IC5.4 (GND), IC5.6 (QSTRT), IC5.9 (EP), IC6.2 (GND), IC8.3 (GND_1), IC8.11 (GND_2), IC8.15 (GND_3), IC8.17 (THERMAL_PAD), IC9.7 (GND), IC10.1 (PGND_1), IC10.10 (EN1), IC10.11 (EN2), IC10.20 (PGND_2), IC10.21 (EP), IC11.3 (PGND_1), IC11.4 (PGND_2), IC11.5 (PGND_3), IC11.7 (LBI), IC11.8 (SYNC), IC11.11 (GND_1), IC11.17 (GND_2), J1.A1 (GND_1), J1.A12 (GND_2), J1.MH1 (MH_1), J1.MH2 (MH_2), J1.MH3 (MH_3), J1.MH4 (MH_4), J3.2, J4.2 (Ext), J5.2 (Ext), J6.C4 (SHIELD), J6.C5 (GND), J6.C8 (SHIELD), J7.2 (Ext), Q2.2 (S), Q4.2 (S), Q5.2 (S), R2.2, R4.2, R8.2, R10.1, R11.2, R12.2, TH1.2, TH2.1, U1.9 (~TE), U1.10 (V_{SS}), U1.11 (V_{SS}), U1.21 (V_{SS}), U2.P$2 (GND@1), U2.P$17 (GND@2), U2.P$18 (GND@3), U2.P$29 (GND@4), U2.P$39 (GND@5), U2.P$45 (GND@6), U2.P$46 (GND@7), U2.P$54 (GND@8), U2.P$58 (GND@9), U2.P$59 (GND@10), U2.P$61 (GND@11), U2.P$62 (GND@12), U2.P$63 (GND@13), U2.P$64 (GND@14), U2.P$65 (GND@15)
unnamed: C12.2, R20.1, R21.2
unnamed: C5.2, D1.2 (A), D6.2 (A)
unnamed: D2.2 (A), D3.5 (VBUS), J1.A4 (VBUS_1), J1.A9 (VBUS_2), Q6.2 (S)
unnamed: D4.2 (A), R18.1
unnamed: D4.1 (K), Q5.3 (D)
unnamed: D5.2 (K2), FB1.1, S2.3 (NO)
unnamed: D6.1 (K), R1.2
unnamed: IC1.8 (RESET_N), R28.2
unnamed: IC1.11 (RF_IN), IC6.5 (RFC)
unnamed: IC1.23 (VCC), IC6.6 (~CTRL_OR_VDD), Q3.3 (D), R28.1
unnamed: IC2.8 (OE), R19.2
unnamed: IC3.3 (EN), R29.1
unnamed: IC4.10 (FB), R3.1, R4.1
unnamed: IC4.4 (L1), L3.2
unnamed: IC4.2 (L2), L3.1
unnamed: IC6.1 (RF1), J5.1 (In)
unnamed: IC6.3 (RF2), J4.1 (In)
unnamed: IC8.2 (GAIN_SLOT), R26.1
unnamed: IC8.10 (OUTN), J2.2
unnamed: IC8.9 (OUTP), J2.1
unnamed: IC8.4 (~SD_MODE), R16.1
unnamed: IC9.6 (AH1/QVAR1), J3.1
unnamed: IC9.9 (AH2/QVAR2), J3.3
unnamed: C30.2, C31.2, C34.2, C37.2, IC10.2 (AC1)
unnamed: C3.1, C4.1, C32.1, C33.1, IC10.19 (AC2), J8.2
unnamed: C30.1, C34.1, IC10.3 (BOOT1), IC10.5 (CLAMP1), IC10.8 (~AD-EN), Q6.1 (G)
unnamed: C32.2, IC10.17 (BOOT2)
unnamed: C3.2, IC10.16 (CLAMP2)
unnamed: C31.1, IC10.6 (COMM1)
unnamed: C33.2, IC10.15 (COMM2)
unnamed: IC10.14 (FOD), R9.1, R10.2, R13.1
unnamed: IC10.12 (ILIM), R9.2
unnamed: C5.1, IC10.4 (OUT)
unnamed: C35.1, IC10.18 (RECT), R13.2
unnamed: IC10.7 (~CHG), R1.1
unnamed: IC11.1 (SW_1), IC11.2 (SW_2), L2.2
unnamed: J1.A5 (CC1), R12.1
unnamed: J1.B5 (CC2), R11.1
unnamed: J7.1 (In), R20.2
unnamed: C4.2, C37.1, J8.1
unnamed: Q3.1 (G), R17.2
unnamed: Q4.3 (D), R26.2
unnamed: Q5.1 (G), U2.P$52 (NETLIGHT)
unnamed: C7.1, S1.2 (COM), U1.1 (OUT), U1.20 (OUT)
unnamed: S2.2 (COM), S3.2 (COM)
unnamed: R2.1, U1.13 (PROG1)
unnamed: R8.1, U1.12 (PROG3)
unnamed: TH1.1, U1.5 (THERM)
unnamed: R27.2, U1.6 (~PG)
unnamed: TP2.1 (1_1), U2.P$6 (BOOT_CFG)
unnamed: TP5.1 (1_1), U2.P$23 (MDM_LOG_TX)
unnamed: C13.2, R21.1, U2.P$60 (RF_ANT)
unnamed: TP3.1 (1_1), U2.P$28 (USB_DM)
unnamed: TP1.1 (1_1), U2.P$27 (USB_DP)
unnamed: TP4.1 (1_1), U2.P$24 (USB_VBUS)
unnamed: C22.1, C23.1, C24.1, C25.1, C26.1, FB1.2, U2.P$55 (VBAT@1), U2.P$56 (VBAT@2), U2.P$57 (VBAT@3)
