Szymek200/Smart-ball/(commit log)

2025-10-07 skonczona prezentacja
    [porownanie komponentow.xlsx, wyliczenie przyspiesznia.xlsx]
2025-11-12 pomiary z czujnikow
    [LiPoChargerBooster5V1A_v10.brd, LiPoChargerBooster5V1A_v10.sch, SparkFun_Tri_Axis_Accel_Breakout-H3LIS331DL.brd, SparkFun_Tri_Axis_Accel_Breakout-H3LIS331DL.sch]
2026-02-28 organising docs
    [LiPoChargerBooster5V1A_v10.brd, LiPoChargerBooster5V1A_v10.sch, SparkFun_Tri_Axis_Accel_Breakout-H3LIS331DL.brd, SparkFun_Tri_Axis_Accel_Breakout-H3LIS331DL.sch, porownanie komponentow.xlsx]
2026-03-06 added readme files
    [Smart_ball_schematic.kicad_pcb, Smart_ball_schematic.kicad_sch, box_body.3mf, sfera_body.3mf]
2026-04-05 first shot schematic diagram
    [4259-63.SchLib, 4259-63.stp, ADM7155ACPZ-04-R7.SchLib, ADM7155ACPZ-04-R7.stp, BQ51013BRHLR.stp, BSS138.SchLib, BSS138.stp, BSS84.SchLib]
2026-04-05 cleaning repository
    [4259-63.SchLib, 4259-63.stp, ADM7155ACPZ-04-R7.SchLib, ADM7155ACPZ-04-R7.stp, BQ51013BRHLR.stp, BSS138.SchLib, BSS138.stp, BSS84.SchLib]
2026-04-08 schematic ready
    [GSM_sheet.kicad_sch, Movement.kicad_sch, PESD3V3L1BSLZ.stp, Power.kicad_sch, STEP_UP.kicad_sch, Stationary.kicad_sch, smartBall.kicad_sch]
2026-04-08 footprints assigned
    [GSM_sheet.kicad_sch, Movement.kicad_sch, Power.kicad_sch, STEP_UP.kicad_sch, Stationary.kicad_sch, smartBall.kicad_pcb, smartBall.kicad_sch]
2026-04-09 pcb start
    [smartBall.kicad_pcb]
2026-04-14 updated to hierarchical labels
    [GSM_sheet.kicad_sch, Movement.kicad_sch, Power.kicad_sch, STEP_UP.kicad_sch, Stationary.kicad_sch, smartBall.kicad_pcb, smartBall.kicad_sch]
2026-04-15 new footprints assigned
    [GSM_sheet.kicad_sch, STEP_UP.kicad_sch, smartBall.kicad_pcb, smartBall.kicad_sch]
2026-04-15 last modifications schematic
    [GSM_sheet.kicad_sch, Movement.kicad_sch, Power.kicad_sch, STEP_UP.kicad_sch, Stationary.kicad_sch, smartBall.kicad_pcb, smartBall.kicad_sch]
2026-04-15 grouping things on pcb
    [Movement.kicad_sch, Power.kicad_sch, STEP_UP.kicad_sch, power_board.kicad_pcb, power_board.kicad_sch]
2026-04-15 everything on pcb
    [power_board.kicad_pcb]
2026-04-15 routing done
    [power_board.kicad_pcb]
2026-04-15 chips on pcb
    [GSM_sheet.kicad_sch, MCU_board.kicad_pcb, MCU_board.kicad_sch, Stationary.kicad_sch, smartBall.kicad_sch]
2026-04-15 routing and holes added
    [GSM_sheet.kicad_sch, MCU_board.kicad_pcb, MCU_board.kicad_sch, Stationary.kicad_sch]
2026-04-16 programming MCU pins
    [GSM_sheet.kicad_sch, MCU_board.kicad_sch]
2026-04-16 everything before jlc template
    [1825910-6.stp, DS1013-20SSIB1-B-0.stp, DS1013-40SSIB1-B-0.stp, GSM_sheet.kicad_sch, MCU_board.kicad_pcb, MCU_board.kicad_sch, Movement.kicad_sch, SS14MDP2.stp]
2026-04-18 working on routing
    [power_board.kicad_pcb]
2026-04-19 verifying schematic and 3V8 power for gsm
    [2N7002.stp, GSM_sheet.kicad_sch, MCU_board.kicad_sch, MIC29302WU.stp, PESD5V0C1BSFYL.stp, STEP_UP.kicad_sch, Stationary.kicad_sch, TPS6213013AQRGTTQ1.stp]
2026-04-19 induction verified
    [power_board.kicad_sch]
2026-04-20 ECR passed
    [GSM_sheet.kicad_sch, MCU_board.kicad_sch, Movement.kicad_sch, STEP_UP.kicad_sch, Stationary.kicad_sch, power_board.kicad_pcb, power_board.kicad_sch]
2026-04-21 routing on your own
    [MCU_board.kicad_pcb]
2026-04-21 two layers routing done
    [power_board.kicad_pcb, power_board.kicad_sch]
2026-04-22 own routes with errors done
    [power_board.kicad_pcb, power_board.kicad_sch]
2026-04-23 most errors solved
    [power_board.kicad_pcb]
2026-04-23 DRC passed
    [GSM_sheet.kicad_sch, MCU_board.kicad_pcb]
2026-04-23 boards done
    [components_shopping.xlsx, power_board.kicad_pcb]
2026-04-24 everything checked
    [GSM_sheet.kicad_sch, MCU_board.kicad_pcb, MCU_board.kicad_sch]
2026-04-24 everything done before changing footprints
    [MCU_board-B_Cu.gbr, MCU_board-B_Mask.gbr, MCU_board-B_Paste.gbr, MCU_board-B_Silkscreen.gbr, MCU_board-Edge_Cuts.gbr, MCU_board-F_Cu.gbr, MCU_board-F_Mask.gbr, MCU_board-F_Paste.gbr]
2026-04-28 before deleting C10
    [MCU_board.kicad_pcb]
2026-04-28 all my pcb
    [MCU_board.csv, MCU_board.kicad_pcb, Movement.kicad_sch, bom.csv, bom_corrected.csv, bom_csv_good.csv, bom_good.csv, boom_final.csv]
2026-04-30 imu from board
    [Movement.kicad_sch, STEP_UP.kicad_sch, power_board.kicad_pcb, power_board.kicad_sch]
2026-04-30 accel changed to goldpin
    [Movement.kicad_sch, power_board.kicad_pcb]
2026-04-30 ATA connector updated
    [MCU_board.kicad_pcb, MCU_board.kicad_sch]
2026-05-01 before smd
    [STEP_UP.kicad_sch, bom.csv, boom_final.csv, designators.csv, positions.csv, pow_jlc_bom.csv, pow_jlc_clp.csv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]
2026-05-02 goldpins on one side
    [STEP_UP.kicad_sch, power_board.kicad_pcb]
2026-05-03 modified gnd
    [GSM_sheet.kicad_sch, MCU_board.kicad_pcb, MCU_board.kicad_sch, STEP_UP.kicad_sch, Stationary.kicad_sch, bom.csv, bom_corrected.csv, designators.csv]
2026-05-03 bought pcbs
    [MCU_board.kicad_pcb, Movement.kicad_sch, Power.kicad_sch, STEP_UP.kicad_sch, bom.csv, buying_componets.xlsx, combined_MCU.xlsx, combined_power.csv]
2026-05-24 restoring data for soldering
    [Movement.kicad_sch, Power.kicad_sch, STEP_UP.kicad_sch, power_board.kicad_pcb, power_board.kicad_sch]
2026-06-03 accel and imu in two tasks
2026-06-08 generall code for all sensors
2026-07-18 works without wifi
    [partitions.csv]
2026-07-19 spiffs cancelled, nvs added
    [partitions.csv]
2026-07-23 ble on dev board works
2026-08-22 updated documents'
    [BoxDolASCII.stl, BoxDolBin.stl, BoxGoraASCII.stl, BoxGoraBin.stl, PodstawaASCII.stl, PodstawaBin.stl, PokrywkaASCII.stl, PokrywkaBin.stl]
2026-10-07 Replacing submodules with clean ST drivers (lis331 i lsm6)
